taitannguyen17022005-dev/BEE-1012-PAY-IF-V110/08_REF/CONNECTOR_EXP_3.png

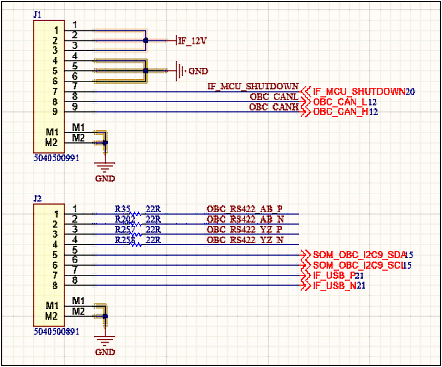
08_REF/CONNECTOR_EXP_3.png
