taitannguyen17022005-dev/BEE-1012-PAY-IF-V110/08_REF/CONNECTOR_INTERFACE_5.png

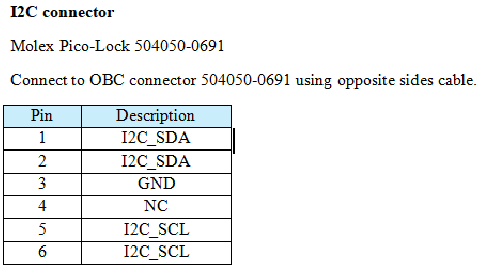
08_REF/CONNECTOR_INTERFACE_5.png
