taitannguyen17022005-dev/BEE-1012-PAY-IF-V110/08_REF/FPGA_PART1_2.png

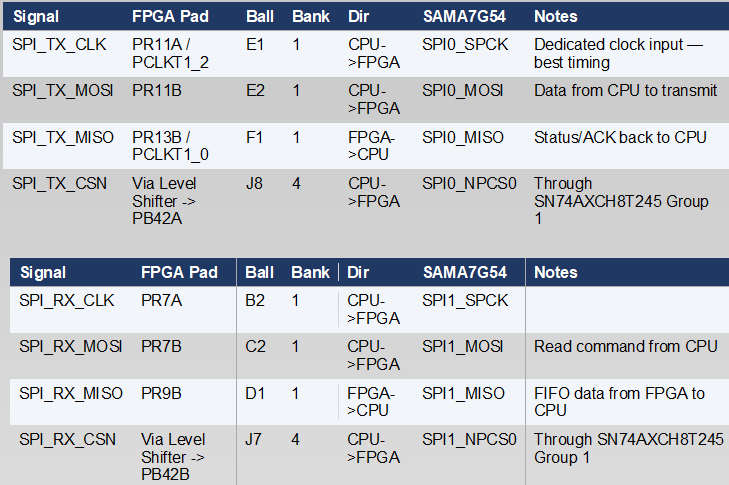
08_REF/FPGA_PART1_2.png
