taitannguyen17022005-dev/BEE-1012-PAY-IF-V110/08_REF/PowerTree.png

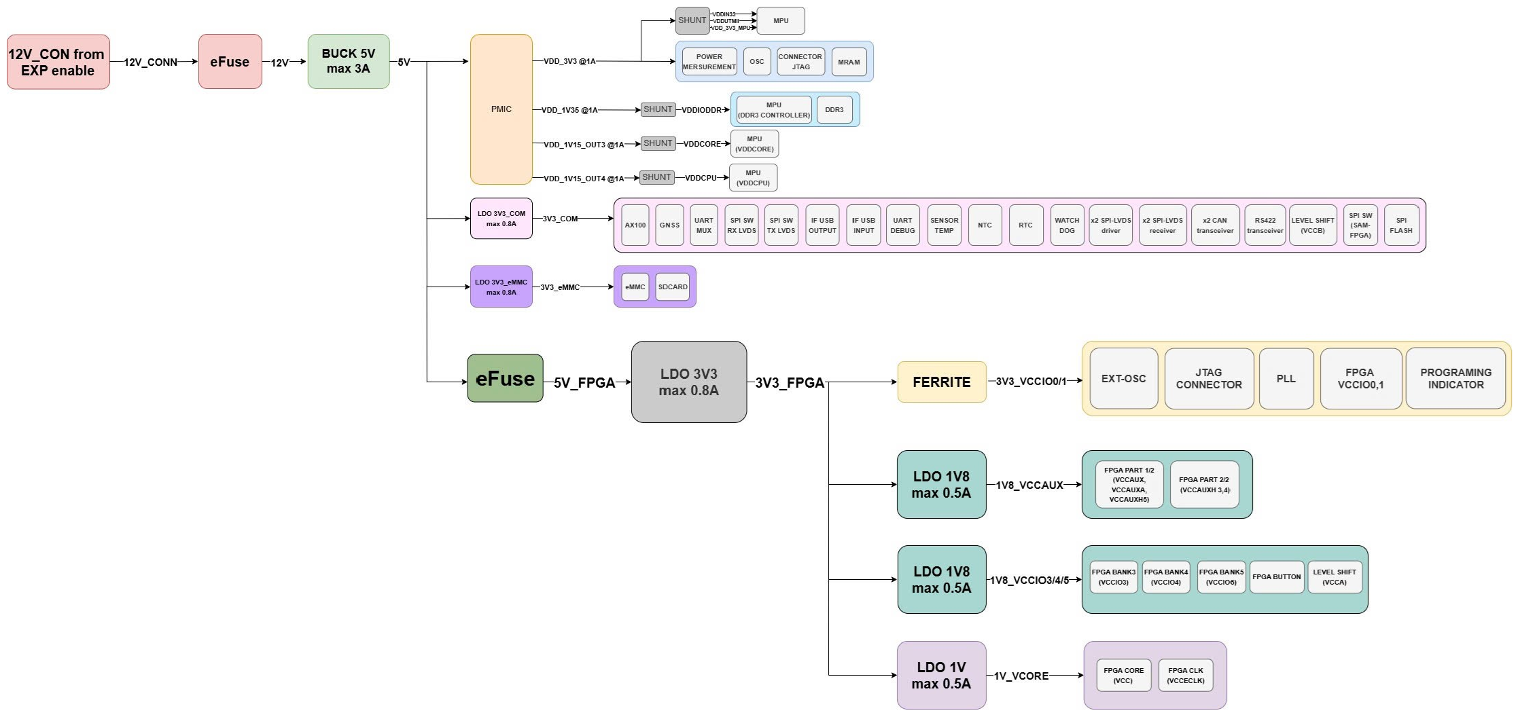
08_REF/PowerTree.png
