taitannguyen17022005-dev/BEE-1012-PAY-IF-V110/08_REF/SAMA7G54_MPU.png

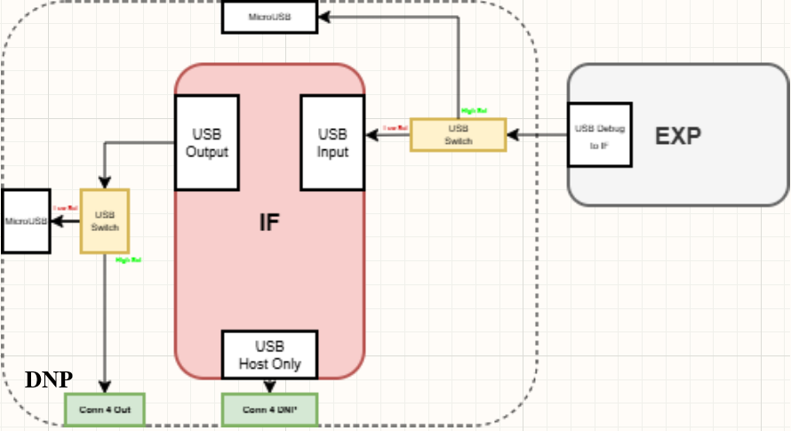
08_REF/SAMA7G54_MPU.png
