taitannguyen17022005-dev/BEE-1012-PAY-IF-V110/08_REF/SN74LV4052APWR.png

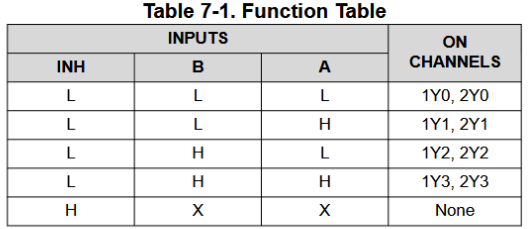
08_REF/SN74LV4052APWR.png
