taitannguyen17022005-dev/BEE-1012-PAY-IF-V110/08_REF/USB_SWITCH.png

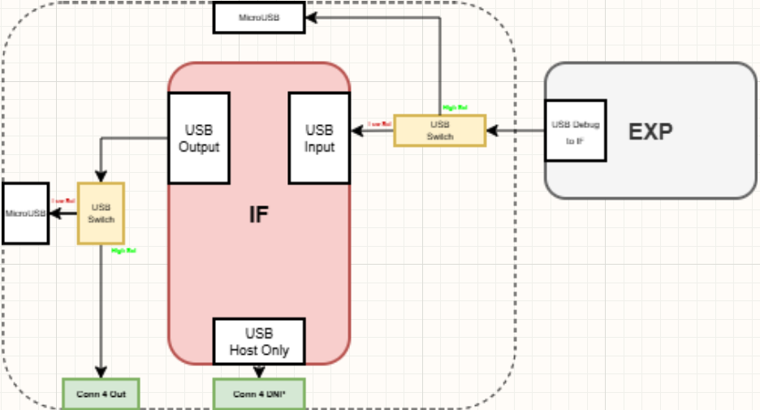
08_REF/USB_SWITCH.png
