taitannguyen17022005-dev/BEE-1012-PAY-IF-V110/09_LIB/Jumpers/Jumper2-blue.step

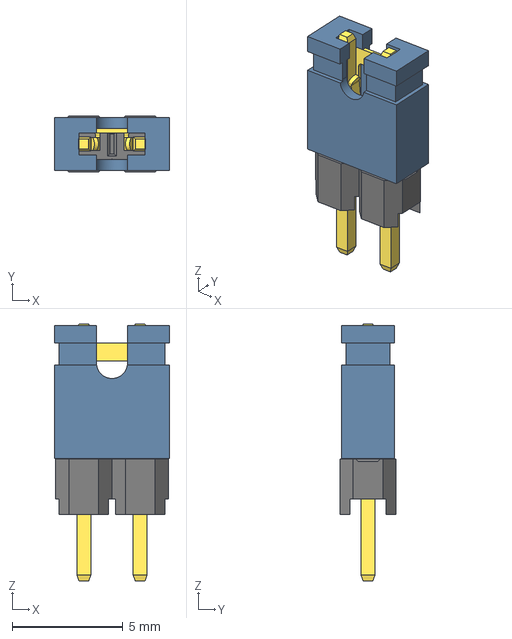
[picture p40: CAD file, 2026-08-20]
09_LIB/Jumpers/Jumper2-blue.step
5.20 x 2.54 x 11.6 mm
