taitannguyen17022005-dev/BEE-1012-PAY-IF-V110/09_LIB/TFBGA343_4HB_MCH.step

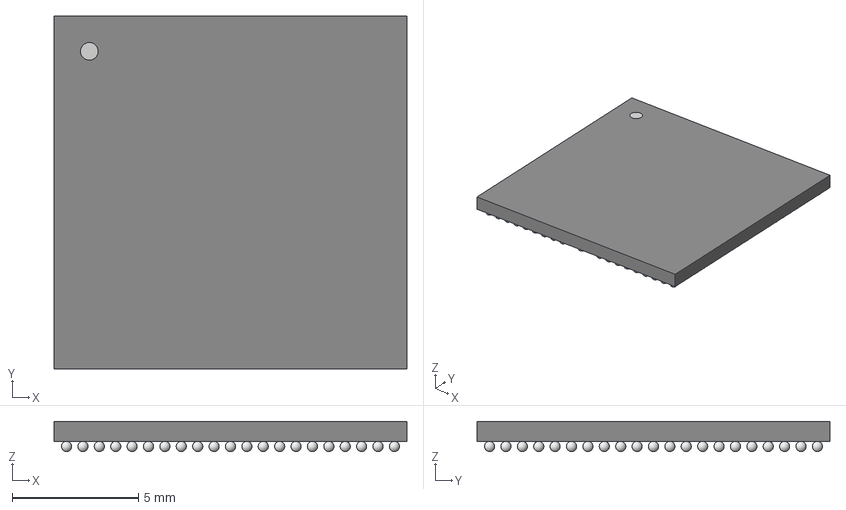
[picture p41: CAD file, 2026-08-20]
09_LIB/TFBGA343_4HB_MCH.step
14.0 x 14.0 x 1.20 mm
