taitannguyen17022005-dev/BEE-1012-PAY-IF-V110/09_LIB/Jumpers/Jumper3-blue.step

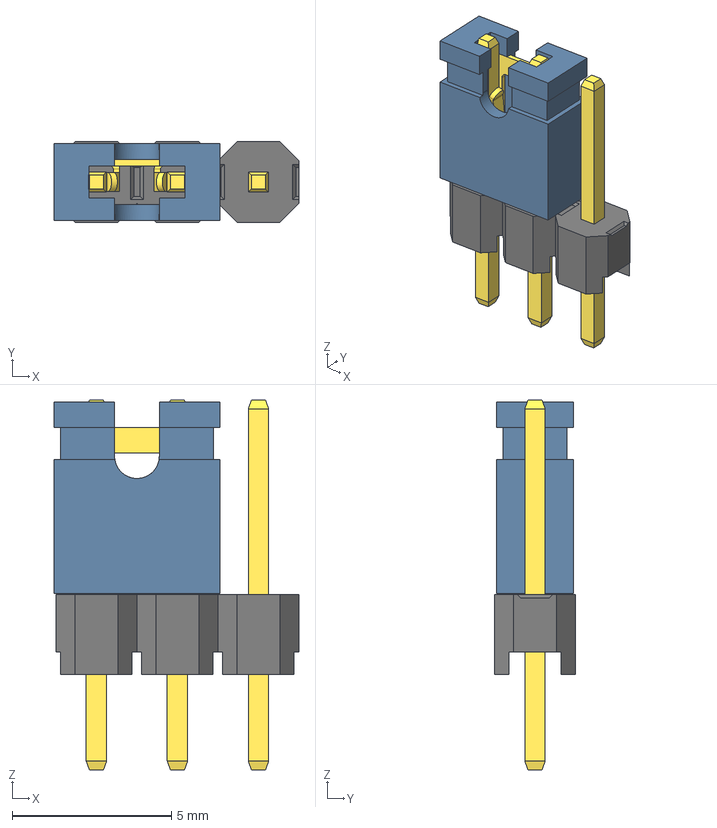
[picture p42: CAD file, 2026-08-20]
09_LIB/Jumpers/Jumper3-blue.step
7.68 x 2.54 x 11.6 mm
