taitannguyen17022005-dev/BEE-1012-PAY-IF-V110/09_LIB/BNO085.stp

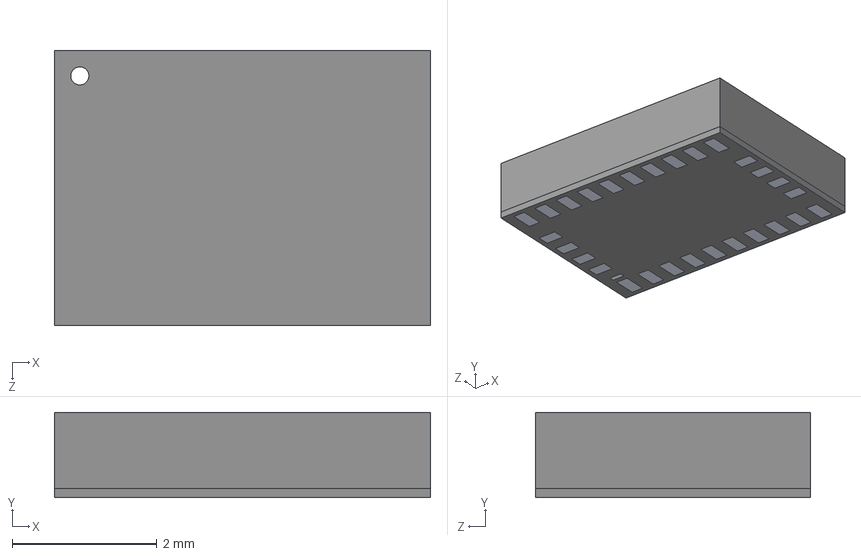
[picture p43: CAD file, 2026-08-20]
09_LIB/BNO085.stp
5.20 x 1.18 x 3.80 mm
