taitannguyen17022005-dev/BEE-1012-PAY-IF-V110/09_LIB/Jumpers/Jumper-red.step

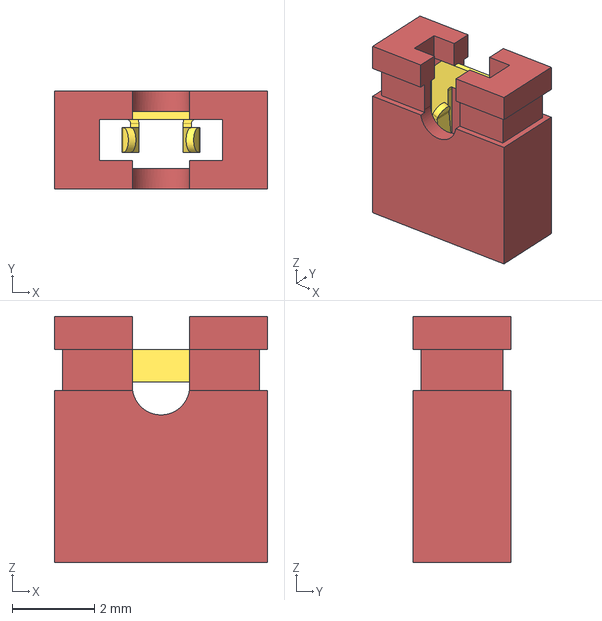
[picture p44: CAD file, 2026-08-20]
09_LIB/Jumpers/Jumper-red.step
5.20 x 2.40 x 6.00 mm
