taitannguyen17022005-dev/BEE-1012-PAY-IF-V110/(list of files, cad)

Other CAD files:
09_LIB/Jumper2.step
09_LIB/Jumper2-yellow.step
09_LIB/Jumpers/Jumper2-green.step
09_LIB/Jumpers/Jumper3-red.step
09_LIB/Jumpers/Jumper-green.step
09_LIB/Jumpers/Jumper2.step
09_LIB/Jumpers/Jumper3.step
09_LIB/Jumpers/Jumper3-green.step
09_LIB/Jumpers/Jumper2-red.step
09_LIB/Jumpers/Jumper.step
09_LIB/Jumpers/Jumper-yellow.step
09_LIB/Jumpers/Jumper3-yellow.step
09_LIB/Jumpers/Jumper-blue.step
09_LIB/Jumpers/Jumper2-yellow.step
