taitannguyen17022005-dev/BEE-1012-PAY-IF-V110/(list of files, drawings)

Other design files:
09_LIB/IFBpcblib_offline.PcbLib
09_LIB/IFBschelib_offline.SchLib
09_LIB/LABLIB.PcbLib
09_LIB/LABLIB.SchLib
