taitannguyen17022005-dev/BEE-1012-PAY-IF-V110/01_DESIGN/BEE-1012_PAY-IF_V110/_restore_backup_2026-08-10T14-50-42-868/BEE-1012_PAY-IF_V110.kicad_pcb

## KiCad design 01_DESIGN/BEE-1012_PAY-IF_V110/_restore_backup_2026-08-10T14-50-42-868/BEE-1012_PAY-IF_V110.kicad_pcb (2026-08-20)

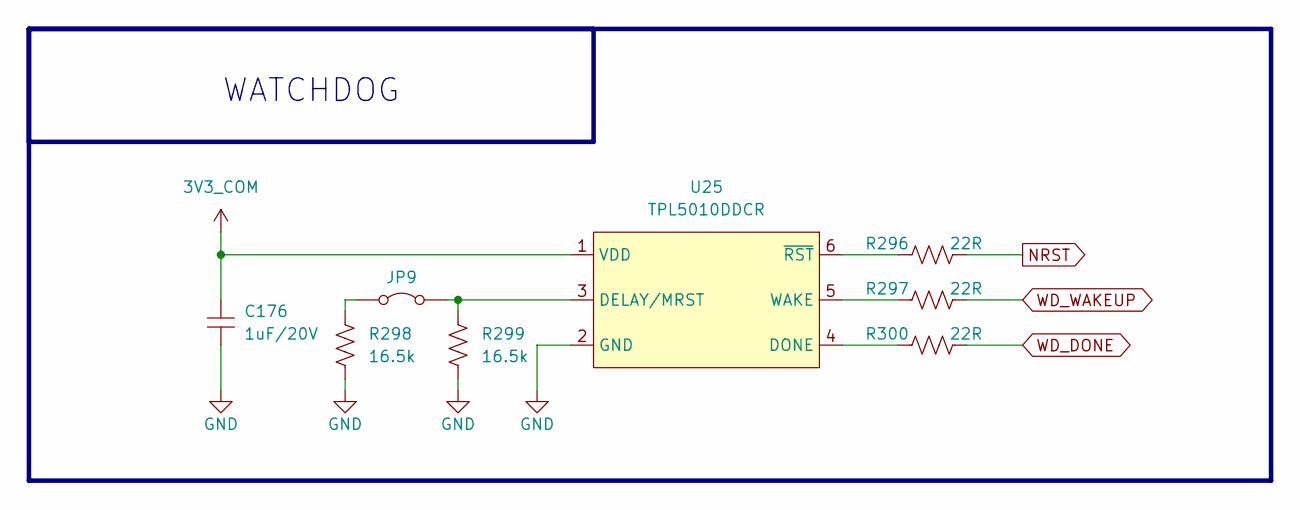
[picture p45: schematic WATCHDOG.kicad_sch, BEE]

Parts:
C176: 1uF/20V; CAP_C_1005X50_L
JP9: Jumper_2_Bridged; JUMPER_1608
R296, R297, R300: 22R; RES_C_1005x30_L
R298, R299: 16.5k; RES_C_1005x30_L
U25: TPL5010DDCR

Connections:
3V3_COM: C176.2, U25.1 (VDD); also elsewhere on the board
GND: C176.1, R298.2, R299.2, U25.2 (GND); also elsewhere on the board
NRST: R296.2; also elsewhere on the board
unnamed: JP9.1 (A), R298.1
unnamed: JP9.2 (B), R299.1, U25.3 (DELAY/MRST)
unnamed: R300.1, U25.4 (DONE)
unnamed: R297.1, U25.5 (WAKE)
unnamed: R296.1, U25.6 (~RST)
WD_DONE: R300.2; also elsewhere on the board
WD_WAKEUP: R297.2; also elsewhere on the board

Notes on the sheet:
WATCHDOG

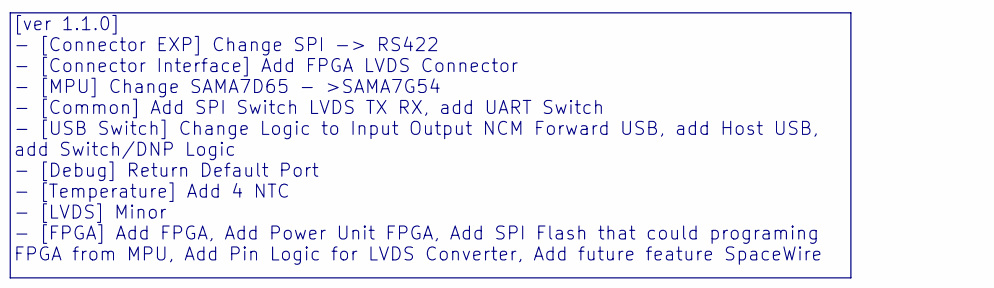
[picture p46: schematic ChangeNote.kicad_sch, BEE]

Notes on the sheet:
[ver 1.1.0] - [Connector EXP] Change SPI -> RS422 - [Connector Interface] Add FPGA LVDS Connector - [MPU] Change SAMA7D65 - >SAMA7G54 - [Common] Add SPI Switch LVDS TX RX, add UART Switch - [USB Switch] Change Logic to Input Output NCM Forward USB, add Host USB, add Switch/DNP Logic - [Debug] Retur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

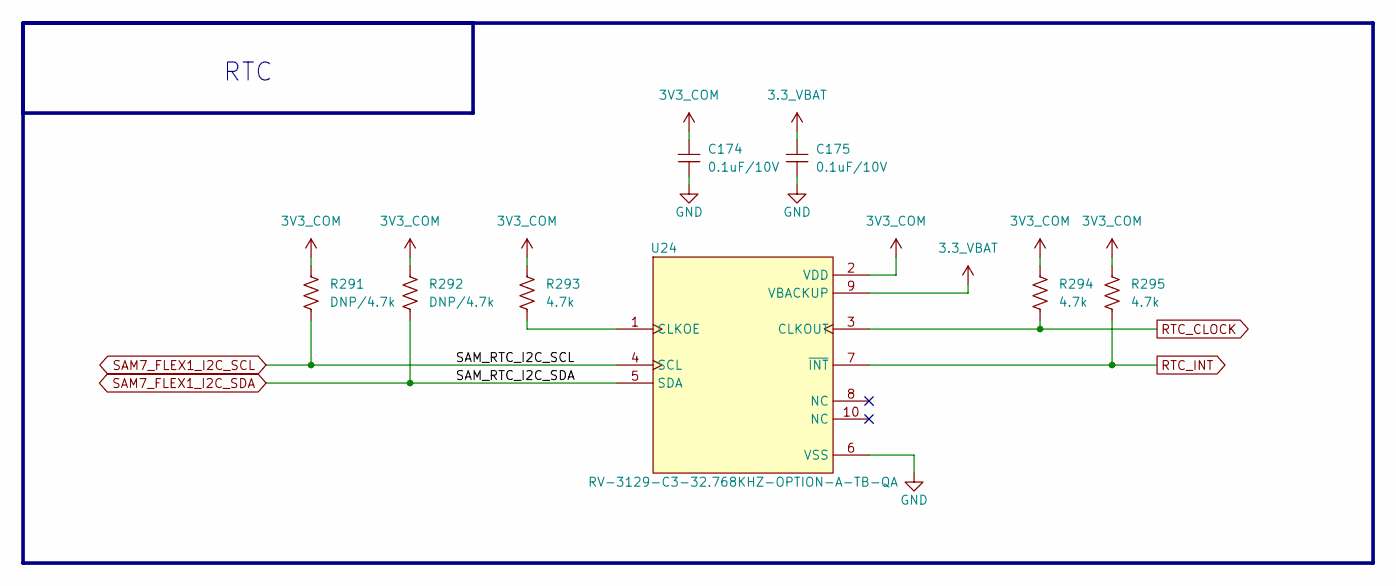
[picture p47: schematic RTC.kicad_sch, BEE]

Parts:
C174, C175: 0.1uF/10V; CAP_C_1005X50_L
R291, R292: DNP/4.7k; RES_C_1005x30_L
R293, R294, R295: 4.7k; RES_C_1005x30_L
U24: RV-3129-C3-32.768KHZ-OPTION-A-TB-QA; IC_RV-3129-C3-32.768KHZ-OPTION-A-TB-QA

Connections:
3.3_VBAT: C175.2, U24.9 (VBACKUP); also elsewhere on the board
3V3_COM: C174.2, R291.1, R292.1, R293.1, R294.1, R295.1, U24.2 (VDD); also elsewhere on the board
GND: C174.1, C175.1, U24.6 (VSS); also elsewhere on the board
unnamed: R293.2, U24.1 (CLKOE)
RTC_CLOCK: R294.2, U24.3 (CLKOUT); also elsewhere on the board
RTC_INT: R295.2, U24.7 (~INT); also elsewhere on the board
SAM7_FLEX1_I2C_SCL: R291.2, U24.4 (SCL); also elsewhere on the board
SAM7_FLEX1_I2C_SDA: R292.2, U24.5 (SDA); also elsewhere on the board

Notes on the sheet:
RTC

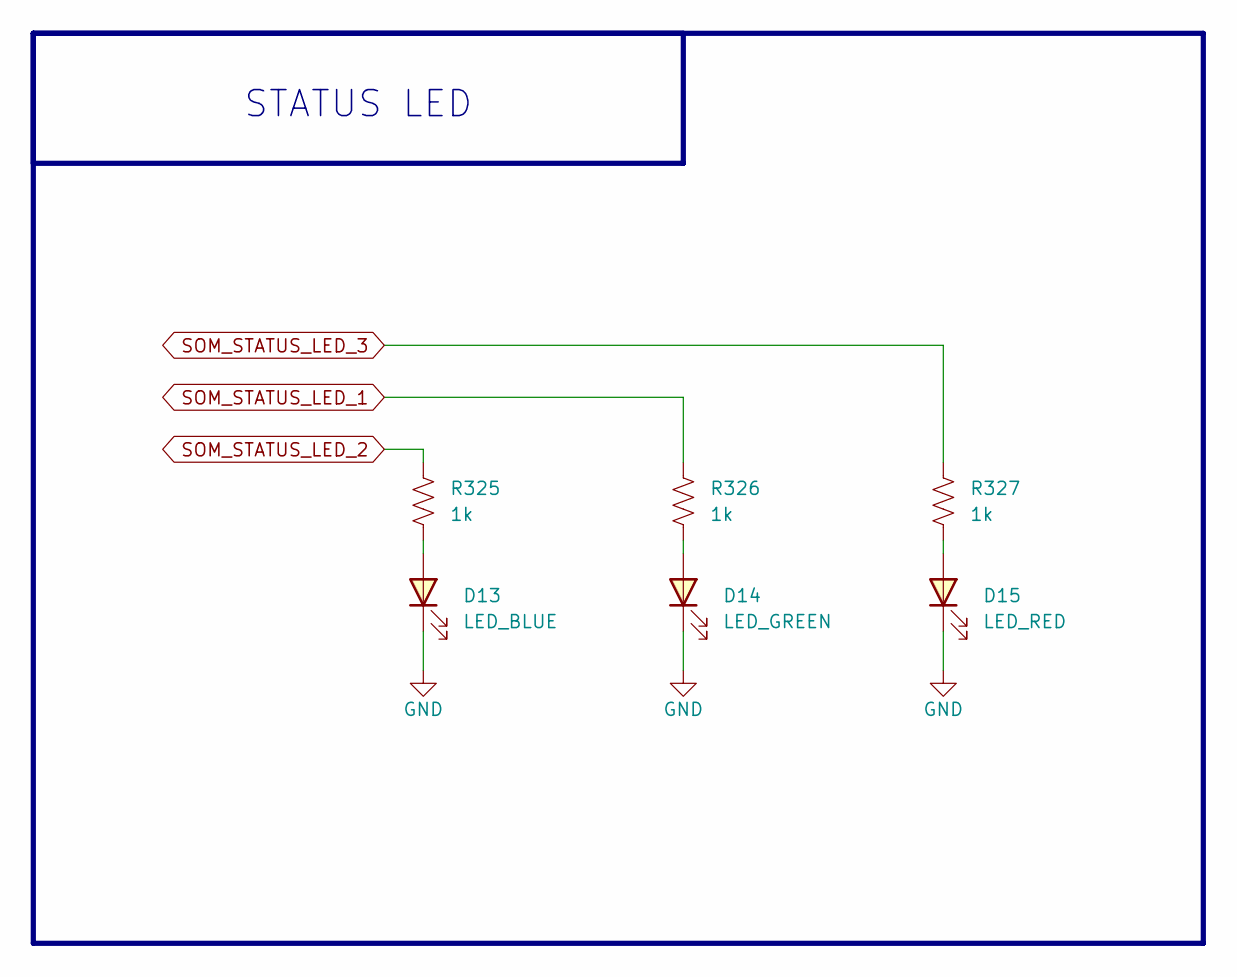
[picture p48: schematic BUTTON_LED.kicad_sch, BEE]

Parts:
D13: LED_BLUE; LED_0603_1608Metric
D14: LED_GREEN; LED_0603_1608Metric
D15: LED_RED; LED_0603_1608Metric
R325, R326, R327: 1k; RES_C_1005x30_L

Connections:
GND: D13.1 (K), D14.1 (K), D15.1 (K); also elsewhere on the board
unnamed: D13.2 (A), R325.2
unnamed: D14.2 (A), R326.2
unnamed: D15.2 (A), R327.2
SOM_STATUS_LED_1: R326.1; also elsewhere on the board
SOM_STATUS_LED_2: R325.1; also elsewhere on the board
SOM_STATUS_LED_3: R327.1; also elsewhere on the board

Notes on the sheet:
STATUS LED

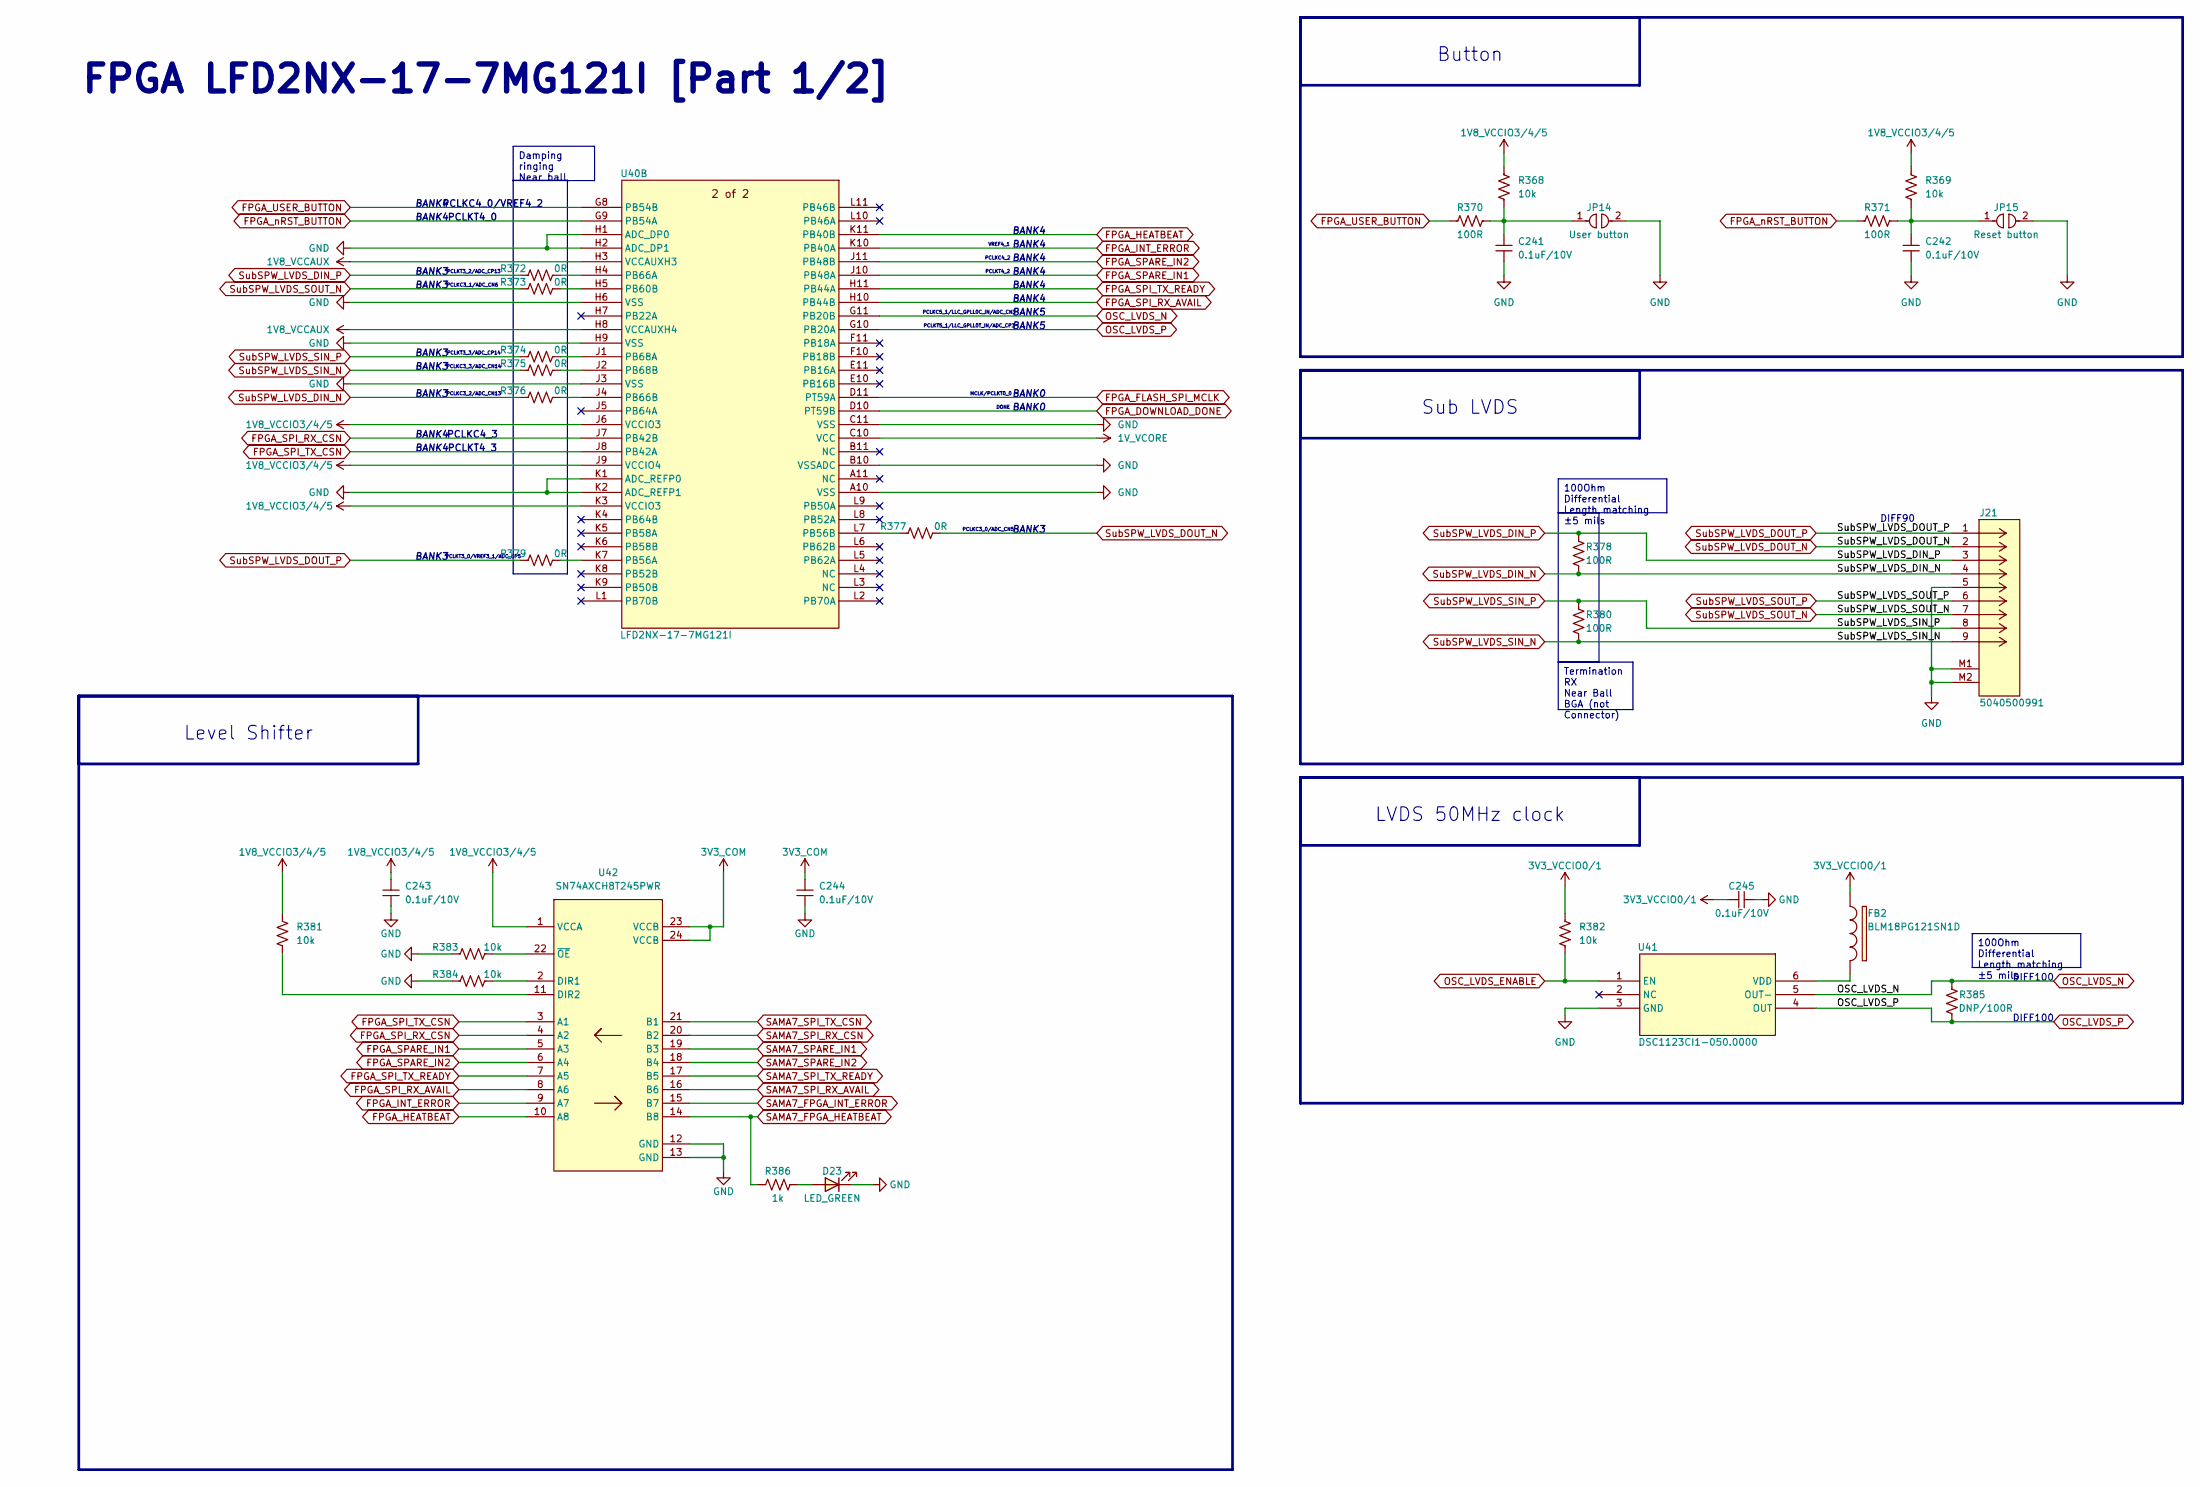
[picture p49: schematic FPGA_PART2.kicad_sch, BEE]

Parts:
C241, C242, C243, C244, C245: 0.1uF/10V; CAP_C_1005X50_L
D23: LED_GREEN; LED_0603_1608Metric
FB2: BLM18PG121SN1D; L_0603_1608Metric; Manufacturer_Part_Number BLM18PG121SN1D
J21: 5040500991; MOLEX_5040500991
JP14: User button; JUMPER_1608
JP15: Reset button; JUMPER_1608
R368, R369, R381, R382, R383, R384: 10k; RES_C_1005x30_L
R370, R371, R378, R380: 100R; RES_C_1005x30_L
R372, R373, R374, R375, R376, R377, R379: 0R; RES_C_1005x30_L
R385: DNP/100R; RES_C_1005x30_L
R386: 1k; RES_C_1005x30_L
U40: LFD2NX-17-7MG121I; csfBGA121_LAT; Manufacturer_Part_Number LFD2NX-17-7MG121I
U41: DSC1123CI1-050.0000; VDFN6_3P2X2P5_MCH; Manufacturer_Part_Number DSC1103CI2-180.0000T
U42: SN74AXCH8T245PWR; SOP65P640X120-24N

Connections:
1V8_VCCAUX: U40.H3 (VCCAUXH3), U40.H8 (VCCAUXH4); also elsewhere on the board
1V8_VCCIO3/4/5: C243.2, R368.2, R369.2, R381.1, U40.J6 (VCCIO3), U40.J9 (VCCIO4), U40.K3 (VCCIO3), U42.1 (VCCA); also elsewhere on the board
1V_VCORE: U40.C10 (VCC); also elsewhere on the board
3V3_COM: C244.2, U42.23 (VCCB), U42.24 (VCCB); also elsewhere on the board
3V3_VCCIO0/1: C245.2, FB2.2, R382.2; also elsewhere on the board
FPGA_DOWNLOAD_DONE: U40.D10 (PT59B); also elsewhere on the board
FPGA_FLASH_SPI_MCLK: U40.D11 (PT59A); also elsewhere on the board
FPGA_HEATBEAT: U40.K11 (PB40B), U42.10 (A8)
FPGA_INT_ERROR: U40.K10 (PB40A), U42.9 (A7)
FPGA_SPARE_IN1: U40.J10 (PB48A), U42.5 (A3)
FPGA_SPARE_IN2: U40.J11 (PB48B), U42.6 (A4)
FPGA_SPI_RX_AVAIL: U40.H10 (PB44B), U42.8 (A6)
FPGA_SPI_RX_CSN: U40.J7 (PB42B), U42.4 (A2)
FPGA_SPI_TX_CSN: U40.J8 (PB42A), U42.3 (A1)
FPGA_SPI_TX_READY: U40.H11 (PB44A), U42.7 (A5)
FPGA_USER_BUTTON: R370.1, U40.G8 (PB54B)
FPGA_nRST_BUTTON: R371.1, U40.G9 (PB54A)
GND: C241.1, C242.1, C243.1, C244.1, C245.1, D23.1 (K), J21.5, J21.M1, J21.M2, JP14.2, JP15.2, R383.1, R384.1, U40.A10 (VSS), U40.B10 (VSSADC), U40.C11 (VSS), U40.H1 (ADC_DP0), U40.H2 (ADC_DP1), U40.H6 (VSS), U40.H9 (VSS), U40.J3 (VSS), U40.K1 (ADC_REFP0), U40.K2 (ADC_REFP1), U41.3 (GND), U42.12 (GND), U42.13 (GND); also elsewhere on the board
unnamed: C241.2, JP14.1, R368.1, R370.2
unnamed: C242.2, JP15.1, R369.1, R371.2
unnamed: D23.2 (A), R386.2
unnamed: R379.2, U40.K7 (PB56A)
unnamed: R377.1, U40.L7 (PB56B)
unnamed: R373.2, U40.H5 (PB60B)
unnamed: R372.2, U40.H4 (PB66A)
unnamed: R376.2, U40.J4 (PB66B)
unnamed: R374.2, U40.J1 (PB68A)
unnamed: R375.2, U40.J2 (PB68B)
unnamed: FB2.1, U41.6 (VDD)
unnamed: R384.2, U42.2 (DIR1)
unnamed: R381.2, U42.11 (DIR2)
unnamed: R383.2, U42.22 (~OE)
OSC_LVDS_ENABLE: R382.1, U41.1 (EN); also elsewhere on the board
OSC_LVDS_N: R385.2, U40.G11 (PB20B), U41.5 (OUT-)
OSC_LVDS_P: R385.1, U40.G10 (PB20A), U41.4 (OUT)
SAMA7_FPGA_HEATBEAT: R386.1, U42.14 (B8); also elsewhere on the board
SAMA7_FPGA_INT_ERROR: U42.15 (B7); also elsewhere on the board
SAMA7_SPARE_IN1: U42.19 (B3); also elsewhere on the board
SAMA7_SPARE_IN2: U42.18 (B4); also elsewhere on the board
SAMA7_SPI_RX_AVAIL: U42.16 (B6); also elsewhere on the board
SAMA7_SPI_RX_CSN: U42.20 (B2); also elsewhere on the board
SAMA7_SPI_TX_CSN: U42.21 (B1); also elsewhere on the board
SAMA7_SPI_TX_READY: U42.17 (B5); also elsewhere on the board
SubSPW_LVDS_DIN_N: J21.4, R376.1, R378.1
SubSPW_LVDS_DIN_P: J21.3, R372.1, R378.2
SubSPW_LVDS_DOUT_N: J21.2, R377.2
SubSPW_LVDS_DOUT_P: J21.1, R379.1
SubSPW_LVDS_SIN_N: J21.9, R375.1, R380.1
SubSPW_LVDS_SIN_P: J21.8, R374.1, R380.2
SubSPW_LVDS_SOUT_N: J21.7, R373.1
SubSPW_LVDS_SOUT_P: J21.6; also elsewhere on the board

Notes on the sheet:
PCLKT3_3/ADC_CP14
MCLK/PCLKT0_0
BANK5
FPGA LFD2NX-17-7MG121I [Part 1/2]
PCLKT5_1/LLC_GPLL0T_IN/ADC_CP3
BANK3
DIFF100
Level Shifter
PCLKC4_3
BANK0
Button
PCLKT3_0/VREF3_1/ADC_CP5
Sub LVDS
PCLKT4_2
DONE
BANK4
PCLKT3_2/ADC_CP13
PCLKC4_2
VREF4_1
LVDS 50MHz clock
PCLKC3_0/ADC_CN5
PCLKT4_3
PCLKC4_0/VREF4_2
PCLKC3_1/ADC_CN6
PCLKC3_2/ADC_CN13
PCLKC3_3/ADC_CN14
DIFF90
PCLKT4_0
PCLKC5_1/LLC_GPLL0C_IN/ADC_CN3
100Ohm Differential Length matching ±5 mils
Damping ringing Near ball
Termination RX Near Ball BGA (not Connector)

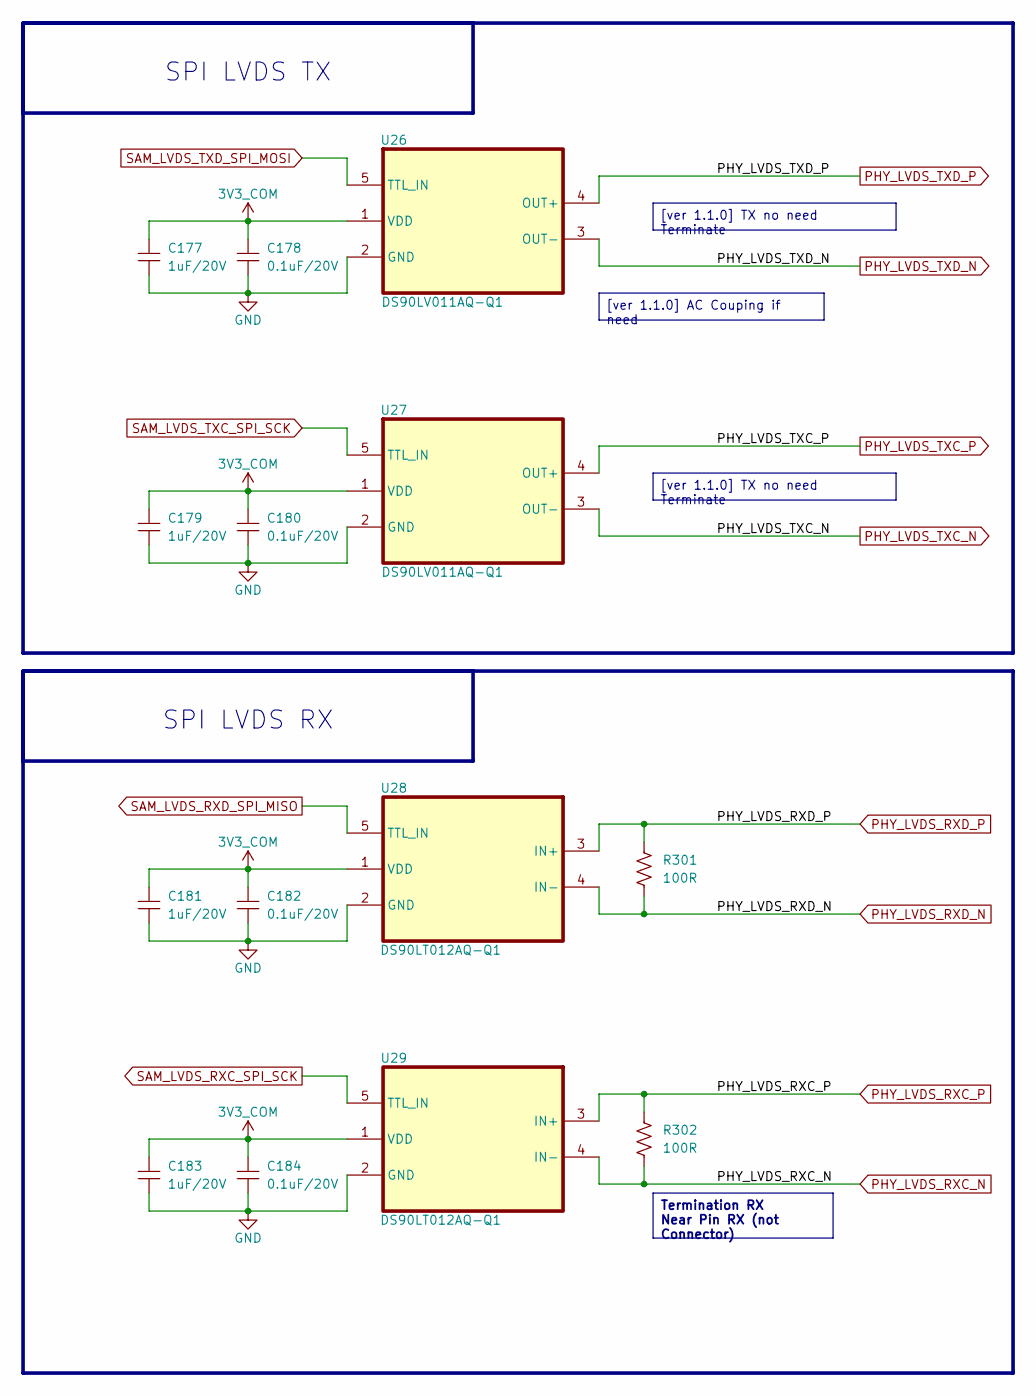
[picture p50: schematic LVDS.kicad_sch, BEE]

Parts:
C177, C179, C181, C183: 1uF/20V; CAP_C_1005X50_L
C178, C180, C182, C184: 0.1uF/20V; CAP_C_1005X50_L
R301, R302: 100R; RES_C_1005x30_L
U26, U27: DS90LV011AQ-Q1
U28, U29: DS90LT012AQ-Q1; DS90LV011AQ-Q1

Connections:
3V3_COM: C177.2, C178.2, C179.2, C180.2, C181.2, C182.2, C183.2, C184.2, U26.1 (VDD), U27.1 (VDD), U28.1 (VDD), U29.1 (VDD); also elsewhere on the board
GND: C177.1, C178.1, C179.1, C180.1, C181.1, C182.1, C183.1, C184.1, U26.2 (GND), U27.2 (GND), U28.2 (GND), U29.2 (GND); also elsewhere on the board
PHY_LVDS_RXC_N: R302.2, U29.4 (IN-); also elsewhere on the board
PHY_LVDS_RXC_P: R302.1, U29.3 (IN+); also elsewhere on the board
PHY_LVDS_RXD_N: R301.2, U28.4 (IN-); also elsewhere on the board
PHY_LVDS_RXD_P: R301.1, U28.3 (IN+); also elsewhere on the board
PHY_LVDS_TXC_N: U27.3 (OUT-); also elsewhere on the board
PHY_LVDS_TXC_P: U27.4 (OUT+); also elsewhere on the board
PHY_LVDS_TXD_N: U26.3 (OUT-); also elsewhere on the board
PHY_LVDS_TXD_P: U26.4 (OUT+); also elsewhere on the board
SAM_LVDS_RXC_SPI_SCK: U29.5 (TTL_IN); also elsewhere on the board
SAM_LVDS_RXD_SPI_MISO: U28.5 (TTL_IN); also elsewhere on the board
SAM_LVDS_TXC_SPI_SCK: U27.5 (TTL_IN); also elsewhere on the board
SAM_LVDS_TXD_SPI_MOSI: U26.5 (TTL_IN); also elsewhere on the board

Notes on the sheet:
SPI LVDS TX
SPI LVDS RX
[ver 1.1.0] TX no need Terminate
[ver 1.1.0] AC Couping if need
Termination RX Near Pin RX (not Connector)

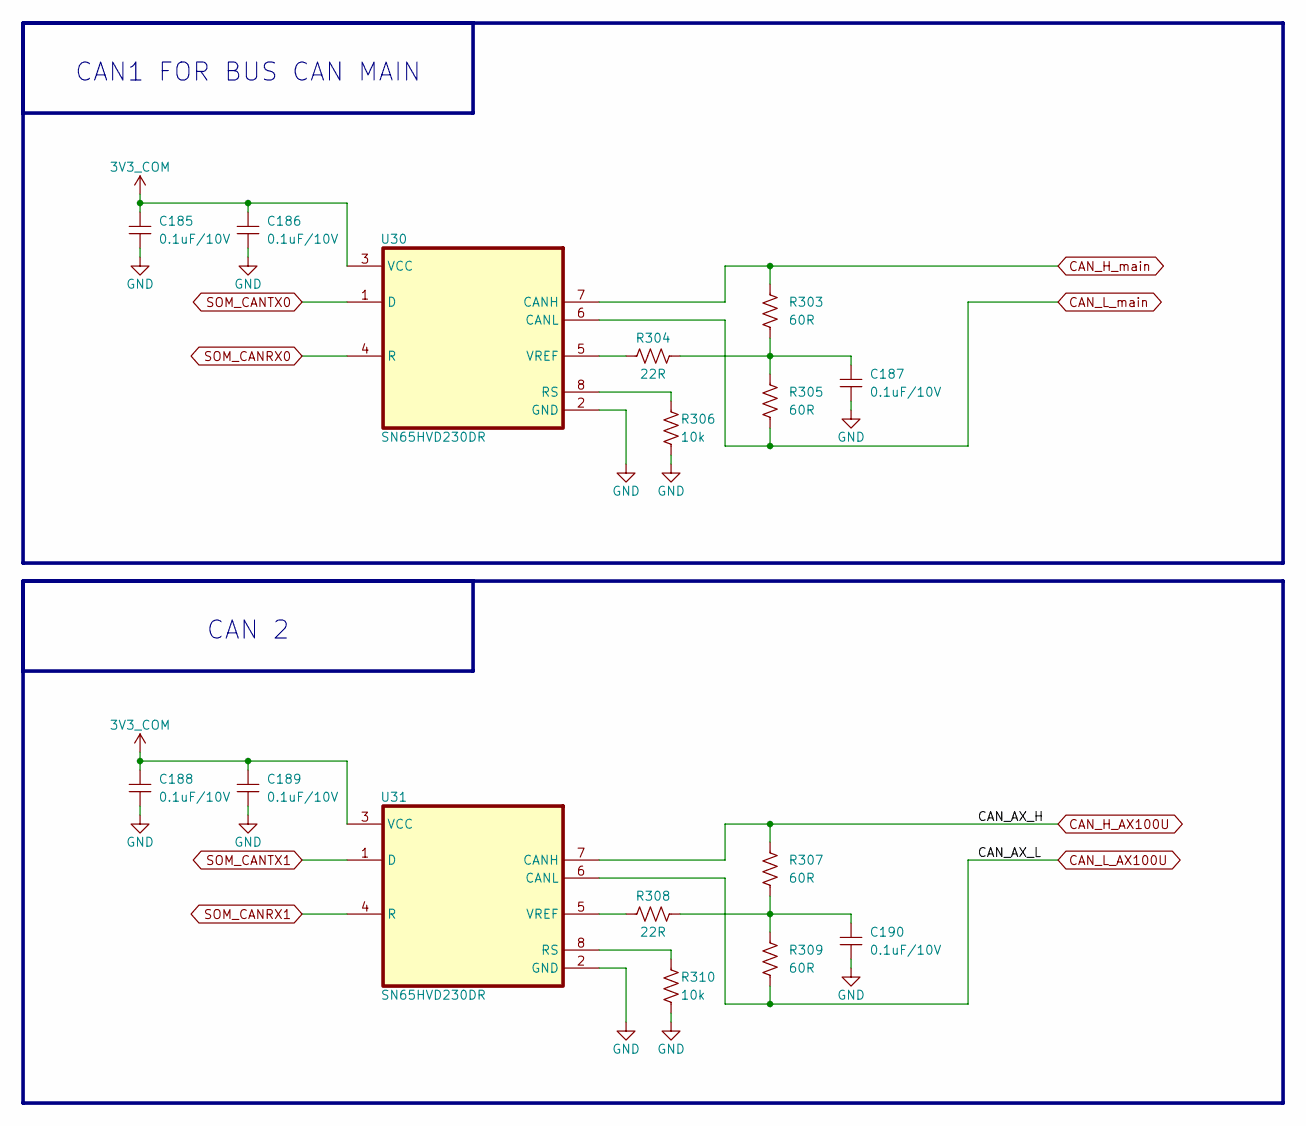
[picture p51: schematic CAN_PHY.kicad_sch, BEE]

Parts:
C185, C186, C187, C188, C189, C190: 0.1uF/10V; CAP_C_1005X50_L
R303, R305, R307, R309: 60R; RES_C_1005x30_L
R304, R308: 22R; RES_C_1005x30_L
R306, R310: 10k; RES_C_1005x30_L
U30, U31: SN65HVD230DR; SOIC127P602X173-8N

Connections:
3V3_COM: C185.2, C186.2, C188.2, C189.2, U30.3 (VCC), U31.3 (VCC); also elsewhere on the board
CAN_H_AX100U: R307.1, U31.7 (CANH); also elsewhere on the board
CAN_H_main: R303.1, U30.7 (CANH); also elsewhere on the board
CAN_L_AX100U: R309.2, U31.6 (CANL); also elsewhere on the board
CAN_L_main: R305.2, U30.6 (CANL); also elsewhere on the board
GND: C185.1, C186.1, C187.1, C188.1, C189.1, C190.1, R306.2, R310.2, U30.2 (GND), U31.2 (GND); also elsewhere on the board
unnamed: C187.2, R303.2, R304.2, R305.1
unnamed: C190.2, R307.2, R308.2, R309.1
unnamed: R306.1, U30.8 (RS)
unnamed: R304.1, U30.5 (VREF)
unnamed: R310.1, U31.8 (RS)
unnamed: R308.1, U31.5 (VREF)
SOM_CANRX0: U30.4 (R); also elsewhere on the board
SOM_CANRX1: U31.4 (R); also elsewhere on the board
SOM_CANTX0: U30.1 (D); also elsewhere on the board
SOM_CANTX1: U31.1 (D); also elsewhere on the board

Notes on the sheet:
CAN1 FOR BUS CAN MAIN
CAN 2

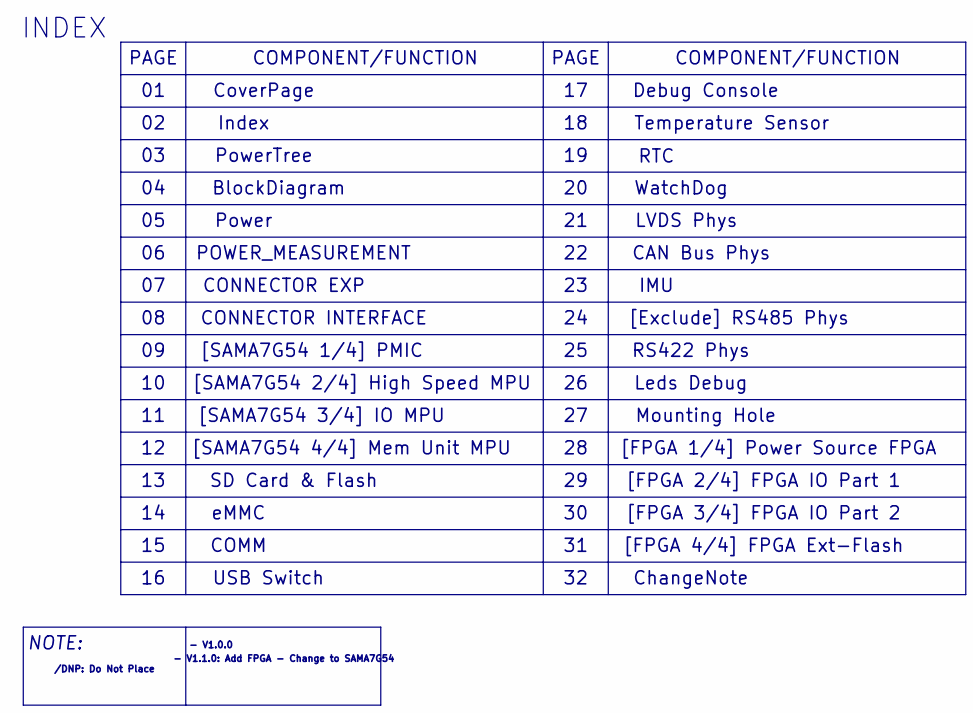
[picture p52: schematic INDEX.kicad_sch, BEE]

Notes on the sheet:
COMPONENT/FUNCTION
[SAMA7G54 2/4] High Speed MPU
LVDS Phys
[SAMA7G54 4/4] Mem Unit MPU
CoverPage
INDEX
PAGE
WatchDog
CONNECTOR INTERFACE
Debug Console
/DNP: Do Not Place
Power
IMU
[FPGA 1/4] Power Source FPGA
[Exclude] RS485 Phys
[SAMA7G54 3/4] IO MPU
PowerTree
CAN Bus Phys
- V1.0.0
RTC
COMM
POWER_MEASUREMENT
[FPGA 2/4] FPGA IO Part 1
RS422 Phys
- V1.1.0: Add FPGA - Change to SAMA7G54
BlockDiagram
[FPGA 4/4] FPGA Ext-Flash
Leds Debug
Index
SD Card & Flash
NOTE:
[SAMA7G54 1/4] PMIC
ChangeNote
USB Switch
CONNECTOR EXP
Mounting Hole
eMMC
Temperature Sensor
[FPGA 3/4] FPGA IO Part 2

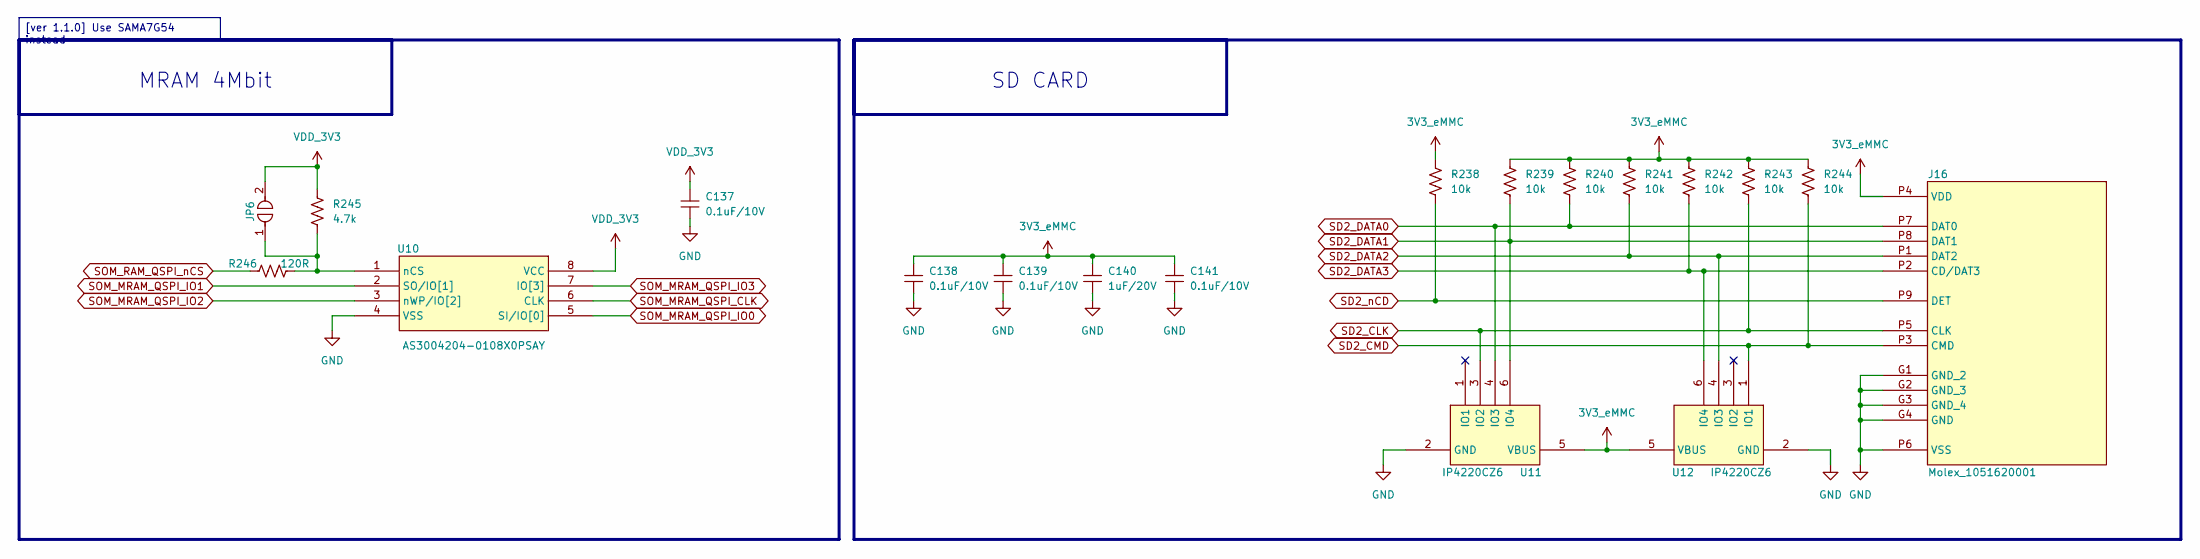
[picture p53: schematic SDCARD_FLASH.kicad_sch, BEE]

Parts:
C137, C138, C139, C141: 0.1uF/10V; CAP_C_1005X50_L
C140: 1uF/20V; CAP_C_1005X50_L
J16: Molex_1051620001; MOLEX_1051620001
JP6: JUMPER_1608
R238, R239, R240, R241, R242, R243, R244: 10k; RES_C_1005x30_L
R245: 4.7k; RES_C_1005x30_L
R246: 120R; RES_C_1005x30_L
U10: AS3004204-0108X0PSAY; SOIC127P790X216-8
U11, U12: IP4220CZ6; DIODE_SOT457_1P7X3P1_NEX; Manufacturer_Part_Number IP4220CZ6,125

Connections:
3V3_eMMC: C138.2, C139.2, C140.2, C141.2, J16.P4 (VDD), R238.1, R239.1, R240.1, R241.1, R242.1, R243.1, R244.1, U11.5 (VBUS), U12.5 (VBUS); also elsewhere on the board
GND: C137.1, C138.1, C139.1, C140.1, C141.1, J16.G1 (GND_2), J16.G2 (GND_3), J16.G3 (GND_4), J16.G4 (GND), J16.P6 (VSS), U10.4 (VSS), U11.2 (GND), U12.2 (GND); also elsewhere on the board
unnamed: JP6.1, R245.2, R246.2, U10.1 (nCS)
SD2_CLK: J16.P5 (CLK), R243.2, U11.3 (IO2); also elsewhere on the board
SD2_CMD: J16.P3 (CMD), R244.2, U12.1 (IO1); also elsewhere on the board
SD2_DATA0: J16.P7 (DAT0), R240.2, U11.4 (IO3); also elsewhere on the board
SD2_DATA1: J16.P8 (DAT1), R239.2, U11.6 (IO4); also elsewhere on the board
SD2_DATA2: J16.P1 (DAT2), R241.2, U12.4 (IO3); also elsewhere on the board
SD2_DATA3: J16.P2 (CD/DAT3), R242.2, U12.6 (IO4); also elsewhere on the board
SD2_nCD: J16.P9 (DET), R238.2; also elsewhere on the board
SOM_MRAM_QSPI_CLK: U10.6 (CLK); also elsewhere on the board
SOM_MRAM_QSPI_IO0: U10.5 (SI/IO[0]); also elsewhere on the board
SOM_MRAM_QSPI_IO1: U10.2 (SO/IO[1]); also elsewhere on the board
SOM_MRAM_QSPI_IO2: U10.3 (nWP/IO[2]); also elsewhere on the board
SOM_MRAM_QSPI_IO3: U10.7 (IO[3]); also elsewhere on the board
SOM_RAM_QSPI_nCS: R246.1; also elsewhere on the board
VDD_3V3: C137.2, JP6.2, R245.1, U10.8 (VCC); also elsewhere on the board

Notes on the sheet:
MRAM 4Mbit
SD CARD
[ver 1.1.0] Use SAMA7G54 instead
