taitannguyen17022005-dev/BEE-1012-PAY-IF-V110/01_DESIGN/BEE-1012_PAY-IF_V110/_restore_backup_2026-08-10T14-50-42-868/BEE-1012_PAY-IF_V110.kicad_pcb

## KiCad design 01_DESIGN/BEE-1012_PAY-IF_V110/_restore_backup_2026-08-10T14-50-42-868/BEE-1012_PAY-IF_V110.kicad_pcb (continued)

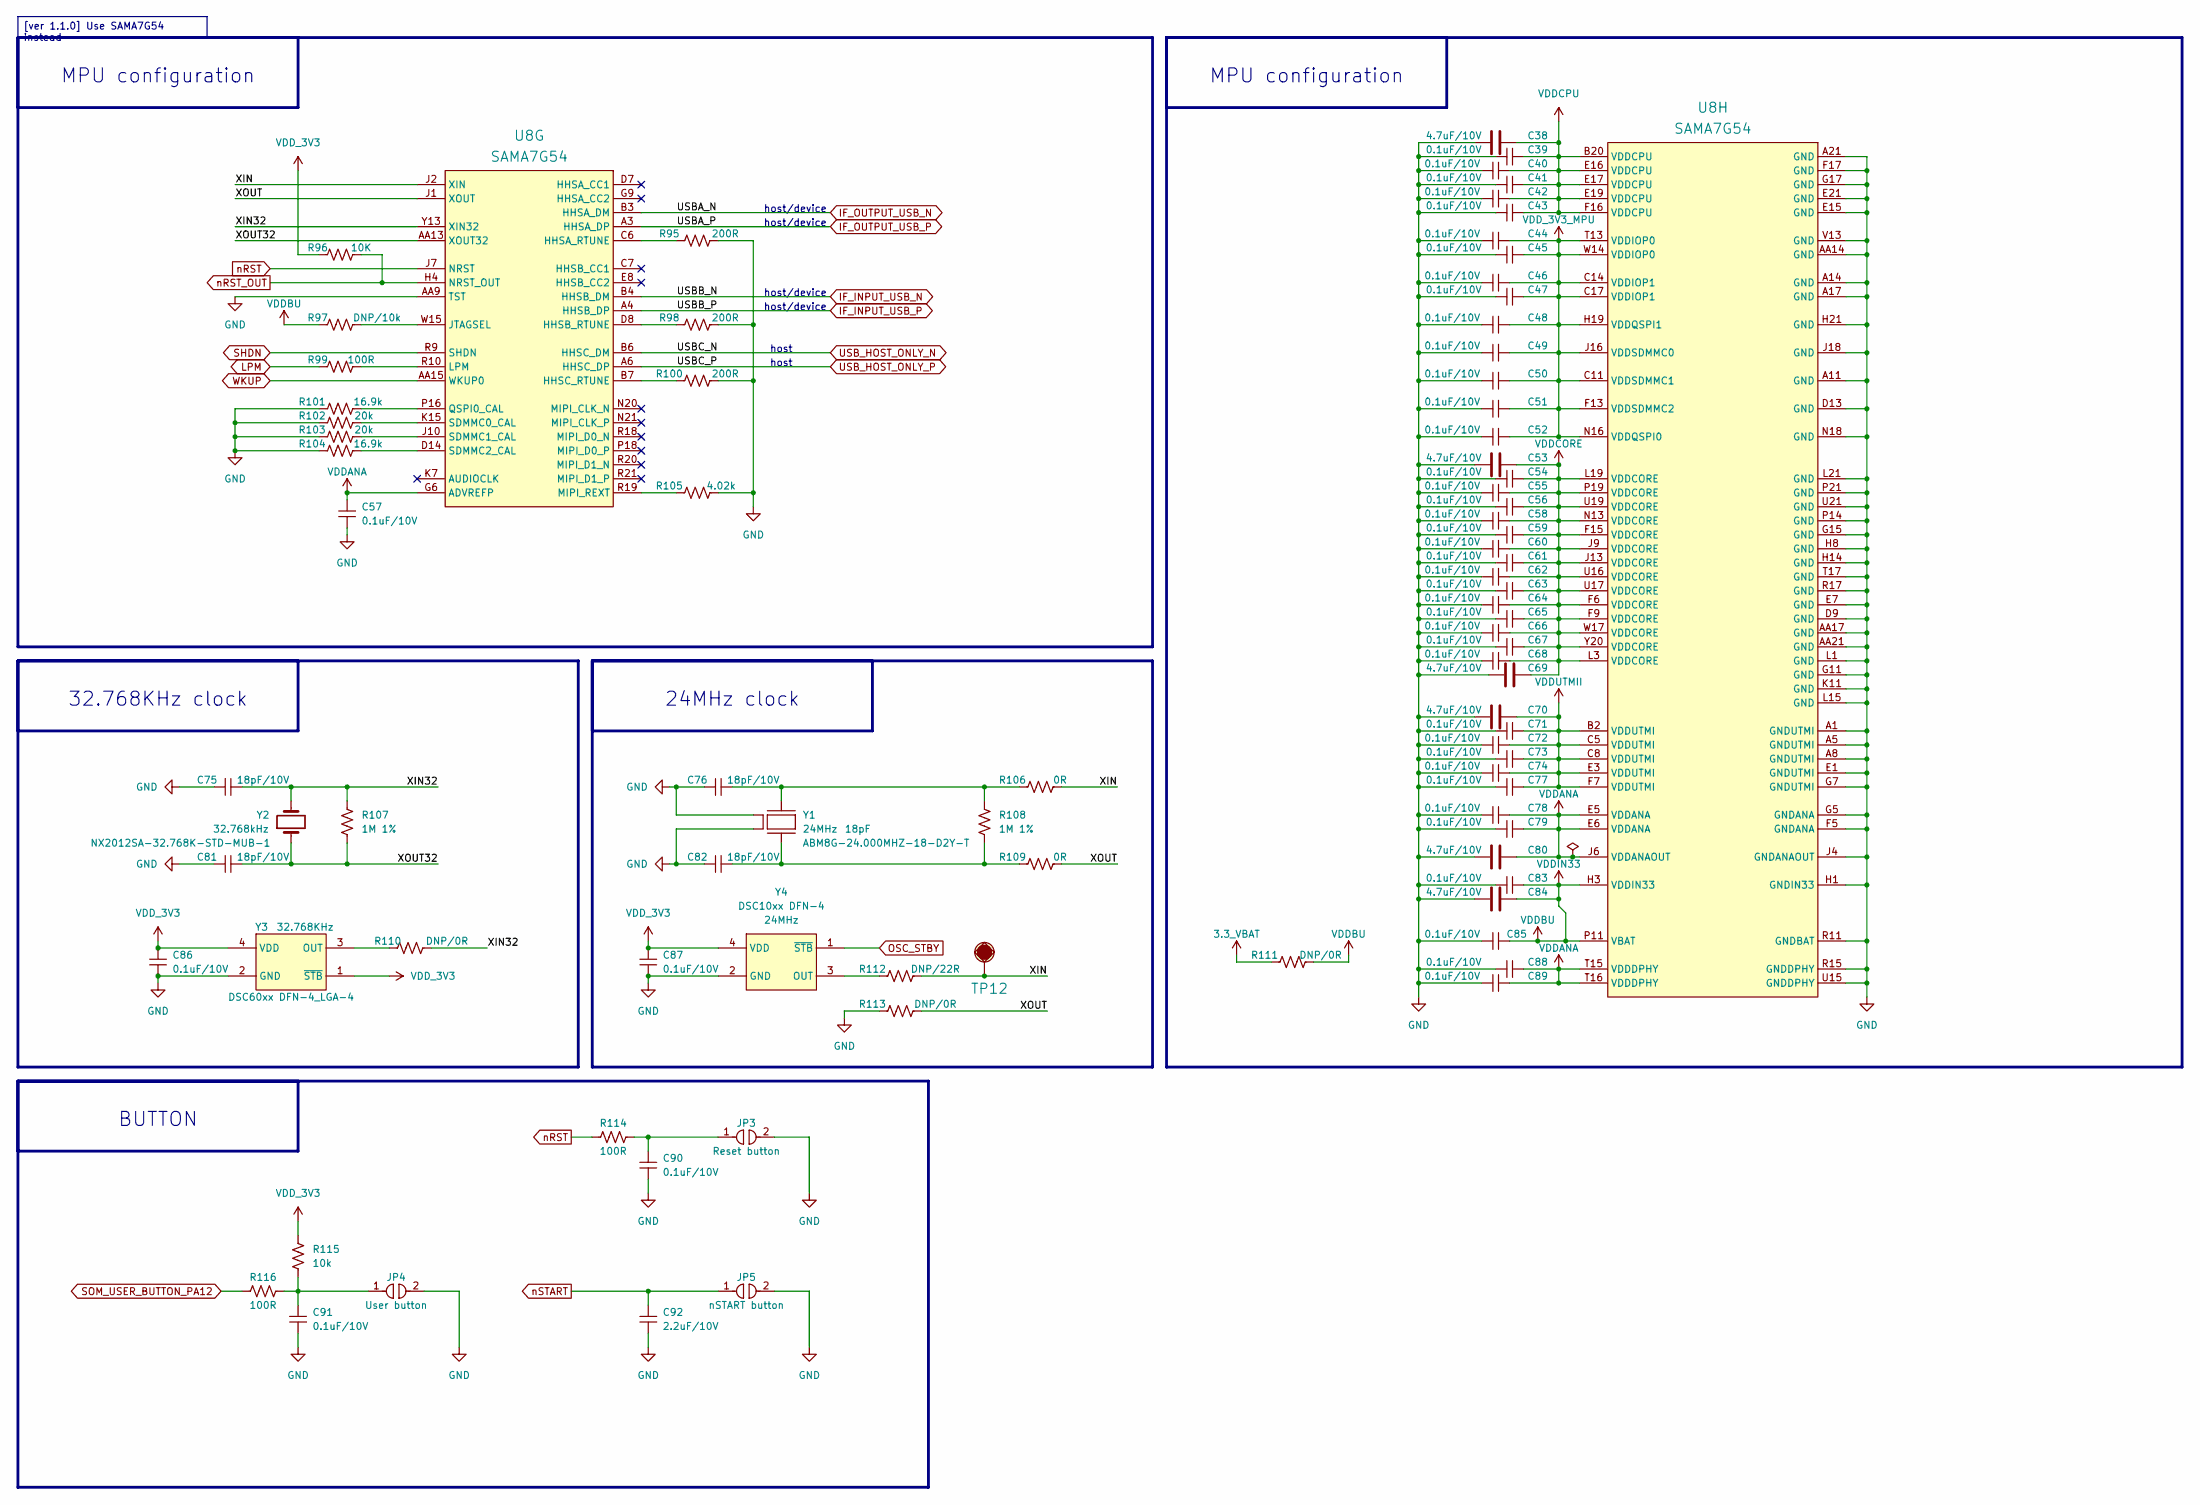
[picture p54: schematic SAMA7G54_MPU.kicad_sch, BEE]

Parts:
C38, C53, C69, C70, C80, C84: 4.7uF/10V; CAP_C_1005X50_L
C39, C40, C41, C42, C43, C44, C45, C46, C47, C48, C49, C50, C51, C52, C54, C55, C56, C57, C58, C59, C60, C61, C62, C63, C64, C65, C66, C67, C68, C71, C72, C73, C74, C77, C78, C79, C83, C85, C88, C89: 0.1uF/10V; CAP_C_0603x30
C75, C76, C81, C82: 18pF/10V; CAP_C_1005X50_L
C86, C87, C90, C91: 0.1uF/10V; CAP_C_1005X50_L
C92: 2.2uF/10V; CAP_C_1005X50_L
JP3: Reset button; JUMPER_1608
JP4: User button; JUMPER_1608
JP5: nSTART button; JUMPER_1608
R95, R98, R100: 200R; RES_C_0603X30
R96: 10K; RES_C_1005x30_L
R97: DNP/10k; RES_C_1005x30_L
R99, R114, R116: 100R; RES_C_1005x30_L
R101, R104: 16.9k; RES_C_0603X30
R102: 20k; RES_C_1005x30_L
R103: 20k; RES_C_0603X30
R105: 4.02k; RES_C_1005x30_L
R106, R109: 0R; RES_C_1005x30_L
R107, R108: 1M 1%; RES_C_1005x30_L
R110, R111, R113: DNP/0R; RES_C_1005x30_L
R112: DNP/22R; RES_C_1005x30_L
R115: 10k; RES_C_1005x30_L
TP12: ${VALUE}; Test point
U8: SAMA7G54; TFBGA-343_14x14 - 2.5mm; Manufacturer Part Numbe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 SAMA7G54-V/4HB
Y1: 24MHz; CRYSTAL_ABM8G; Manufacturer Part Numbe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 ABM8G-24.000MHZ-18-D2Y-T
Y2: 32.768kHz; CRYSTAL_NX2012SA
Y3: 32.768KHz; DFN-4_2x1.6; Manufacturer Part Numbe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 DSC6003MA3B-032K768
Y4: DSC10xx DFN-4; DFN-4_2.5x2; Manufacturer Part Numbe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 DSC1001DI5-024.0000T

Connections:
3.3_VBAT: R111.1; also elsewhere on the board
/SAMA7G54_MPU/XIN: R106.2, R112.2, TP12.1 (1_1), U8.J2 (XIN)
/SAMA7G54_MPU/XIN32: C75.1, R107.1, R110.2, U8.Y13 (XIN32), Y2.2
/SAMA7G54_MPU/XOUT: R109.2, R113.2, U8.J1 (XOUT)
/SAMA7G54_MPU/XOUT32: C81.1, R107.2, U8.AA13 (XOUT32), Y2.1
GND: C38.1, C39.2, C40.2, C41.2, C42.2, C43.2, C44.2, C45.2, C46.2, C47.2, C48.2, C49.2, C50.2, C51.2, C52.2, C53.1, C54.2, C55.2, C56.2, C57.1, C58.2, C59.2, C60.2, C61.2, C62.2, C63.2, C64.2, C65.2, C66.2, C67.2, C68.2, C69.1, C70.1, C71.2, C72.2, C73.2, C74.2, C75.2, C76.2, C77.2, C78.2, C79.2, C80.1, C81.2, C82.2, C83.2, C84.1, C85.2, C86.1, C87.1, C88.2, C89.2, C90.1, C91.1, C92.1, JP3.2, JP4.2, JP5.2, R95.2, R98.2, R100.2, R101.1, R102.1, R103.1, R104.1, R105.2, R113.1, U8.A1 (GNDUTMI), U8.A5 (GNDUTMI), U8.A8 (GNDUTMI), U8.A11 (GND), U8.A14 (GND), U8.A17 (GND), U8.A21 (GND), U8.AA9 (TST), U8.AA14 (GND), U8.AA17 (GND), U8.AA21 (GND), U8.D9 (GND), U8.D13 (GND), U8.E1 (GNDUTMI), U8.E7 (GND), U8.E15 (GND), U8.E21 (GND), U8.F5 (GNDANA), U8.F17 (GND), U8.G5 (GNDANA), U8.G7 (GNDUTMI), U8.G11 (GND), U8.G15 (GND), U8.G17 (GND), U8.H1 (GNDIN33), U8.H8 (GND), U8.H14 (GND), U8.H21 (GND), U8.J4 (GNDANAOUT), U8.J18 (GND), U8.K11 (GND), U8.L1 (GND), U8.L15 (GND), U8.L21 (GND), U8.N18 (GND), U8.P14 (GND), U8.P21 (GND), U8.R11 (GNDBAT), U8.R15 (GNDDPHY), U8.R17 (GND), U8.T17 (GND), U8.U15 (GNDDPHY), U8.U21 (GND), U8.V13 (GND), Y1.2 (GND), Y1.4 (GND), Y3.2 (GND), Y4.2 (GND); also elsewhere on the board
IF_INPUT_USB_N: U8.B4 (HHSB_DM); also elsewhere on the board
IF_INPUT_USB_P: U8.A4 (HHSB_DP); also elsewhere on the board
IF_OUTPUT_USB_N: U8.B3 (HHSA_DM); also elsewhere on the board
IF_OUTPUT_USB_P: U8.A3 (HHSA_DP); also elsewhere on the board
LPM: R99.1; also elsewhere on the board
unnamed: C90.2, JP3.1, R114.2
unnamed: C91.2, JP4.1, R115.1, R116.2
unnamed: R95.1, U8.C6 (HHSA_RTUNE)
unnamed: R98.1, U8.D8 (HHSB_RTUNE)
unnamed: R100.1, U8.B7 (HHSC_RTUNE)
unnamed: R97.2, U8.W15 (JTAGSEL)
unnamed: R99.2, U8.R10 (LPM)
unnamed: R105.1, U8.R19 (MIPI_REXT)
unnamed: R101.2, U8.P16 (QSPI0_CAL)
unnamed: R102.2, U8.K15 (SDMMC0_CAL)
unnamed: R103.2, U8.J10 (SDMMC1_CAL)
unnamed: R104.2, U8.D14 (SDMMC2_CAL)
unnamed: C76.1, R106.1, R108.1, Y1.1 (Osc1)
unnamed: C82.1, R108.2, R109.1, Y1.3 (Osc2)
unnamed: R110.1, Y3.3 (OUT)
unnamed: R112.1, Y4.3 (OUT)
OSC_STBY: Y4.1 (~STB); also elsewhere on the board
SHDN: U8.R9 (SHDN); also elsewhere on the board
SOM_USER_BUTTON_PA12: R116.1; also elsewhere on the board
USB_HOST_ONLY_N: U8.B6 (HHSC_DM); also elsewhere on the board
USB_HOST_ONLY_P: U8.A6 (HHSC_DP); also elsewhere on the board
VDDANA: C57.2, C78.1, C79.1, C80.2, C88.1, C89.1, U8.E5 (VDDANA), U8.E6 (VDDANA), U8.G6 (ADVREFP), U8.J6 (VDDANAOUT), U8.T15 (VDDDPHY), U8.T16 (VDDDPHY)
VDDBU: C44.1, C45.1, C46.1, C47.1, C48.1, C49.1, C50.1, C51.1, C52.1, C70.2, C71.1, C72.1, C73.1, C74.1, C77.1, C83.1, C84.2, C85.1, R97.1, R111.2, U8.B2 (VDDUTMI), U8.C5 (VDDUTMI), U8.C8 (VDDUTMI), U8.C11 (VDDSDMMC1), U8.C14 (VDDIOP1), U8.C17 (VDDIOP1), U8.E3 (VDDUTMI), U8.F7 (VDDUTMI), U8.F13 (VDDSDMMC2), U8.H3 (VDDIN33), U8.H19 (VDDQSPI1), U8.J16 (VDDSDMMC0), U8.N16 (VDDQSPI0), U8.P11 (VBAT), U8.T13 (VDDIOP0), U8.W14 (VDDIOP0); also elsewhere on the board
VDDCORE: C53.2, C54.1, C55.1, C56.1, C58.1, C59.1, C60.1, C61.1, C62.1, C63.1, C64.1, C65.1, C66.1, C67.1, C68.1, C69.2, U8.F6 (VDDCORE), U8.F9 (VDDCORE), U8.F15 (VDDCORE), U8.J9 (VDDCORE), U8.J13 (VDDCORE), U8.L3 (VDDCORE), U8.L19 (VDDCORE), U8.N13 (VDDCORE), U8.P19 (VDDCORE), U8.U16 (VDDCORE), U8.U17 (VDDCORE), U8.U19 (VDDCORE), U8.W17 (VDDCORE), U8.Y20 (VDDCORE); also elsewhere on the board
VDDCPU: C38.2, C39.1, C40.1, C41.1, C42.1, C43.1, U8.B20 (VDDCPU), U8.E16 (VDDCPU), U8.E17 (VDDCPU), U8.E19 (VDDCPU), U8.F16 (VDDCPU); also elsewhere on the board
VDD_3V3: C86.2, C87.2, R96.1, R115.2, Y3.1 (~STB), Y3.4 (VDD), Y4.4 (VDD); also elsewhere on the board
WKUP: U8.AA15 (WKUP0); also elsewhere on the board
nRST: R114.1, U8.J7 (NRST); also elsewhere on the board
nRST_OUT: R96.2, U8.H4 (NRST_OUT)
nSTART: C92.2, JP5.1; also elsewhere on the board

Notes on the sheet:
MPU configuration
host/device
host
32.768KHz clock
24MHz clock
BUTTON
[ver 1.1.0] Use SAMA7G54 instead

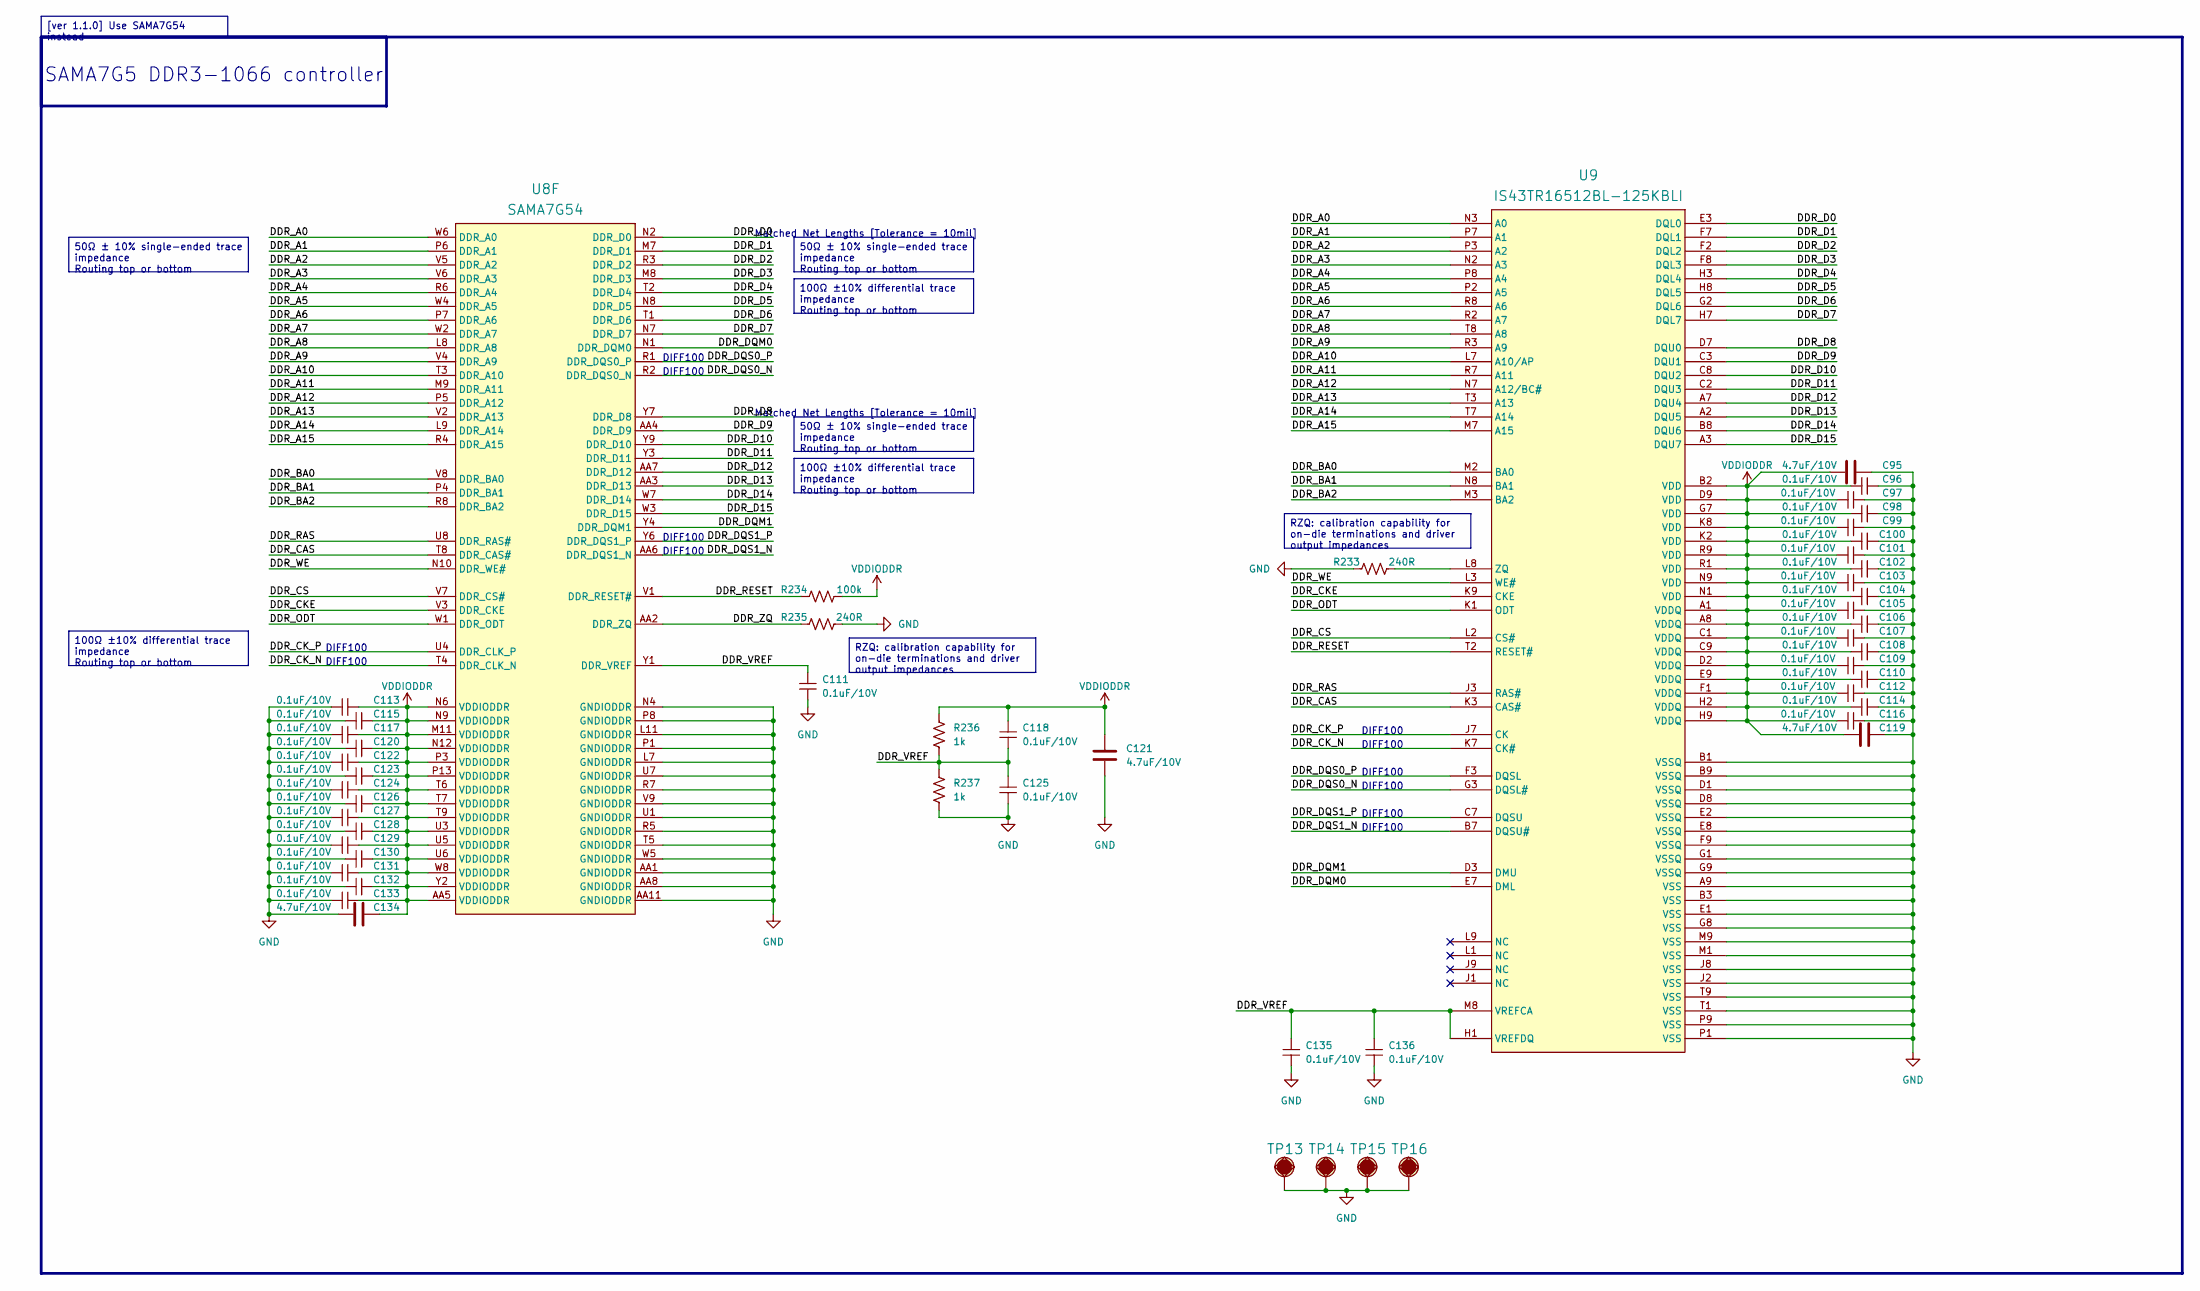
[picture p55: schematic SAMA7G54_DDR3L.kicad_sch, BEE]

Parts:
C95, C119, C121, C134: 4.7uF/10V; CAP_C_1005X50_L
C96, C97, C98, C99, C100, C101, C102, C103, C104, C105, C106, C107, C108, C109, C110, C111, C112, C113, C114, C115, C116, C117, C118, C120, C122, C123, C124, C125, C126, C127, C128, C129, C130, C131, C132, C133, C135, C136: 0.1uF/10V; CAP_C_0603x30
R233, R235: 240R; RES_C_0603X30
R234: 100k; RES_C_0603X30
R236, R237: 1k; RES_C_0603X30
TP13, TP14, TP15, TP16: ${VALUE}; Test point
U8: SAMA7G54; TFBGA-343_14x14 - 2.5mm; Manufacturer Part Numbe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 SAMA7G54-V/4HB
U9: IS43TR16512BL-125KBLI; TWBGA96_ISI; Manufacturer_Part_Number IS43TR16512BL-125KBLI

Connections:
/SAMA7G54_DDR3L/DDR_A0: U8.W6 (DDR_A0), U9.N3 (A0)
/SAMA7G54_DDR3L/DDR_A1: U8.P6 (DDR_A1), U9.P7 (A1)
/SAMA7G54_DDR3L/DDR_A2: U8.V5 (DDR_A2), U9.P3 (A2)
/SAMA7G54_DDR3L/DDR_A3: U8.V6 (DDR_A3), U9.N2 (A3)
/SAMA7G54_DDR3L/DDR_A4: U8.R6 (DDR_A4), U9.P8 (A4)
/SAMA7G54_DDR3L/DDR_A5: U8.W4 (DDR_A5), U9.P2 (A5)
/SAMA7G54_DDR3L/DDR_A6: U8.P7 (DDR_A6), U9.R8 (A6)
/SAMA7G54_DDR3L/DDR_A7: U8.W2 (DDR_A7), U9.R2 (A7)
/SAMA7G54_DDR3L/DDR_A8: U8.L8 (DDR_A8), U9.T8 (A8)
/SAMA7G54_DDR3L/DDR_A9: U8.V4 (DDR_A9), U9.R3 (A9)
/SAMA7G54_DDR3L/DDR_A10: U8.T3 (DDR_A10), U9.L7 (A10/AP)
/SAMA7G54_DDR3L/DDR_A11: U8.M9 (DDR_A11), U9.R7 (A11)
/SAMA7G54_DDR3L/DDR_A12: U8.P5 (DDR_A12), U9.N7 (A12/BC#)
/SAMA7G54_DDR3L/DDR_A13: U8.V2 (DDR_A13), U9.T3 (A13)
/SAMA7G54_DDR3L/DDR_A14: U8.L9 (DDR_A14), U9.T7 (A14)
/SAMA7G54_DDR3L/DDR_A15: U8.R4 (DDR_A15), U9.M7 (A15)
/SAMA7G54_DDR3L/DDR_BA0: U8.V8 (DDR_BA0), U9.M2 (BA0)
/SAMA7G54_DDR3L/DDR_BA1: U8.P4 (DDR_BA1), U9.N8 (BA1)
/SAMA7G54_DDR3L/DDR_BA2: U8.R8 (DDR_BA2), U9.M3 (BA2)
/SAMA7G54_DDR3L/DDR_CAS: U8.T8 (DDR_CAS#), U9.K3 (CAS#)
/SAMA7G54_DDR3L/DDR_CKE: U8.V3 (DDR_CKE), U9.K9 (CKE)
/SAMA7G54_DDR3L/DDR_CK_N: U8.T4 (DDR_CLK_N), U9.K7 (CK#)
/SAMA7G54_DDR3L/DDR_CK_P: U8.U4 (DDR_CLK_P), U9.J7 (CK)
/SAMA7G54_DDR3L/DDR_CS: U8.V7 (DDR_CS#), U9.L2 (CS#)
/SAMA7G54_DDR3L/DDR_D0: U8.N2 (DDR_D0), U9.E3 (DQL0)
/SAMA7G54_DDR3L/DDR_D1: U8.M7 (DDR_D1), U9.F7 (DQL1)
/SAMA7G54_DDR3L/DDR_D2: U8.R3 (DDR_D2), U9.F2 (DQL2)
/SAMA7G54_DDR3L/DDR_D3: U8.M8 (DDR_D3), U9.F8 (DQL3)
/SAMA7G54_DDR3L/DDR_D4: U8.T2 (DDR_D4), U9.H3 (DQL4)
/SAMA7G54_DDR3L/DDR_D5: U8.N8 (DDR_D5), U9.H8 (DQL5)
/SAMA7G54_DDR3L/DDR_D6: U8.T1 (DDR_D6), U9.G2 (DQL6)
/SAMA7G54_DDR3L/DDR_D7: U8.N7 (DDR_D7), U9.H7 (DQL7)
/SAMA7G54_DDR3L/DDR_D8: U8.Y7 (DDR_D8), U9.D7 (DQU0)
/SAMA7G54_DDR3L/DDR_D9: U8.AA4 (DDR_D9), U9.C3 (DQU1)
/SAMA7G54_DDR3L/DDR_D10: U8.Y9 (DDR_D10), U9.C8 (DQU2)
/SAMA7G54_DDR3L/DDR_D11: U8.Y3 (DDR_D11), U9.C2 (DQU3)
/SAMA7G54_DDR3L/DDR_D12: U8.AA7 (DDR_D12), U9.A7 (DQU4)
/SAMA7G54_DDR3L/DDR_D13: U8.AA3 (DDR_D13), U9.A2 (DQU5)
/SAMA7G54_DDR3L/DDR_D14: U8.W7 (DDR_D14), U9.B8 (DQU6)
/SAMA7G54_DDR3L/DDR_D15: U8.W3 (DDR_D15), U9.A3 (DQU7)
/SAMA7G54_DDR3L/DDR_DQM0: U8.N1 (DDR_DQM0), U9.E7 (DML)
/SAMA7G54_DDR3L/DDR_DQM1: U8.Y4 (DDR_DQM1), U9.D3 (DMU)
/SAMA7G54_DDR3L/DDR_DQS0_N: U8.R2 (DDR_DQS0_N), U9.G3 (DQSL#)
/SAMA7G54_DDR3L/DDR_DQS0_P: U8.R1 (DDR_DQS0_P), U9.F3 (DQSL)
/SAMA7G54_DDR3L/DDR_DQS1_N: U8.AA6 (DDR_DQS1_N), U9.B7 (DQSU#)
/SAMA7G54_DDR3L/DDR_DQS1_P: U8.Y6 (DDR_DQS1_P), U9.C7 (DQSU)
/SAMA7G54_DDR3L/DDR_ODT: U8.W1 (DDR_ODT), U9.K1 (ODT)
/SAMA7G54_DDR3L/DDR_RAS: U8.U8 (DDR_RAS#), U9.J3 (RAS#)
/SAMA7G54_DDR3L/DDR_RESET: R234.1, U8.V1 (DDR_RESET#), U9.T2 (RESET#)
/SAMA7G54_DDR3L/DDR_VREF: C111.2, C118.1, C125.2, C135.2, C136.2, R236.2, R237.1, U8.Y1 (DDR_VREF), U9.H1 (VREFDQ), U9.M8 (VREFCA)
/SAMA7G54_DDR3L/DDR_WE: U8.N10 (DDR_WE#), U9.L3 (WE#)
/SAMA7G54_DDR3L/DDR_ZQ: R235.1, U8.AA2 (DDR_ZQ)
GND: C95.2, C96.1, C97.1, C98.1, C99.1, C100.1, C101.1, C102.1, C103.1, C104.1, C105.1, C106.1, C107.1, C108.1, C109.1, C110.1, C111.1, C112.1, C113.2, C114.1, C115.2, C116.1, C117.2, C119.2, C120.2, C121.2, C122.2, C123.2, C124.2, C125.1, C126.2, C127.2, C128.2, C129.2, C130.2, C131.2, C132.2, C133.2, C134.1, C135.1, C136.1, R233.1, R235.2, R237.2, TP13.1 (1_1), TP14.1 (1_1), TP15.1 (1_1), TP16.1 (1_1), U8.AA1 (GNDIODDR), U8.AA8 (GNDIODDR), U8.AA11 (GNDIODDR), U8.L7 (GNDIODDR), U8.L11 (GNDIODDR), U8.N4 (GNDIODDR), U8.P1 (GNDIODDR), U8.P8 (GNDIODDR), U8.R5 (GNDIODDR), U8.R7 (GNDIODDR), U8.T5 (GNDIODDR), U8.U1 (GNDIODDR), U8.U7 (GNDIODDR), U8.V9 (GNDIODDR), U8.W5 (GNDIODDR), U9.A9 (VSS), U9.B1 (VSSQ), U9.B3 (VSS), U9.B9 (VSSQ), U9.D1 (VSSQ), U9.D8 (VSSQ), U9.E1 (VSS), U9.E2 (VSSQ), U9.E8 (VSSQ), U9.F9 (VSSQ), U9.G1 (VSSQ), U9.G8 (VSS), U9.G9 (VSSQ), U9.J2 (VSS), U9.J8 (VSS), U9.M1 (VSS), U9.M9 (VSS), U9.P1 (VSS), U9.P9 (VSS), U9.T1 (VSS), U9.T9 (VSS); also elsewhere on the board
unnamed: R233.2, U9.L8 (ZQ)
VDDIODDR: C95.1, C96.2, C97.2, C98.2, C99.2, C100.2, C101.2, C102.2, C103.2, C104.2, C105.2, C106.2, C107.2, C108.2, C109.2, C110.2, C112.2, C113.1, C114.2, C115.1, C116.2, C117.1, C118.2, C119.1, C120.1, C121.1, C122.1, C123.1, C124.1, C126.1, C127.1, C128.1, C129.1, C130.1, C131.1, C132.1, C133.1, C134.2, R234.2, R236.1, U8.AA5 (VDDIODDR), U8.M11 (VDDIODDR), U8.N6 (VDDIODDR), U8.N9 (VDDIODDR), U8.N12 (VDDIODDR), U8.P3 (VDDIODDR), U8.P13 (VDDIODDR), U8.T6 (VDDIODDR), U8.T7 (VDDIODDR), U8.T9 (VDDIODDR), U8.U3 (VDDIODDR), U8.U5 (VDDIODDR), U8.U6 (VDDIODDR), U8.W8 (VDDIODDR), U8.Y2 (VDDIODDR), U9.A1 (VDDQ), U9.A8 (VDDQ), U9.B2 (VDD), U9.C1 (VDDQ), U9.C9 (VDDQ), U9.D2 (VDDQ), U9.D9 (VDD), U9.E9 (VDDQ), U9.F1 (VDDQ), U9.G7 (VDD), U9.H2 (VDDQ), U9.H9 (VDDQ), U9.K2 (VDD), U9.K8 (VDD), U9.N1 (VDD), U9.N9 (VDD), U9.R1 (VDD), U9.R9 (VDD); also elsewhere on the board

Notes on the sheet:
DIFF100
SAMA7G5 DDR3-1066 controller
Matched Net Lengths [Tolerance = 10mil]
50Ω ± 10% single-ended trace impedance Routing top or bottom
RZQ: calibration capability for on-die terminations and driver output impedances
[ver 1.1.0] Use SAMA7G54 instead
100Ω ±10% differential trace impedance Routing top or bottom

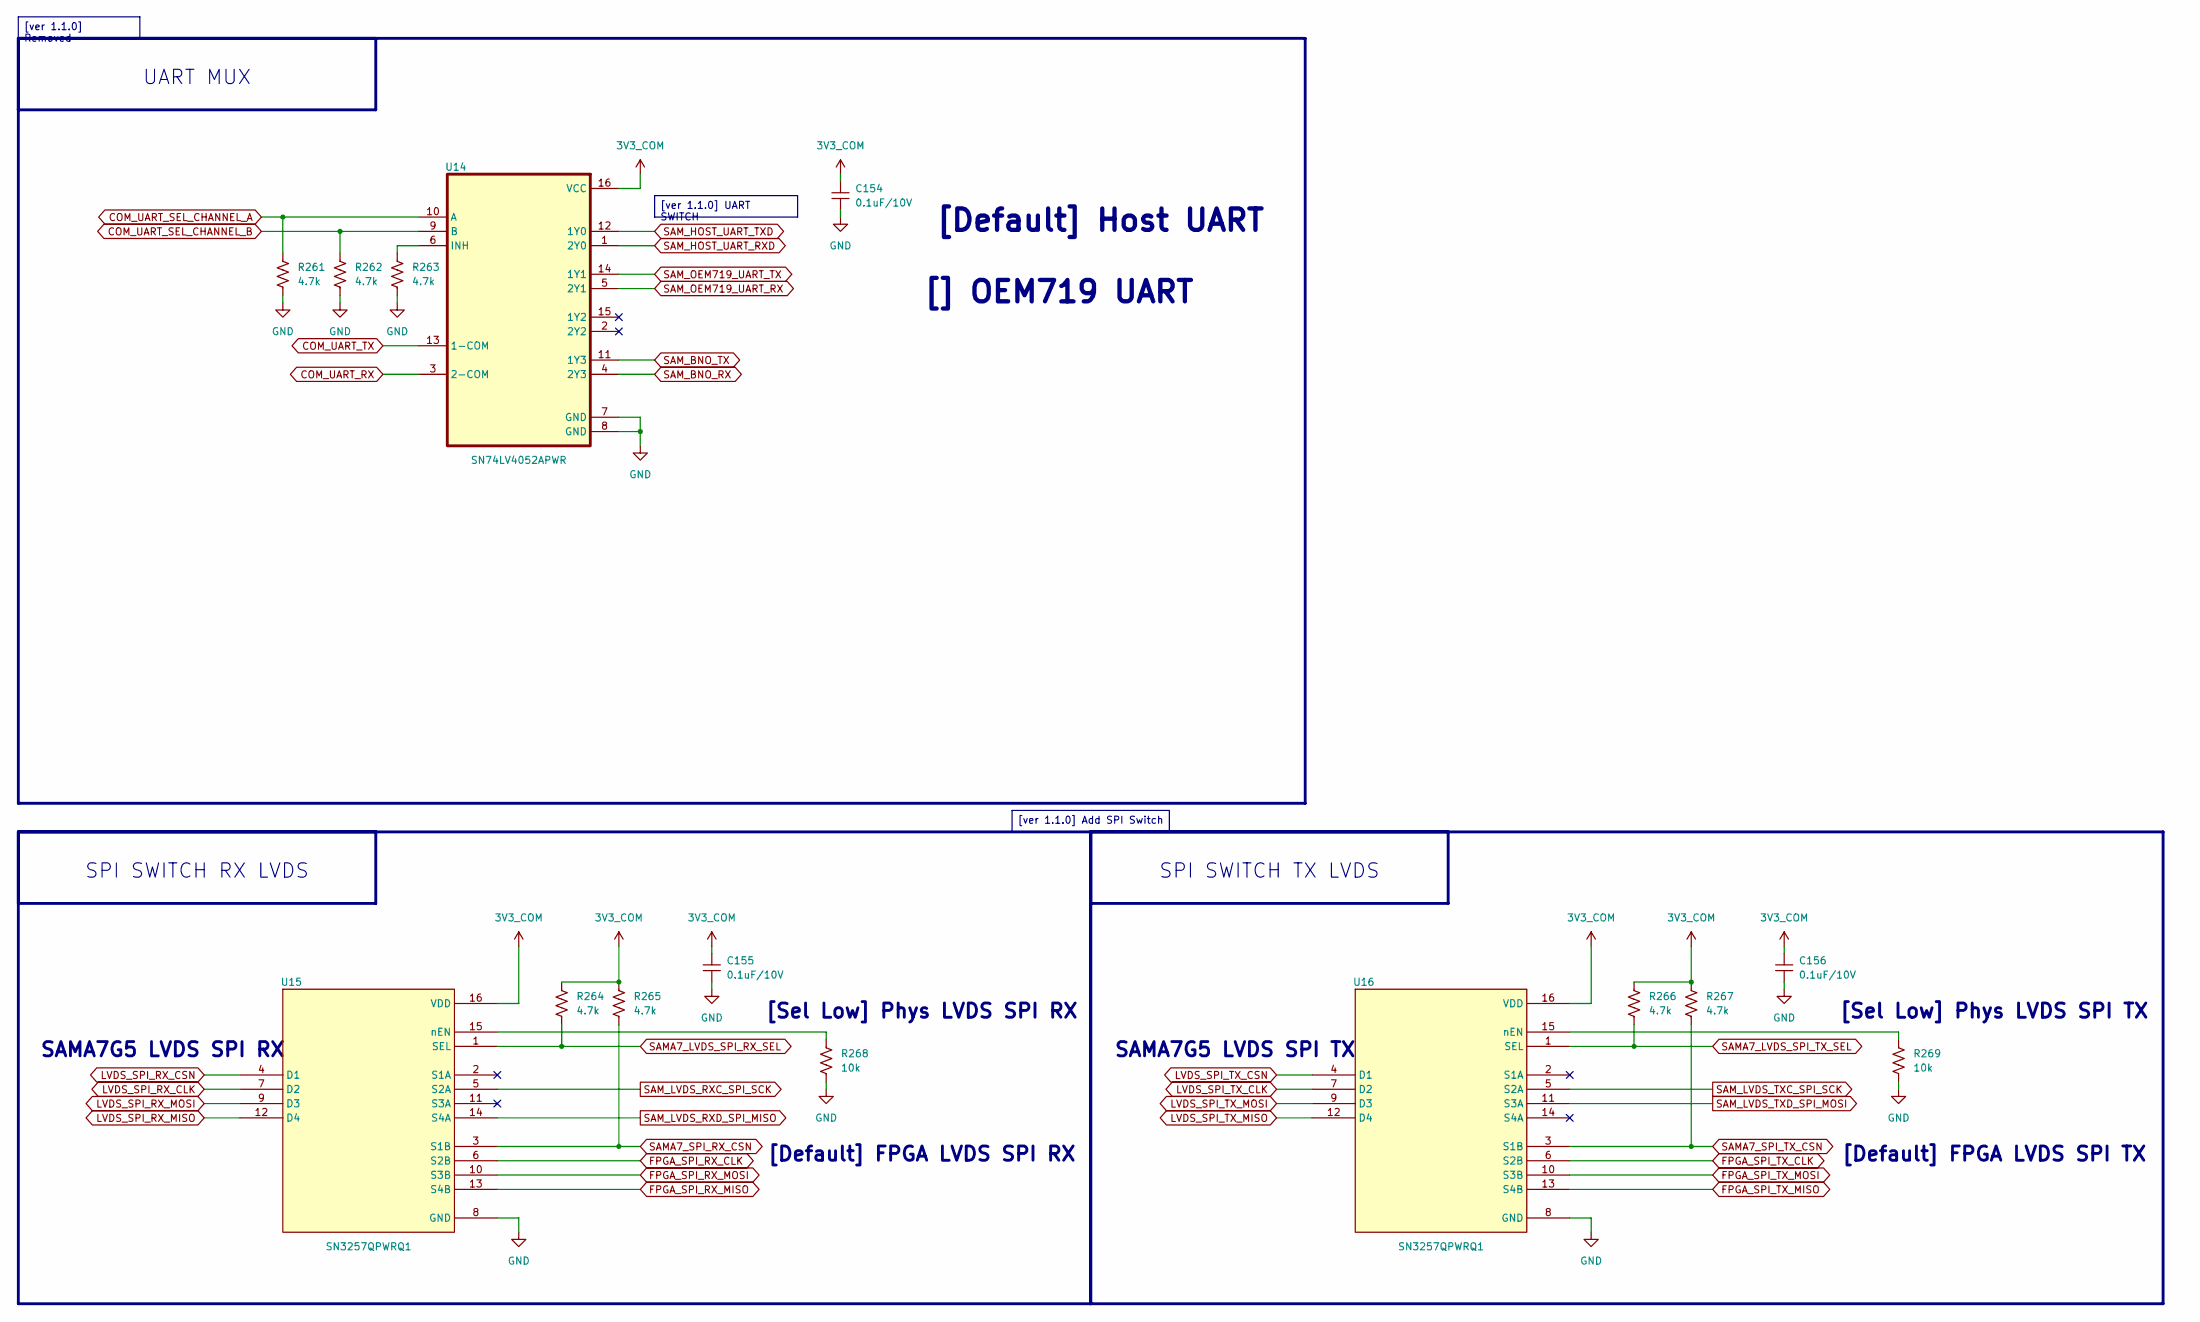
[picture p56: schematic COMM.kicad_sch, BEE]

Parts:
C154, C155, C156: 0.1uF/10V; CAP_C_1005X50_L
R261, R262, R263, R264, R265, R266, R267: 4.7k; RES_C_1005x30_L
R268, R269: 10k; RES_C_1005x30_L
U14: SN74LV4052APWR; SOP65P640X120-16N
U15, U16: SN3257QPWRQ1; SOIC_PRQ1_TEX; Manufacturer_Part_Number SN3257QPWRQ1

Connections:
3V3_COM: C154.2, C155.2, C156.2, R264.1, R265.1, R266.1, R267.1, U14.16 (VCC), U15.16 (VDD), U16.16 (VDD); also elsewhere on the board
COM_UART_RX: U14.3 (2-COM); also elsewhere on the board
COM_UART_SEL_CHANNEL_A: R261.1, U14.10 (A); also elsewhere on the board
COM_UART_SEL_CHANNEL_B: R262.1, U14.9 (B); also elsewhere on the board
COM_UART_TX: U14.13 (1-COM); also elsewhere on the board
FPGA_SPI_RX_CLK: U15.6 (S2B); also elsewhere on the board
FPGA_SPI_RX_MISO: U15.13 (S4B); also elsewhere on the board
FPGA_SPI_RX_MOSI: U15.10 (S3B); also elsewhere on the board
FPGA_SPI_TX_CLK: U16.6 (S2B); also elsewhere on the board
FPGA_SPI_TX_MISO: U16.13 (S4B); also elsewhere on the board
FPGA_SPI_TX_MOSI: U16.10 (S3B); also elsewhere on the board
GND: C154.1, C155.1, C156.1, R261.2, R262.2, R263.2, R268.2, R269.2, U14.7 (GND), U14.8 (GND), U15.8 (GND), U16.8 (GND); also elsewhere on the board
LVDS_SPI_RX_CLK: U15.7 (D2); also elsewhere on the board
LVDS_SPI_RX_CSN: U15.4 (D1); also elsewhere on the board
LVDS_SPI_RX_MISO: U15.12 (D4); also elsewhere on the board
LVDS_SPI_RX_MOSI: U15.9 (D3); also elsewhere on the board
LVDS_SPI_TX_CLK: U16.7 (D2); also elsewhere on the board
LVDS_SPI_TX_CSN: U16.4 (D1); also elsewhere on the board
LVDS_SPI_TX_MISO: U16.12 (D4); also elsewhere on the board
LVDS_SPI_TX_MOSI: U16.9 (D3); also elsewhere on the board
unnamed: R263.1, U14.6 (INH)
unnamed: R268.1, U15.15 (nEN)
unnamed: R269.1, U16.15 (nEN)
SAMA7_LVDS_SPI_RX_SEL: R264.2, U15.1 (SEL); also elsewhere on the board
SAMA7_LVDS_SPI_TX_SEL: R266.2, U16.1 (SEL); also elsewhere on the board
SAMA7_SPI_RX_CSN: R265.2, U15.3 (S1B); also elsewhere on the board
SAMA7_SPI_TX_CSN: R267.2, U16.3 (S1B); also elsewhere on the board
SAM_BNO_RX: U14.4 (2Y3); also elsewhere on the board
SAM_BNO_TX: U14.11 (1Y3); also elsewhere on the board
SAM_HOST_UART_RXD: U14.1 (2Y0); also elsewhere on the board
SAM_HOST_UART_TXD: U14.12 (1Y0); also elsewhere on the board
SAM_LVDS_RXC_SPI_SCK: U15.5 (S2A); also elsewhere on the board
SAM_LVDS_RXD_SPI_MISO: U15.14 (S4A); also elsewhere on the board
SAM_LVDS_TXC_SPI_SCK: U16.5 (S2A); also elsewhere on the board
SAM_LVDS_TXD_SPI_MOSI: U16.11 (S3A); also elsewhere on the board
SAM_OEM719_UART_RX: U14.5 (2Y1); also elsewhere on the board
SAM_OEM719_UART_TX: U14.14 (1Y1); also elsewhere on the board

Notes on the sheet:
[] OEM719 UART
SAMA7G5 LVDS SPI RX
[Sel Low] Phys LVDS SPI TX
SAMA7G5 LVDS SPI TX
[Default] FPGA LVDS SPI RX
SPI SWITCH RX LVDS
SPI SWITCH TX LVDS
[Sel Low] Phys LVDS SPI RX
[Default] FPGA LVDS SPI TX
UART MUX
[Default] Host UART
[ver 1.1.0] Add SPI Switch
[ver 1.1.0] Removed
[ver 1.1.0] UART SWITCH
