taitannguyen17022005-dev/BEE-1012-PAY-IF-V110/01_DESIGN/BEE-1012_PAY-IF_V110/_restore_backup_2026-08-10T14-50-42-868/BEE-1012_PAY-IF_V110.kicad_pcb

## KiCad design 01_DESIGN/BEE-1012_PAY-IF_V110/_restore_backup_2026-08-10T14-50-42-868/BEE-1012_PAY-IF_V110.kicad_pcb (continued)

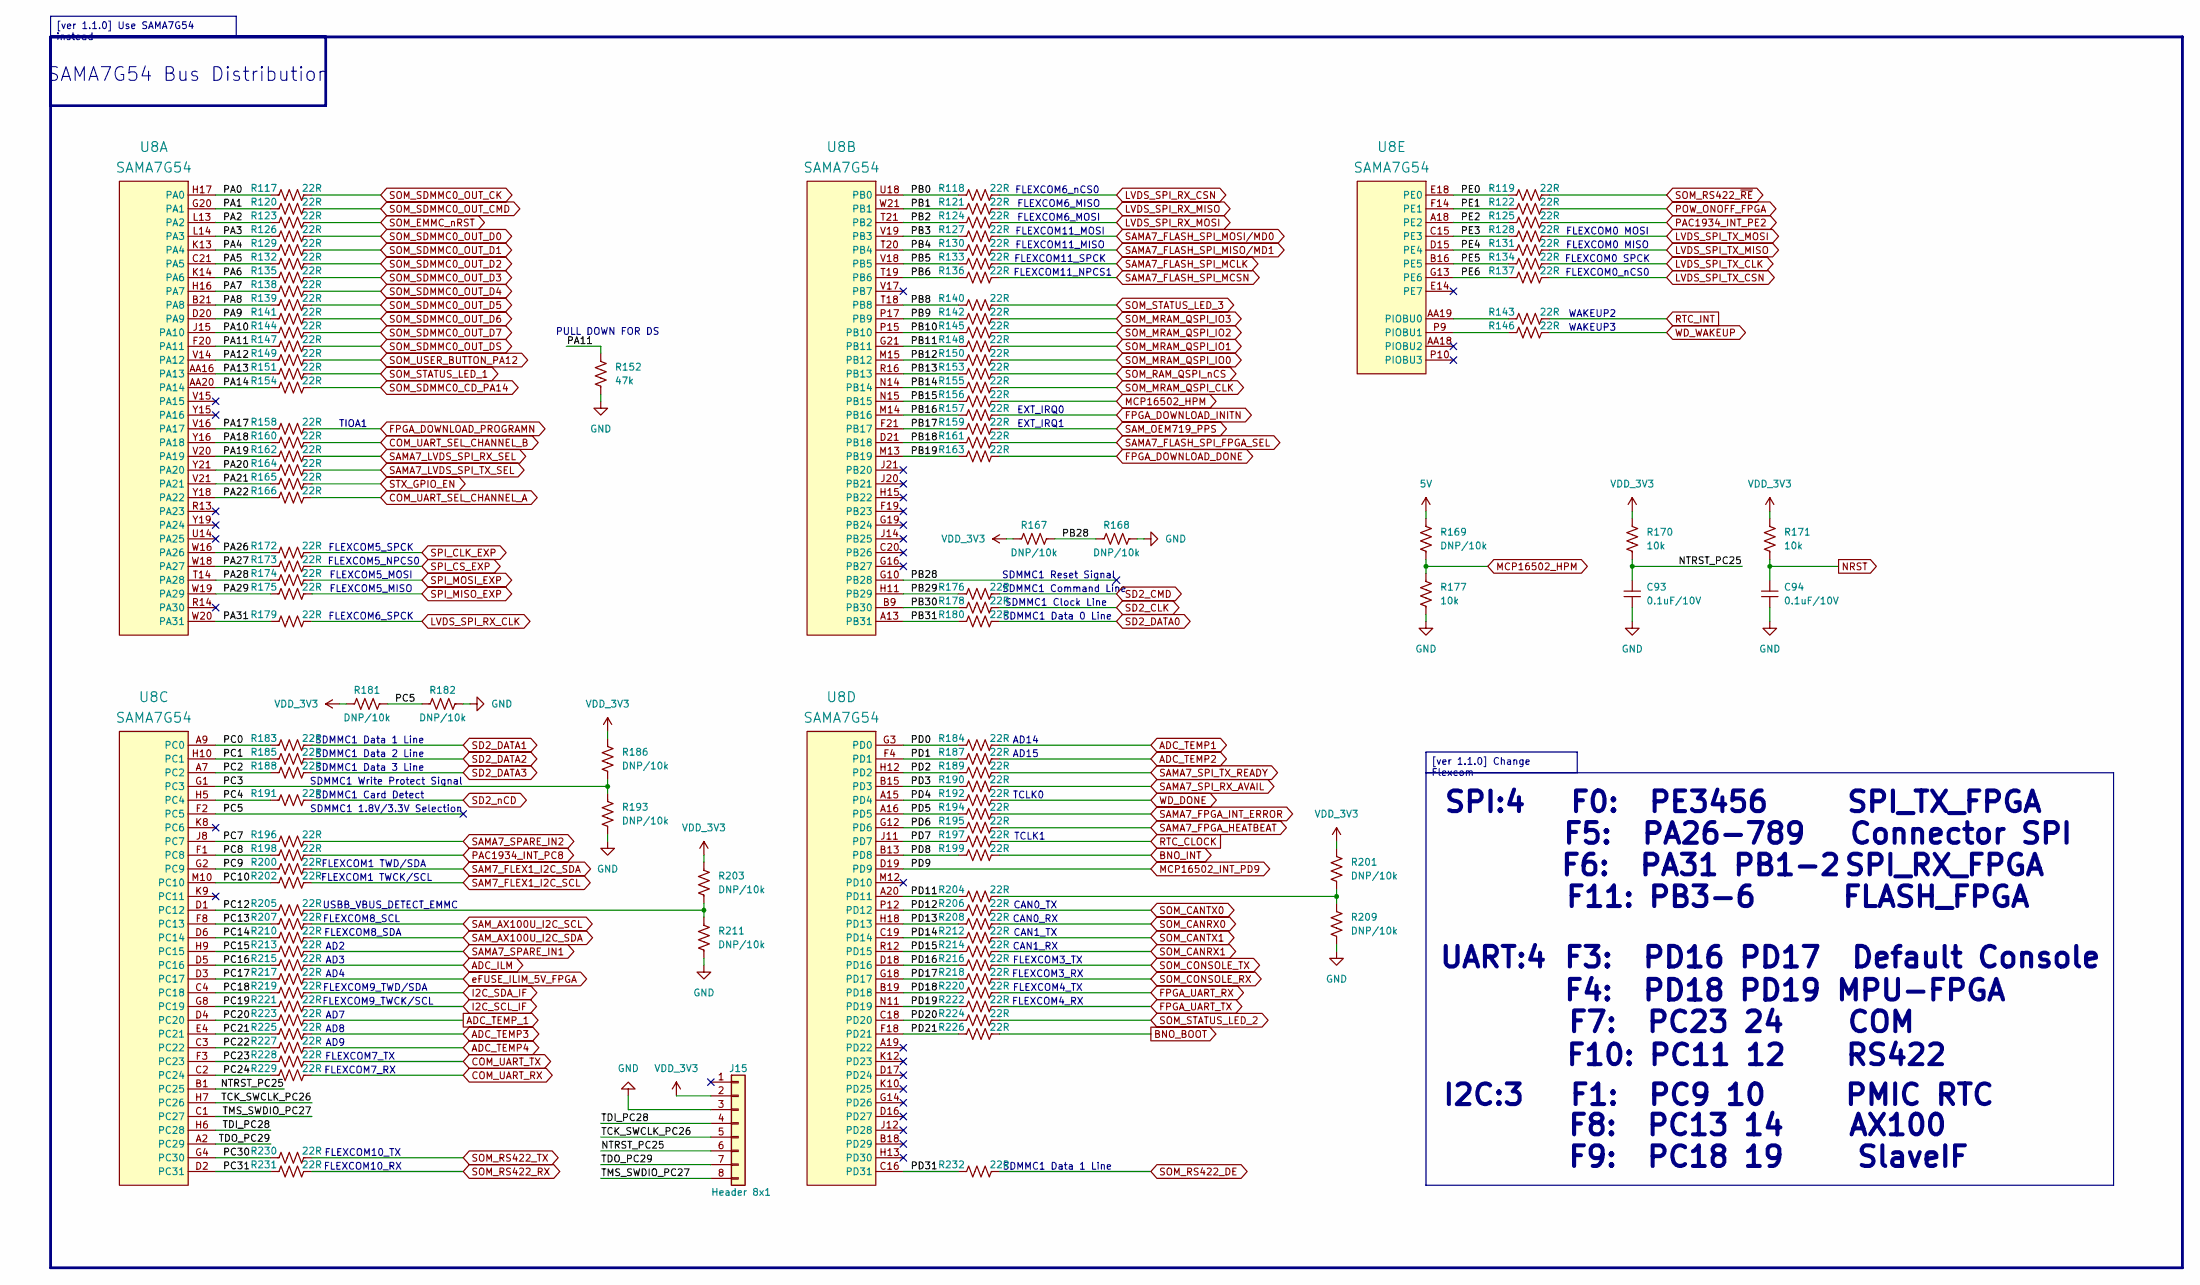
[picture p57: schematic SAMA7G54_PIO.kicad_sch, BEE]

Parts:
C93, C94: 0.1uF/10V; CAP_C_1005X50_L
J15: Header 8x1; PAD JTAG 1.27
R117, R118, R119, R120, R121, R122, R123, R124, R125, R126, R127, R128, R129, R130, R131, R132, R133, R134, R135, R136, R137, R138, R139, R140, R141, R142, R143, R144, R145, R146, R147, R148, R149, R150, R151, R153, R154, R155, R156, R157, R158, R159, R160, R161, R162, R163, R164, R165, R166, R172, R173, R174, R175, R176, R178, R179, R180, R183, R184, R185, R187, R188, R189, R190, R191, R192, R194, R195, R196, R197, R198, R199, R200, R202, R204, R205, R206, R207, R208, R210, R212, R213, R214, R215, R216, R217, R218, R219, R220, R221, R222, R223, R224, R225, R226, R227, R228, R229, R230, R231, R232: 22R; RES_C_1005x30_L
R152: 47k; RES_C_1005x30_L
R167, R168, R169, R181, R182, R186, R193, R201, R203, R209, R211: DNP/10k; RES_C_1005x30_L
R170, R171, R177: 10k; RES_C_1005x30_L
U8: SAMA7G54; TFBGA-343_14x14 - 2.5mm; Manufacturer Part Numbe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 SAMA7G54-V/4HB

Connections:
5V: R169.1; also elsewhere on the board
/SAMA7G54_PIO/NTRST_PC25: C93.2, J15.6, R170.2, U8.B1 (PC25)
/SAMA7G54_PIO/PA0: R117.1, U8.H17 (PA0)
/SAMA7G54_PIO/PA1: R120.1, U8.G20 (PA1)
/SAMA7G54_PIO/PA2: R123.1, U8.L13 (PA2)
/SAMA7G54_PIO/PA3: R126.1, U8.L14 (PA3)
/SAMA7G54_PIO/PA4: R129.1, U8.K13 (PA4)
/SAMA7G54_PIO/PA5: R132.1, U8.C21 (PA5)
/SAMA7G54_PIO/PA6: R135.1, U8.K14 (PA6)
/SAMA7G54_PIO/PA7: R138.1, U8.H16 (PA7)
/SAMA7G54_PIO/PA8: R139.1, U8.B21 (PA8)
/SAMA7G54_PIO/PA9: R141.1, U8.D20 (PA9)
/SAMA7G54_PIO/PA10: R144.1, U8.J15 (PA10)
/SAMA7G54_PIO/PA11: R147.1, R152.1, U8.F20 (PA11)
/SAMA7G54_PIO/PA12: R149.1, U8.V14 (PA12)
/SAMA7G54_PIO/PA13: R151.1, U8.AA16 (PA13)
/SAMA7G54_PIO/PA14: R154.1, U8.AA20 (PA14)
/SAMA7G54_PIO/PA17: R158.1, U8.V16 (PA17)
/SAMA7G54_PIO/PA18: R160.1, U8.Y16 (PA18)
/SAMA7G54_PIO/PA19: R162.1, U8.V20 (PA19)
/SAMA7G54_PIO/PA20: R164.1, U8.Y21 (PA20)
/SAMA7G54_PIO/PA21: R165.1, U8.V21 (PA21)
/SAMA7G54_PIO/PA22: R166.1, U8.Y18 (PA22)
/SAMA7G54_PIO/PA26: R172.1, U8.W16 (PA26)
/SAMA7G54_PIO/PA27: R173.1, U8.W18 (PA27)
/SAMA7G54_PIO/PA28: R174.1, U8.T14 (PA28)
/SAMA7G54_PIO/PA29: R175.1, U8.W19 (PA29)
/SAMA7G54_PIO/PA31: R179.1, U8.W20 (PA31)
/SAMA7G54_PIO/PB0: R118.1, U8.U18 (PB0)
/SAMA7G54_PIO/PB1: R121.1, U8.W21 (PB1)
/SAMA7G54_PIO/PB2: R124.1, U8.T21 (PB2)
/SAMA7G54_PIO/PB3: R127.1, U8.V19 (PB3)
/SAMA7G54_PIO/PB4: R130.1, U8.T20 (PB4)
/SAMA7G54_PIO/PB5: R133.1, U8.V18 (PB5)
/SAMA7G54_PIO/PB6: R136.1, U8.T19 (PB6)
/SAMA7G54_PIO/PB8: R140.1, U8.T18 (PB8)
/SAMA7G54_PIO/PB9: R142.1, U8.P17 (PB9)
/SAMA7G54_PIO/PB10: R145.1, U8.P15 (PB10)
/SAMA7G54_PIO/PB11: R148.1, U8.G21 (PB11)
/SAMA7G54_PIO/PB12: R150.1, U8.M15 (PB12)
/SAMA7G54_PIO/PB13: R153.1, U8.R16 (PB13)
/SAMA7G54_PIO/PB14: R155.1, U8.N14 (PB14)
/SAMA7G54_PIO/PB15: R156.1, U8.N15 (PB15)
/SAMA7G54_PIO/PB16: R157.1, U8.M14 (PB16)
/SAMA7G54_PIO/PB17: R159.1, U8.F21 (PB17)
/SAMA7G54_PIO/PB18: R161.1, U8.D21 (PB18)
/SAMA7G54_PIO/PB19: R163.1, U8.M13 (PB19)
/SAMA7G54_PIO/PB28: R167.2, R168.1, U8.G10 (PB28)
/SAMA7G54_PIO/PB29: R176.1, U8.H11 (PB29)
/SAMA7G54_PIO/PB30: R178.1, U8.B9 (PB30)
/SAMA7G54_PIO/PB31: R180.1, U8.A13 (PB31)
/SAMA7G54_PIO/PC0: R183.1, U8.A9 (PC0)
/SAMA7G54_PIO/PC1: R185.1, U8.H10 (PC1)
/SAMA7G54_PIO/PC2: R188.1, U8.A7 (PC2)
/SAMA7G54_PIO/PC3: R186.2, R193.1, U8.G1 (PC3)
/SAMA7G54_PIO/PC4: R191.1, U8.H5 (PC4)
/SAMA7G54_PIO/PC5: R181.2, R182.1, U8.F2 (PC5)
/SAMA7G54_PIO/PC7: R196.1, U8.J8 (PC7)
/SAMA7G54_PIO/PC8: R198.1, U8.F1 (PC8)
/SAMA7G54_PIO/PC9: R200.1, U8.G2 (PC9)
/SAMA7G54_PIO/PC10: R202.1, U8.M10 (PC10)
/SAMA7G54_PIO/PC12: R205.1, U8.D1 (PC12)
/SAMA7G54_PIO/PC13: R207.1, U8.F8 (PC13)
/SAMA7G54_PIO/PC14: R210.1, U8.D6 (PC14)
/SAMA7G54_PIO/PC15: R213.1, U8.H9 (PC15)
/SAMA7G54_PIO/PC16: R215.1, U8.D5 (PC16)
/SAMA7G54_PIO/PC17: R217.1, U8.D3 (PC17)
/SAMA7G54_PIO/PC18: R219.1, U8.C4 (PC18)
/SAMA7G54_PIO/PC19: R221.1, U8.G8 (PC19)
/SAMA7G54_PIO/PC20: R223.1, U8.D4 (PC20)
/SAMA7G54_PIO/PC21: R225.1, U8.E4 (PC21)
/SAMA7G54_PIO/PC22: R227.1, U8.C3 (PC22)
/SAMA7G54_PIO/PC23: R228.1, U8.F3 (PC23)
/SAMA7G54_PIO/PC24: R229.1, U8.C2 (PC24)
/SAMA7G54_PIO/PC30: R230.1, U8.G4 (PC30)
/SAMA7G54_PIO/PC31: R231.1, U8.D2 (PC31)
/SAMA7G54_PIO/PD0: R184.1, U8.G3 (PD0)
/SAMA7G54_PIO/PD1: R187.1, U8.F4 (PD1)
/SAMA7G54_PIO/PD2: R189.1, U8.H12 (PD2)
/SAMA7G54_PIO/PD3: R190.1, U8.B15 (PD3)
/SAMA7G54_PIO/PD4: R192.1, U8.A15 (PD4)
/SAMA7G54_PIO/PD5: R194.1, U8.A16 (PD5)
/SAMA7G54_PIO/PD6: R195.1, U8.G12 (PD6)
/SAMA7G54_PIO/PD7: R197.1, U8.J11 (PD7)
/SAMA7G54_PIO/PD8: R199.1, U8.B13 (PD8)
/SAMA7G54_PIO/PD11: R204.1, U8.A20 (PD11)
/SAMA7G54_PIO/PD12: R206.1, U8.P12 (PD12)
/SAMA7G54_PIO/PD13: R208.1, U8.H18 (PD13)
/SAMA7G54_PIO/PD14: R212.1, U8.C19 (PD14)
/SAMA7G54_PIO/PD15: R214.1, U8.R12 (PD15)
/SAMA7G54_PIO/PD16: R216.1, U8.D18 (PD16)
/SAMA7G54_PIO/PD17: R218.1, U8.G18 (PD17)
/SAMA7G54_PIO/PD18: R220.1, U8.B19 (PD18)
/SAMA7G54_PIO/PD19: R222.1, U8.N11 (PD19)
/SAMA7G54_PIO/PD20: R224.1, U8.C18 (PD20)
/SAMA7G54_PIO/PD21: R226.1, U8.F18 (PD21)
/SAMA7G54_PIO/PD31: R232.1, U8.C16 (PD31)
/SAMA7G54_PIO/PE0: R119.1, U8.E18 (PE0)
/SAMA7G54_PIO/PE1: R122.1, U8.F14 (PE1)
/SAMA7G54_PIO/PE2: R125.1, U8.A18 (PE2)
/SAMA7G54_PIO/PE3: R128.1, U8.C15 (PE3)
/SAMA7G54_PIO/PE4: R131.1, U8.D15 (PE4)
/SAMA7G54_PIO/PE5: R134.1, U8.B16 (PE5)
/SAMA7G54_PIO/PE6: R137.1, U8.G13 (PE6)
/SAMA7G54_PIO/TCK_SWCLK_PC26: J15.5, U8.H7 (PC26)
/SAMA7G54_PIO/TDI_PC28: J15.4, U8.H6 (PC28)
/SAMA7G54_PIO/TDO_PC29: J15.7, U8.A2 (PC29)
/SAMA7G54_PIO/TMS_SWDIO_PC27: J15.8, U8.C1 (PC27)
ADC_ILM: R215.2; also elsewhere on the board
ADC_TEMP1: R184.2; also elsewhere on the board
ADC_TEMP2: R187.2; also elsewhere on the board
ADC_TEMP3: R225.2; also elsewhere on the board
ADC_TEMP4: R227.2; also elsewhere on the board
ADC_TEMP_1: R223.2; also elsewhere on the board
BNO_BOOT: R226.2; also elsewhere on the board
BNO_INT: R199.2; also elsewhere on the board
COM_UART_RX: R229.2; also elsewhere on the board
COM_UART_SEL_CHANNEL_A: R166.2; also elsewhere on the board
COM_UART_SEL_CHANNEL_B: R160.2; also elsewhere on the board
COM_UART_TX: R228.2; also elsewhere on the board
FPGA_DOWNLOAD_DONE: R163.2; also elsewhere on the board
FPGA_DOWNLOAD_INITN: R157.2; also elsewhere on the board
FPGA_DOWNLOAD_PROGRAMN: R158.2; also elsewhere on the board
FPGA_UART_RX: R220.2; also elsewhere on the board
FPGA_UART_TX: R222.2; also elsewhere on the board
GND: C93.1, C94.1, J15.3, R152.2, R168.2, R177.2, R182.2, R193.2, R209.2, R211.2; also elsewhere on the board
I2C_SCL_IF: R221.2; also elsewhere on the board
I2C_SDA_IF: R219.2; also elsewhere on the board
LVDS_SPI_RX_CLK: R179.2; also elsewhere on the board
LVDS_SPI_RX_CSN: R118.2; also elsewhere on the board
LVDS_SPI_RX_MISO: R121.2; also elsewhere on the board
LVDS_SPI_RX_MOSI: R124.2; also elsewhere on the board
LVDS_SPI_TX_CLK: R134.2; also elsewhere on the board
LVDS_SPI_TX_CSN: R137.2; also elsewhere on the board
LVDS_SPI_TX_MISO: R131.2; also elsewhere on the board
LVDS_SPI_TX_MOSI: R128.2; also elsewhere on the board
MCP16502_HPM: R156.2, R169.2, R177.1; also elsewhere on the board
MCP16502_INT_PD9: U8.D19 (PD9); also elsewhere on the board
NRST: C94.2, R171.2; also elsewhere on the board
unnamed: R201.2, R204.2, R209.1
unnamed: R203.2, R205.2, R211.1
unnamed: R143.1, U8.AA19 (PIOBU0)
unnamed: R146.1, U8.P9 (PIOBU1)
PAC1934_INT_PC8: R198.2; also elsewhere on the board
PAC1934_INT_PE2: R125.2; also elsewhere on the board
POW_ONOFF_FPGA: R122.2; also elsewhere on the board
RTC_CLOCK: R197.2; also elsewhere on the board
RTC_INT: R143.2; also elsewhere on the board
SAM7_FLEX1_I2C_SCL: R202.2; also elsewhere on the board
SAM7_FLEX1_I2C_SDA: R200.2; also elsewhere on the board
SAMA7_FLASH_SPI_FPGA_SEL: R161.2; also elsewhere on the board
SAMA7_FLASH_SPI_MCLK: R133.2; also elsewhere on the board
SAMA7_FLASH_SPI_MCSN: R136.2; also elsewhere on the board
SAMA7_FLASH_SPI_MISO/MD1: R130.2; also elsewhere on the board
SAMA7_FLASH_SPI_MOSI/MD0: R127.2; also elsewhere on the board
SAMA7_FPGA_HEATBEAT: R195.2; also elsewhere on the board
SAMA7_FPGA_INT_ERROR: R194.2; also elsewhere on the board
SAMA7_LVDS_SPI_RX_SEL: R162.2; also elsewhere on the board
SAMA7_LVDS_SPI_TX_SEL: R164.2; also elsewhere on the board
SAMA7_SPARE_IN1: R213.2; also elsewhere on the board
SAMA7_SPARE_IN2: R196.2; also elsewhere on the board
SAMA7_SPI_RX_AVAIL: R190.2; also elsewhere on the board
SAMA7_SPI_TX_READY: R189.2; also elsewhere on the board
SAM_AX100U_I2C_SCL: R207.2; also elsewhere on the board
SAM_AX100U_I2C_SDA: R210.2; also elsewhere on the board
SAM_OEM719_PPS: R159.2; also elsewhere on the board
SD2_CLK: R178.2; also elsewhere on the board
SD2_CMD: R176.2; also elsewhere on the board
SD2_DATA0: R180.2; also elsewhere on the board
SD2_DATA1: R183.2; also elsewhere on the board
SD2_DATA2: R185.2; also elsewhere on the board
SD2_DATA3: R188.2; also elsewhere on the board
SD2_nCD: R191.2; also elsewhere on the board
SOM_CANRX0: R208.2; also elsewhere on the board
SOM_CANRX1: R214.2; also elsewhere on the board
SOM_CANTX0: R206.2; also elsewhere on the board
SOM_CANTX1: R212.2; also elsewhere on the board
SOM_CONSOLE_RX: R218.2; also elsewhere on the board
SOM_CONSOLE_TX: R216.2; also elsewhere on the board
SOM_EMMC_nRST: R123.2; also elsewhere on the board
SOM_MRAM_QSPI_CLK: R155.2; also elsewhere on the board
SOM_MRAM_QSPI_IO0: R150.2; also elsewhere on the board
SOM_MRAM_QSPI_IO1: R148.2; also elsewhere on the board
SOM_MRAM_QSPI_IO2: R145.2; also elsewhere on the board
SOM_MRAM_QSPI_IO3: R142.2; also elsewhere on the board
SOM_RAM_QSPI_nCS: R153.2; also elsewhere on the board
SOM_RS422_DE: R232.2; also elsewhere on the board
SOM_RS422_RX: R231.2; also elsewhere on the board
SOM_RS422_TX: R230.2; also elsewhere on the board
SOM_RS422_~RE: R119.2; also elsewhere on the board
SOM_SDMMC0_CD_PA14: R154.2; also elsewhere on the board
SOM_SDMMC0_OUT_CK: R117.2; also elsewhere on the board
SOM_SDMMC0_OUT_CMD: R120.2; also elsewhere on the board
SOM_SDMMC0_OUT_D0: R126.2; also elsewhere on the board
SOM_SDMMC0_OUT_D1: R129.2; also elsewhere on the board
SOM_SDMMC0_OUT_D2: R132.2; also elsewhere on the board
SOM_SDMMC0_OUT_D3: R135.2; also elsewhere on the board
SOM_SDMMC0_OUT_D4: R138.2; also elsewhere on the board
SOM_SDMMC0_OUT_D5: R139.2; also elsewhere on the board
SOM_SDMMC0_OUT_D6: R141.2; also elsewhere on the board
SOM_SDMMC0_OUT_D7: R144.2; also elsewhere on the board
SOM_SDMMC0_OUT_DS: R147.2; also elsewhere on the board
SOM_STATUS_LED_1: R151.2; also elsewhere on the board
SOM_STATUS_LED_2: R224.2; also elsewhere on the board
SOM_STATUS_LED_3: R140.2; also elsewhere on the board
SOM_USER_BUTTON_PA12: R149.2; also elsewhere on the board
SPI_CLK_EXP: R172.2; also elsewhere on the board
SPI_CS_EXP: R173.2; also elsewhere on the board
SPI_MISO_EXP: R175.2; also elsewhere on the board
SPI_MOSI_EXP: R174.2; also elsewhere on the board
STX_GPIO_EN: R165.2; also elsewhere on the board
VDD_3V3: J15.2, R167.1, R170.1, R171.1, R181.1, R186.1, R201.1, R203.1; also elsewhere on the board
WD_DONE: R192.2; also elsewhere on the board
WD_WAKEUP: R146.2; also elsewhere on the board
eFUSE_ILIM_5V_FPGA: R217.2; also elsewhere on the board

Notes on the sheet:
FLEXCOM11_MOSI
SDMMC1 Data 1 Line
COM
UART:4
SAMA7G54 Bus Distribution
USBB_VBUS_DETECT_EMMC
CAN1_TX
TIOA1
WAKEUP2
F10: PC11 12
Default Console
FLEXCOM9_TWD/SDA
FLEXCOM7_RX
FLEXCOM1 TWD/SDA
SlaveIF
FLEXCOM6_MOSI
FLEXCOM5_NPCS0
F6: PA31 PB1-2
F5: PA26-789
WAKEUP3
FLASH_FPGA
FLEXCOM11_SPCK
F9: PC18 19
SDMMC1 Reset Signal
SPI_TX_FPGA
Connector SPI
FLEXCOM8_SDA
F4: PD18 PD19
AD8
FLEXCOM0_nCS0
FLEXCOM6_MISO
TCLK0
AD4
F1: PC9 10
FLEXCOM4_TX
FLEXCOM5_SPCK
SDMMC1 Command Line
SDMMC1 Data 2 Line
FLEXCOM10_TX
AD14
SDMMC1 Clock Line
TCLK1
FLEXCOM0 MOSI
EXT_IRQ1
F11: PB3-6
FLEXCOM0 SPCK
FLEXCOM11_NPCS1
SDMMC1 Write Protect Signal
FLEXCOM3_TX
PULL DOWN FOR DS
FLEXCOM5_MISO
FLEXCOM6_SPCK
SDMMC1 Card Detect
AD2
FLEXCOM8_SCL
FLEXCOM11_MISO
RS422
SDMMC1 Data 0 Line
SPI_RX_FPGA
F3: PD16 PD17
FLEXCOM0 MISO
FLEXCOM10_RX
F7: PC23 24
EXT_IRQ0
AD7
F8: PC13 14
CAN1_RX
FLEXCOM1 TWCK/SCL
AD9
I2C:3
SDMMC1 1.8V/3.3V Selection
CAN0_RX
SDMMC1 Data 3 Line
AX100
FLEXCOM6_nCS0
SPI:4
FLEXCOM9_TWCK/SCL
F0: PE3456
PMIC RTC
FLEXCOM4_RX
FLEXCOM5_MOSI
MPU-FPGA
CAN0_TX
AD15
AD3
FLEXCOM7_TX
FLEXCOM3_RX
[ver 1.1.0] Use SAMA7G54 instead
[ver 1.1.0] Change Flexcom

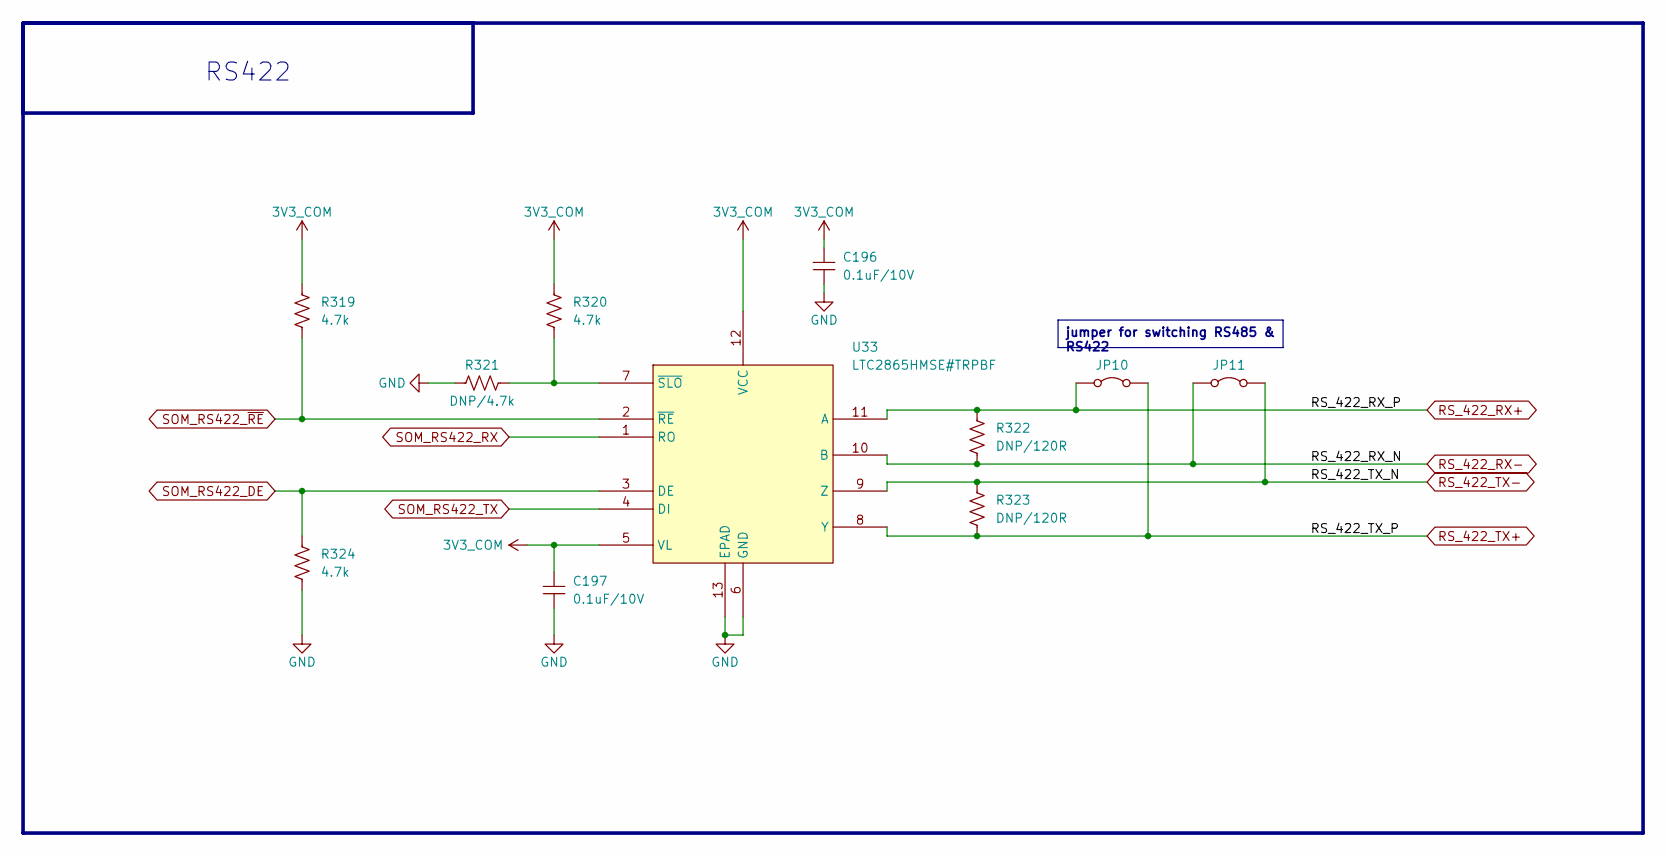
[picture p58: schematic RS422.kicad_sch, BEE]

Parts:
C196, C197: 0.1uF/10V; CAP_C_1005X50_L
JP10, JP11: Jumper_2_Bridged; JUMPER_1608
R319, R320, R324: 4.7k; RES_C_1005x30_L
R321: DNP/4.7k; RES_C_1005x30_L
R322, R323: DNP/120R; RES_C_1005x30_L
U33: LTC2865HMSE#TRPBF; MSOP-12_MSE_LIT; Manufacturer_Part_Number LTC2865HMSE#TRPBF

Connections:
3V3_COM: C196.2, C197.2, R319.1, R320.1, U33.5 (VL), U33.12 (VCC); also elsewhere on the board
GND: C196.1, C197.1, R321.1, R324.2, U33.6 (GND), U33.13 (EPAD); also elsewhere on the board
unnamed: R320.2, R321.2, U33.7 (~SLO)
RS_422_RX+: JP10.1 (A), R322.1, U33.11 (A); also elsewhere on the board
RS_422_RX-: JP11.1 (A), R322.2, U33.10 (B); also elsewhere on the board
RS_422_TX+: JP10.2 (B), R323.2, U33.8 (Y); also elsewhere on the board
RS_422_TX-: JP11.2 (B), R323.1, U33.9 (Z); also elsewhere on the board
SOM_RS422_DE: R324.1, U33.3 (DE); also elsewhere on the board
SOM_RS422_RX: U33.1 (RO); also elsewhere on the board
SOM_RS422_TX: U33.4 (DI); also elsewhere on the board
SOM_RS422_~RE: R319.2, U33.2 (~RE); also elsewhere on the board

Notes on the sheet:
RS422
jumper for switching RS485 & RS422

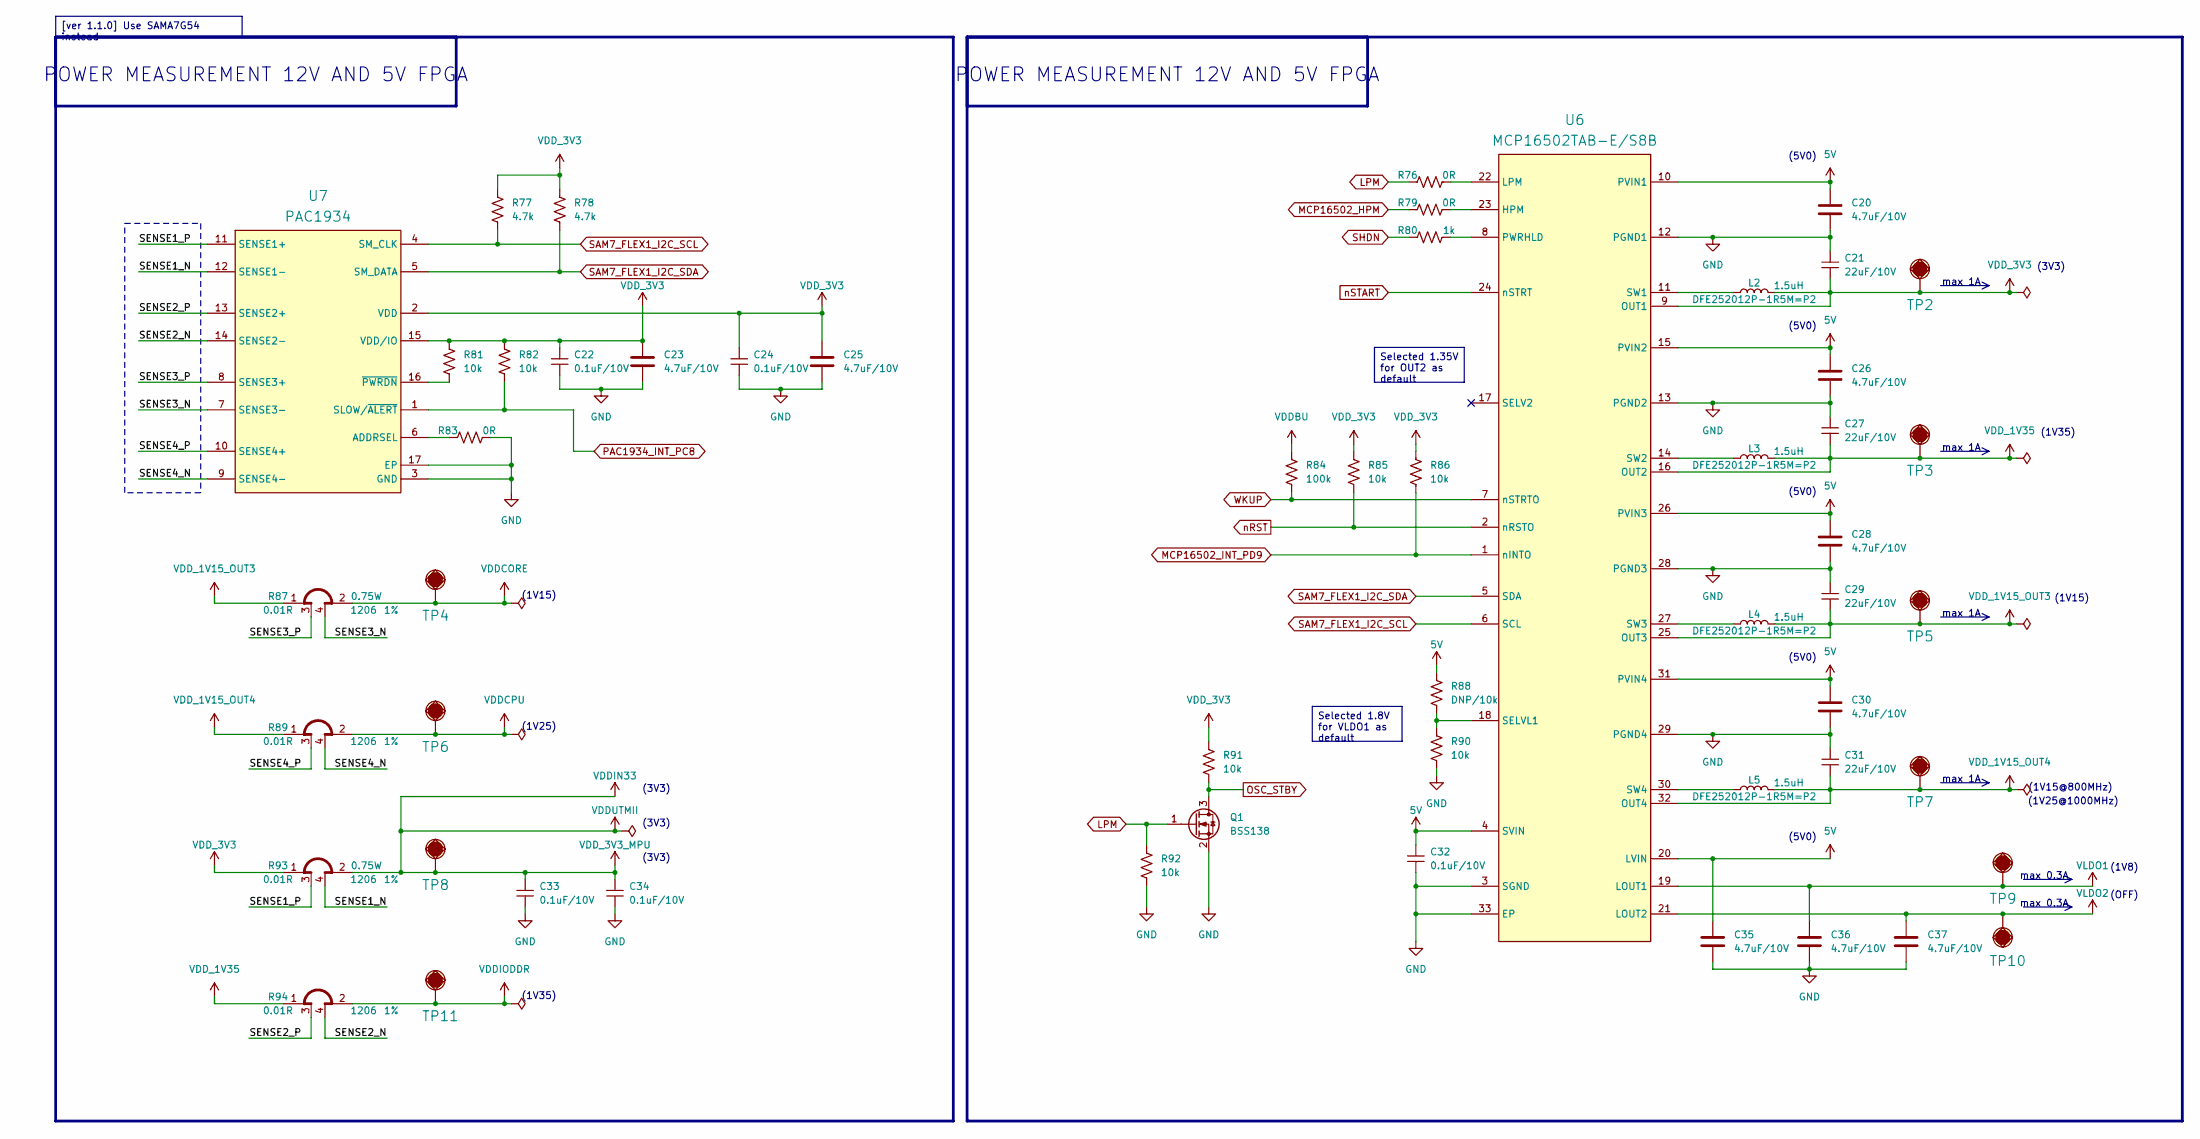
[picture p59: schematic SAMA7G54_PMIC.kicad_sch, BEE]

Parts:
C20, C23, C25, C26, C28, C30, C35, C36, C37: 4.7uF/10V; CAP_C_1005X50_L
C21, C27, C29, C31: 22uF/10V; CAP_C_1608X80
C22, C24, C32, C33, C34: 0.1uF/10V; CAP_C_1005X50_L
L2, L3, L4, L5: DFE252012P-1R5M=P2; IND_C_1008
Q1: BSS138; SOT-23-3
R76, R79, R83: 0R; RES_C_1005x30_L
R77, R78: 4.7k; RES_C_1005x30_L
R80: 1k; RES_C_1005x30_L
R81, R82, R85, R86, R90, R91, R92: 10k; RES_C_1005x30_L
R84: 100k; RES_C_1005x30_L
R87, R89, R93, R94: Shunt 4 Pin; RES_C_1206_SHUNT; Tolerance 1%; Manufacturer Part Numbe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 KRL1632E-M-R010-F-T5
R88: DNP/10k; RES_C_1005x30_L
TP2, TP3, TP4, TP5, TP6, TP7, TP8, TP9, TP10, TP11: ${VALUE}; Test point
U6: MCP16502 QFN-32; QFN-32_5X5_EP3.7X3.7; Manufacturer Part Numbe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 MCP16502TAB-E/S8B
U7: Microchip PAC1934 UQFN-16; UQFN-16_4X4_EP2.6X2.6; Manufacturer Part Numbe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 PAC1934T-I/JQ

Connections:
5V: C20.1, C26.1, C28.1, C30.1, C32.2, C35.1, R88.1, U6.4 (SVIN), U6.10 (PVIN1), U6.15 (PVIN2), U6.20 (LVIN), U6.26 (PVIN3), U6.31 (PVIN4); also elsewhere on the board
/SAMA7G54_PMIC/SENSE1_N: R93.4, U7.12 (SENSE1-)
/SAMA7G54_PMIC/SENSE1_P: R93.3, U7.11 (SENSE1+)
/SAMA7G54_PMIC/SENSE2_N: R94.4, U7.14 (SENSE2-)
/SAMA7G54_PMIC/SENSE2_P: R94.3, U7.13 (SENSE2+)
/SAMA7G54_PMIC/SENSE3_N: R87.4, U7.7 (SENSE3-)
/SAMA7G54_PMIC/SENSE3_P: R87.3, U7.8 (SENSE3+)
/SAMA7G54_PMIC/SENSE4_N: R89.4, U7.9 (SENSE4-)
/SAMA7G54_PMIC/SENSE4_P: R89.3, U7.10 (SENSE4+)
GND: C20.2, C21.2, C22.1, C23.2, C24.1, C25.2, C26.2, C27.2, C28.2, C29.2, C30.2, C31.2, C32.1, C33.1, C34.1, C35.2, C36.2, C37.2, Q1.2 (S), R83.2, R90.2, R92.2, U6.3 (SGND), U6.12 (PGND1), U6.13 (PGND2), U6.28 (PGND3), U6.29 (PGND4), U6.33 (EP), U7.3 (GND), U7.17 (EP); also elsewhere on the board
LPM: Q1.1 (G), R76.1, R92.1; also elsewhere on the board
MCP16502_HPM: R79.1; also elsewhere on the board
MCP16502_INT_PD9: R86.2, U6.1 (nINTO); also elsewhere on the board
unnamed: R79.2, U6.23 (HPM)
unnamed: R76.2, U6.22 (LPM)
unnamed: R80.2, U6.8 (PWRHLD)
unnamed: R88.2, R90.1, U6.18 (SELVL1)
unnamed: L2.1, U6.11 (SW1)
unnamed: L3.1, U6.14 (SW2)
unnamed: L4.1, U6.27 (SW3)
unnamed: L5.1, U6.30 (SW4)
unnamed: R83.1, U7.6 (ADDRSEL)
unnamed: R81.2, U7.16 (~PWRDN)
OSC_STBY: Q1.3 (D), R91.2; also elsewhere on the board
PAC1934_INT_PC8: R82.2, U7.1 (SLOW/~ALERT); also elsewhere on the board
SAM7_FLEX1_I2C_SCL: R77.2, U6.6 (SCL), U7.4 (SM_CLK); also elsewhere on the board
SAM7_FLEX1_I2C_SDA: R78.2, U6.5 (SDA), U7.5 (SM_DATA); also elsewhere on the board
SHDN: R80.1; also elsewhere on the board
VDDBU: C33.2, C34.2, R84.1, R93.2, TP8.1 (1_1); also elsewhere on the board
VDDCORE: R87.2, TP4.1 (1_1); also elsewhere on the board
VDDCPU: R89.2, TP6.1 (1_1); also elsewhere on the board
VDDIODDR: R94.2, TP11.1 (1_1); also elsewhere on the board
VDD_1V15_OUT3: C29.1, L4.2, R87.1, TP5.1 (1_1), U6.25 (OUT3)
VDD_1V15_OUT4: C31.1, L5.2, R89.1, TP7.1 (1_1), U6.32 (OUT4)
VDD_1V35: C27.1, L3.2, R94.1, TP3.1 (1_1), U6.16 (OUT2)
VDD_3V3: C21.1, C22.2, C23.1, C24.2, C25.1, L2.2, R77.1, R78.1, R81.1, R82.1, R85.1, R86.1, R91.1, R93.1, TP2.1 (1_1), U6.9 (OUT1), U7.2 (VDD), U7.15 (VDD/IO); also elsewhere on the board
VLDO1: C36.1, TP9.1 (1_1), U6.19 (LOUT1)
VLDO2: C37.1, TP10.1 (1_1), U6.21 (LOUT2)
WKUP: R84.2, U6.7 (nSTRTO); also elsewhere on the board
nRST: R85.2, U6.2 (nRSTO); also elsewhere on the board
nSTART: U6.24 (nSTRT); also elsewhere on the board

Notes on the sheet:
(1V35)
(5V0)
max 1A
(3V3)
(1V15@800MHz)
POWER MEASUREMENT 12V AND 5V FPGA
(1V25)
(1V8)
max 0.3A
(1V15)
(OFF)
(1V25@1000MHz)
[ver 1.1.0] Use SAMA7G54 instead
Selected 1.8V for VLDO1 as default
Selected 1.35V for OUT2 as default

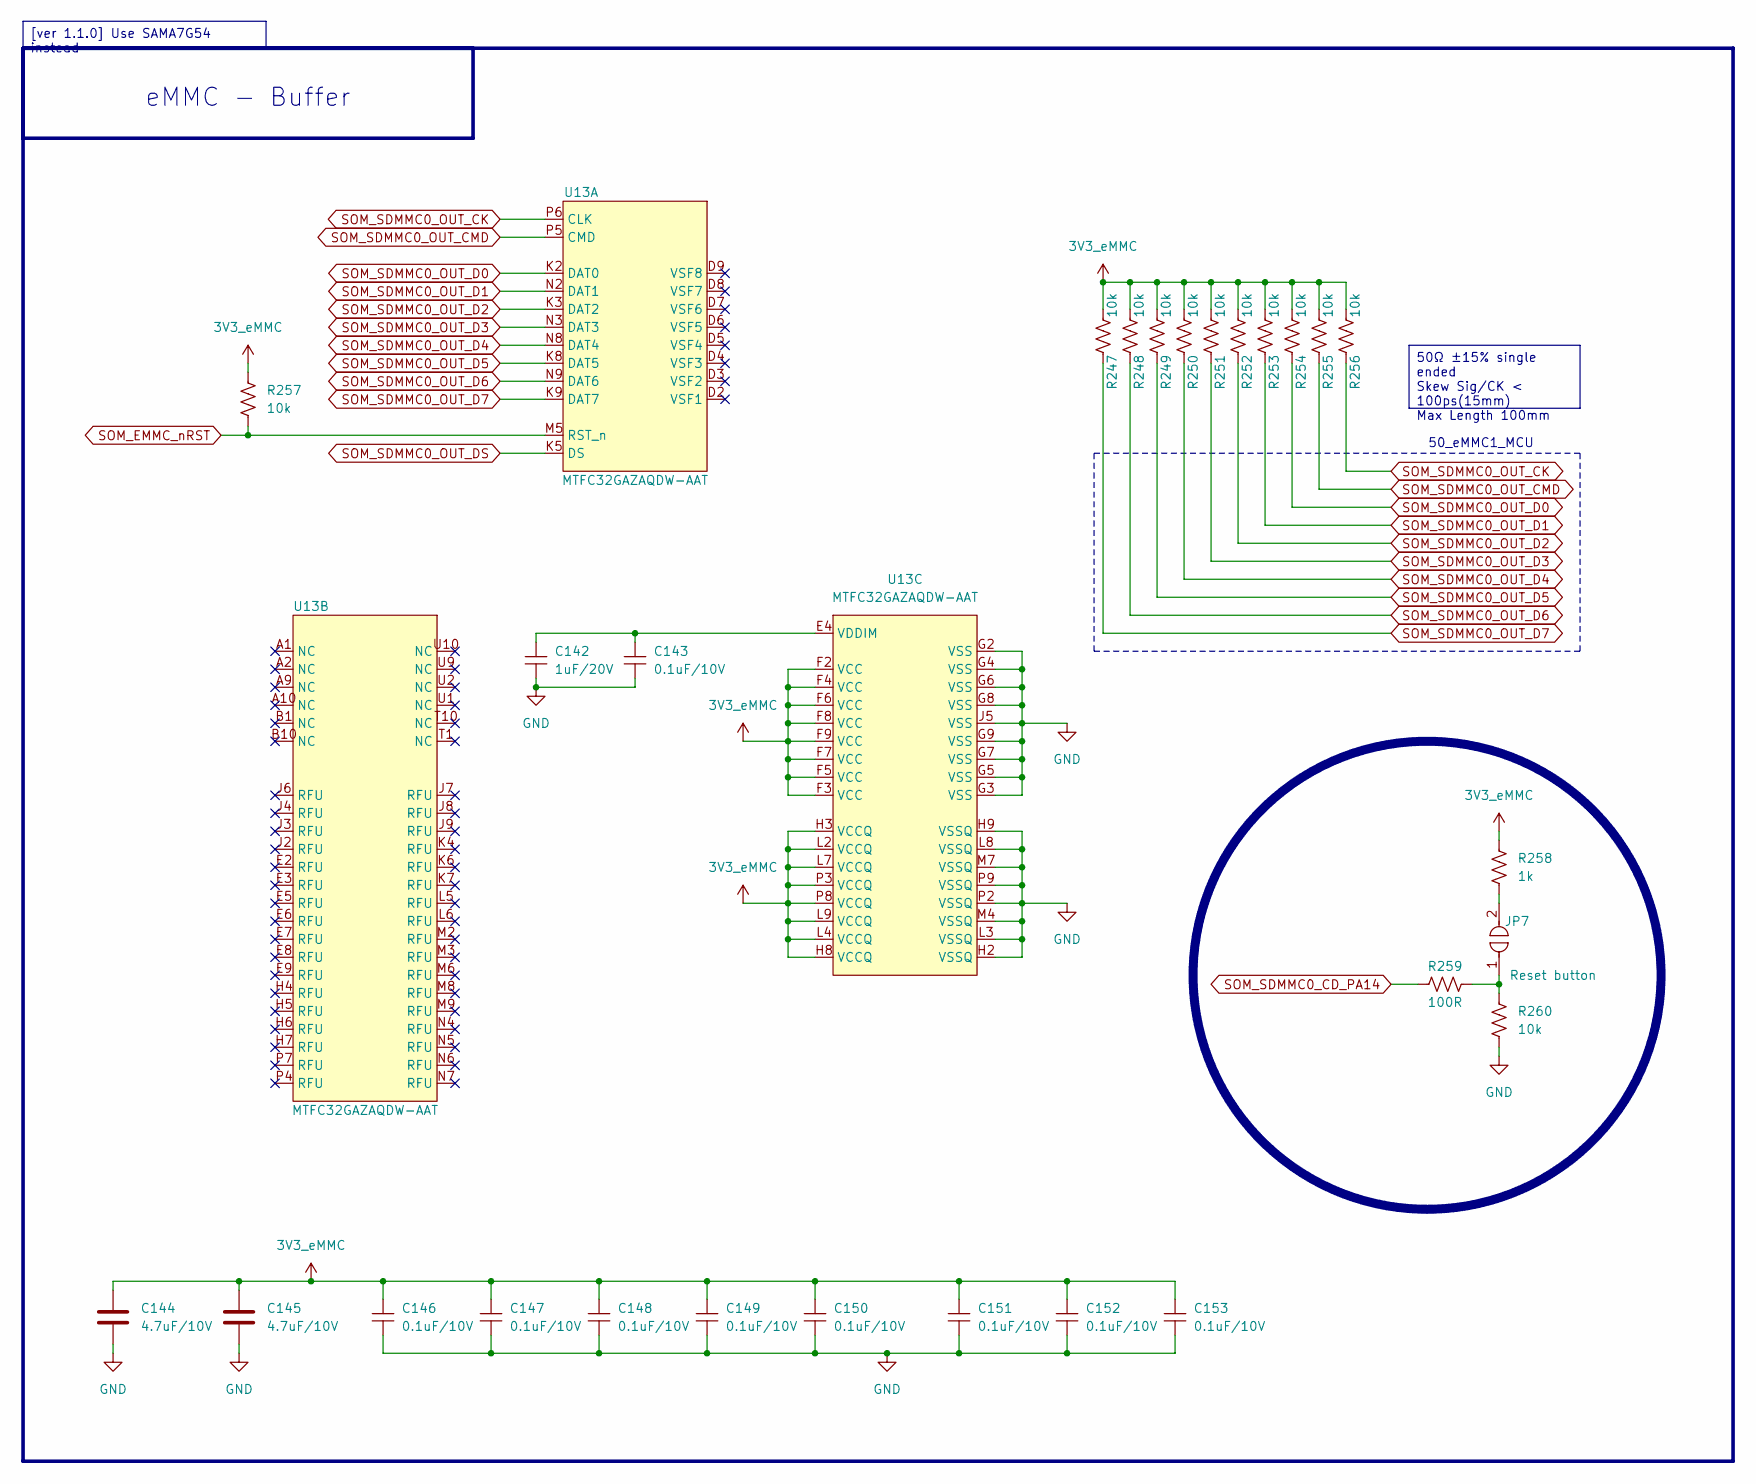
[picture p60: schematic eMMC.kicad_sch, BEE]

Parts:
C142: 1uF/20V; CAP_C_1005X50_L
C143, C146, C147, C148, C149, C150, C151, C152, C153: 0.1uF/10V; CAP_C_1005X50_L
C144, C145: 4.7uF/10V; CAP_C_1005X50_L
JP7: Reset button; JUMPER_1608
R247, R248, R249, R250, R251, R252, R253, R254, R255, R256, R257, R260: 10k; RES_C_1005x30_L
R258: 1k; RES_C_1005x30_L
R259: 100R; RES_C_1005x30_L
U13: MTFC32GAZAQDW-AAT; BGA_100_C_100P_10X17_1400X1800X150

Connections:
3V3_eMMC: C144.1, C145.1, C146.2, C147.2, C148.2, C149.2, C150.2, C151.2, C152.2, C153.2, R247.1, R248.1, R249.1, R250.1, R251.1, R252.1, R253.1, R254.1, R255.1, R256.1, R257.1, R258.1, U13.F2 (VCC), U13.F3 (VCC), U13.F4 (VCC), U13.F5 (VCC), U13.F6 (VCC), U13.F7 (VCC), U13.F8 (VCC), U13.F9 (VCC), U13.H3 (VCCQ), U13.H8 (VCCQ), U13.L2 (VCCQ), U13.L4 (VCCQ), U13.L7 (VCCQ), U13.L9 (VCCQ), U13.P3 (VCCQ), U13.P8 (VCCQ); also elsewhere on the board
GND: C142.1, C143.1, C144.2, C145.2, C146.1, C147.1, C148.1, C149.1, C150.1, C151.1, C152.1, C153.1, R260.2, U13.G2 (VSS), U13.G3 (VSS), U13.G4 (VSS), U13.G5 (VSS), U13.G6 (VSS), U13.G7 (VSS), U13.G8 (VSS), U13.G9 (VSS), U13.H2 (VSSQ), U13.H9 (VSSQ), U13.J5 (VSS), U13.L3 (VSSQ), U13.L8 (VSSQ), U13.M4 (VSSQ), U13.M7 (VSSQ), U13.P2 (VSSQ), U13.P9 (VSSQ); also elsewhere on the board
unnamed: JP7.1, R259.2, R260.1
unnamed: JP7.2, R258.2
unnamed: C142.2, C143.2, U13.E4 (VDDIM)
SOM_EMMC_nRST: R257.2, U13.M5 (RST_n); also elsewhere on the board
SOM_SDMMC0_CD_PA14: R259.1; also elsewhere on the board
SOM_SDMMC0_OUT_CK: R256.2, U13.P6 (CLK); also elsewhere on the board
SOM_SDMMC0_OUT_CMD: R255.2, U13.P5 (CMD); also elsewhere on the board
SOM_SDMMC0_OUT_D0: R254.2, U13.K2 (DAT0); also elsewhere on the board
SOM_SDMMC0_OUT_D1: R253.2, U13.N2 (DAT1); also elsewhere on the board
SOM_SDMMC0_OUT_D2: R252.2, U13.K3 (DAT2); also elsewhere on the board
SOM_SDMMC0_OUT_D3: R251.2, U13.N3 (DAT3); also elsewhere on the board
SOM_SDMMC0_OUT_D4: R250.2, U13.N8 (DAT4); also elsewhere on the board
SOM_SDMMC0_OUT_D5: R249.2, U13.K8 (DAT5); also elsewhere on the board
SOM_SDMMC0_OUT_D6: R248.2, U13.N9 (DAT6); also elsewhere on the board
SOM_SDMMC0_OUT_D7: R247.2, U13.K9 (DAT7); also elsewhere on the board
SOM_SDMMC0_OUT_DS: U13.K5 (DS); also elsewhere on the board

Notes on the sheet:
50_eMMC1_MCU
eMMC - Buffer
50Ω ±15% single ended Skew Sig/CK < 100ps(15mm) Max Length 100mm
[ver 1.1.0] Use SAMA7G54 instead

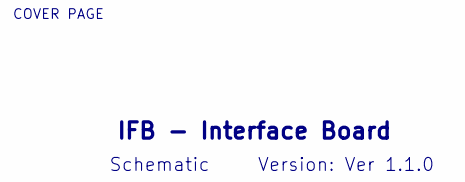
[picture p61: schematic COVER PAGE.kicad_sch, BEE]

Notes on the sheet:
Version: Ver 1.1.0
COVER PAGE
IFB - Interface Board
Schematic
