taitannguyen17022005-dev/BEE-1012-PAY-IF-V110/01_DESIGN/BEE-1012_PAY-IF_V110/_restore_backup_2026-08-10T14-50-42-868/BEE-1012_PAY-IF_V110.kicad_pcb

## KiCad design 01_DESIGN/BEE-1012_PAY-IF_V110/_restore_backup_2026-08-10T14-50-42-868/BEE-1012_PAY-IF_V110.kicad_pcb (continued)

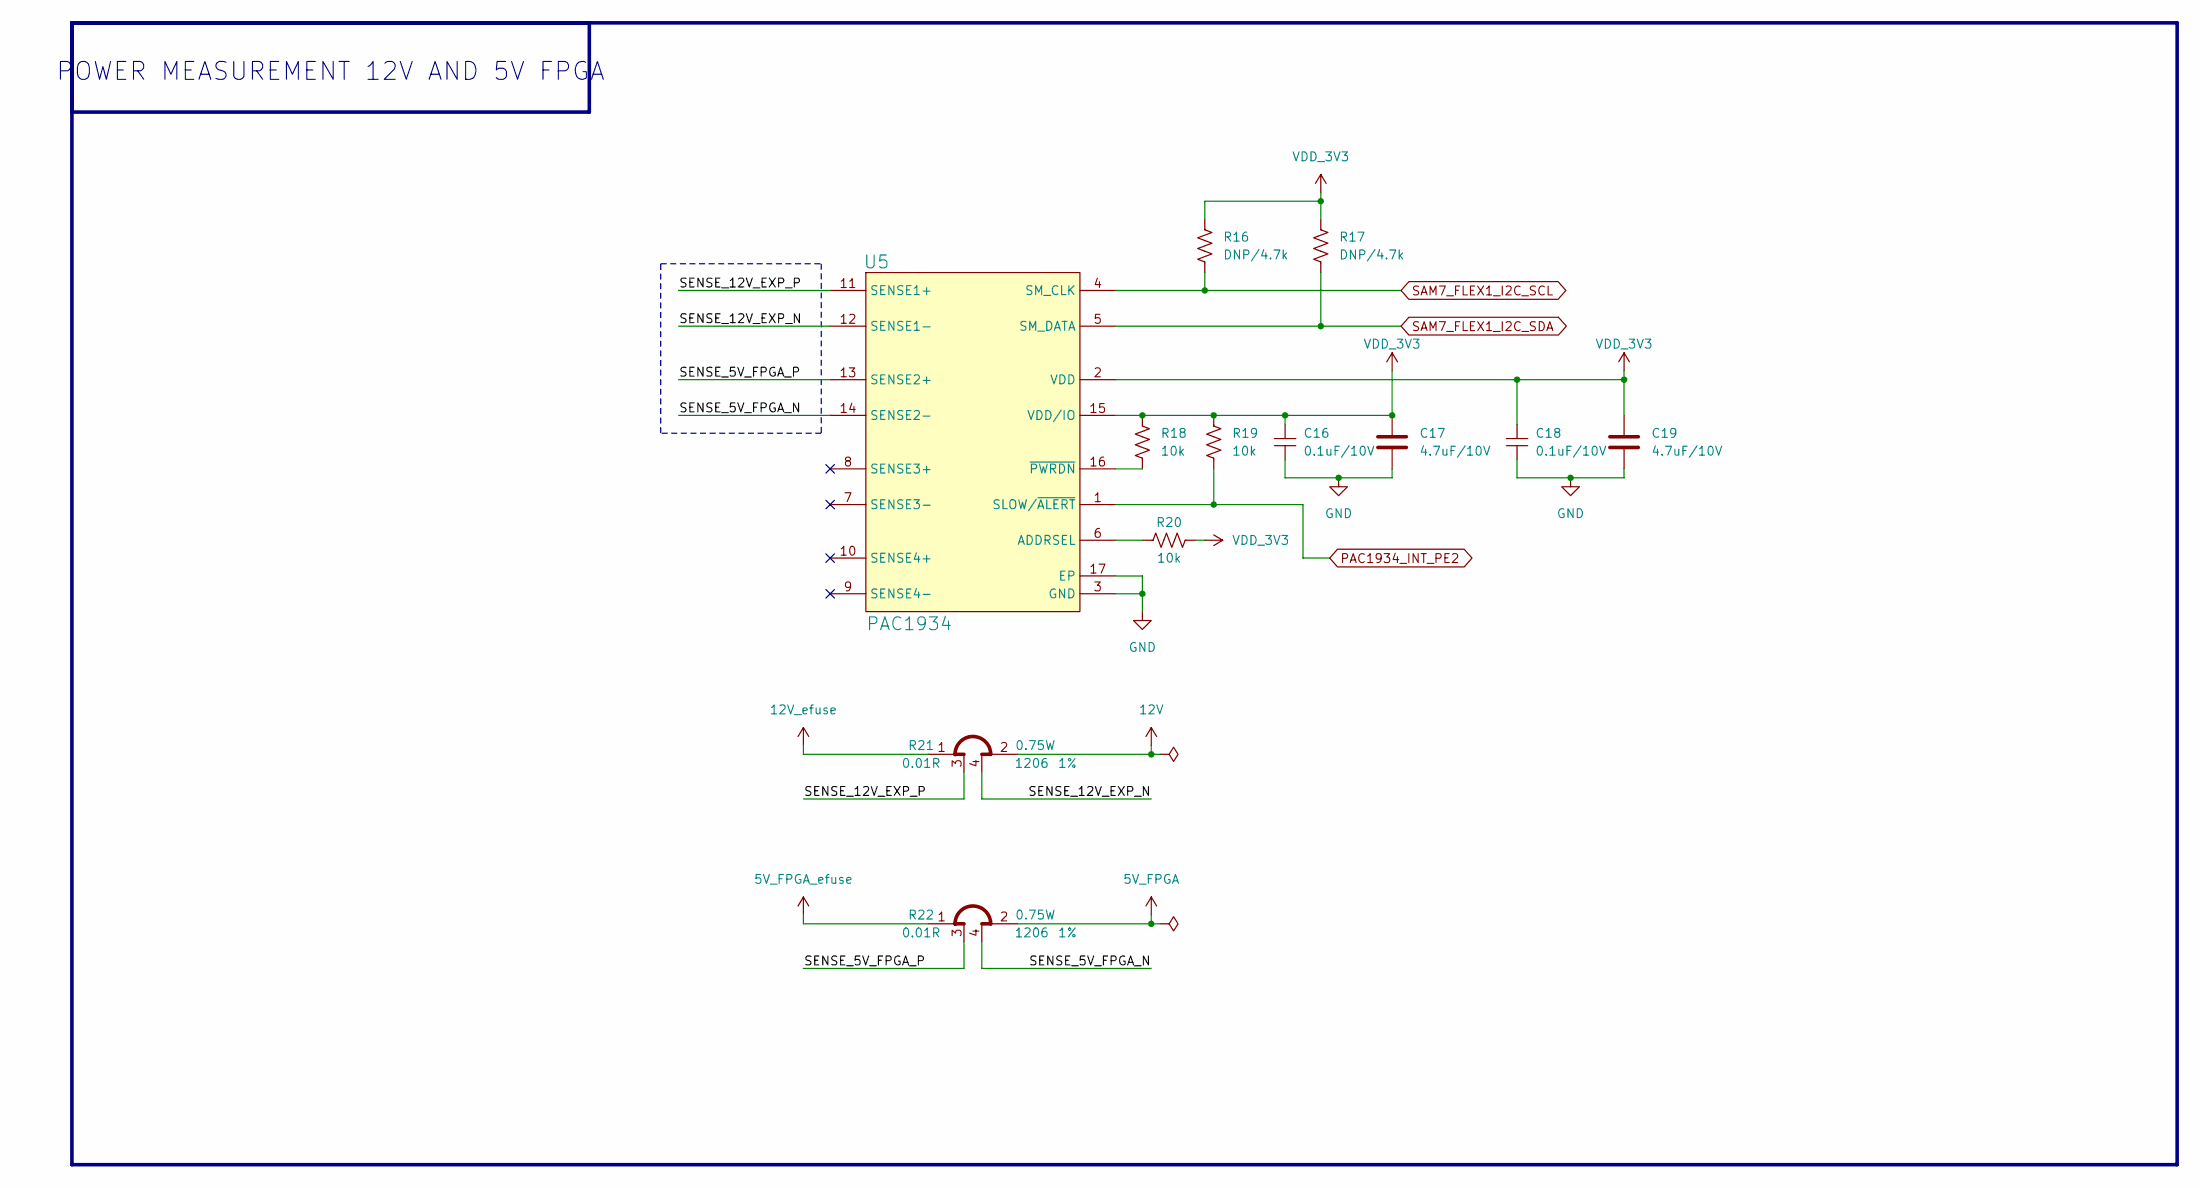
[picture p62: schematic POWER_MEASUREMENT.kicad_sch, BEE]

Parts:
C16, C18: 0.1uF/10V; CAP_C_1005X50_L
C17, C19: 4.7uF/10V; CAP_C_1005X50_L
R16, R17: DNP/4.7k; RES_C_1005x30_L
R18, R19, R20: 10k; RES_C_1005x30_L
R21, R22: Shunt 4 Pin; RES_C_1206_SHUNT; Tolerance 1%; Manufacturer Part Numbe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 KRL1632E-M-R010-F-T5
U5: PAC1934; UQFN-16_4X4_EP2.6X2.6; Manufacturer Part Numbe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 PAC1934T-I/JQ

Connections:
5V_FPGA: R22.2; also elsewhere on the board
5V_FPGA_efuse: R22.1; also elsewhere on the board
12V: R21.2; also elsewhere on the board
12V_efuse: R21.1; also elsewhere on the board
/POWER_MEASUREMENT/SENSE_5V_FPGA_N: R22.4, U5.14 (SENSE2-)
/POWER_MEASUREMENT/SENSE_5V_FPGA_P: R22.3, U5.13 (SENSE2+)
/POWER_MEASUREMENT/SENSE_12V_EXP_N: R21.4, U5.12 (SENSE1-)
/POWER_MEASUREMENT/SENSE_12V_EXP_P: R21.3, U5.11 (SENSE1+)
GND: C16.1, C17.2, C18.1, C19.2, U5.3 (GND), U5.17 (EP); also elsewhere on the board
unnamed: R20.1, U5.6 (ADDRSEL)
unnamed: R18.2, U5.16 (~PWRDN)
PAC1934_INT_PE2: R19.2, U5.1 (SLOW/~ALERT); also elsewhere on the board
SAM7_FLEX1_I2C_SCL: R16.2, U5.4 (SM_CLK); also elsewhere on the board
SAM7_FLEX1_I2C_SDA: R17.2, U5.5 (SM_DATA); also elsewhere on the board
VDD_3V3: C16.2, C17.1, C18.2, C19.1, R16.1, R17.1, R18.1, R19.1, R20.2, U5.2 (VDD), U5.15 (VDD/IO); also elsewhere on the board

Notes on the sheet:
POWER MEASUREMENT 12V AND 5V FPGA

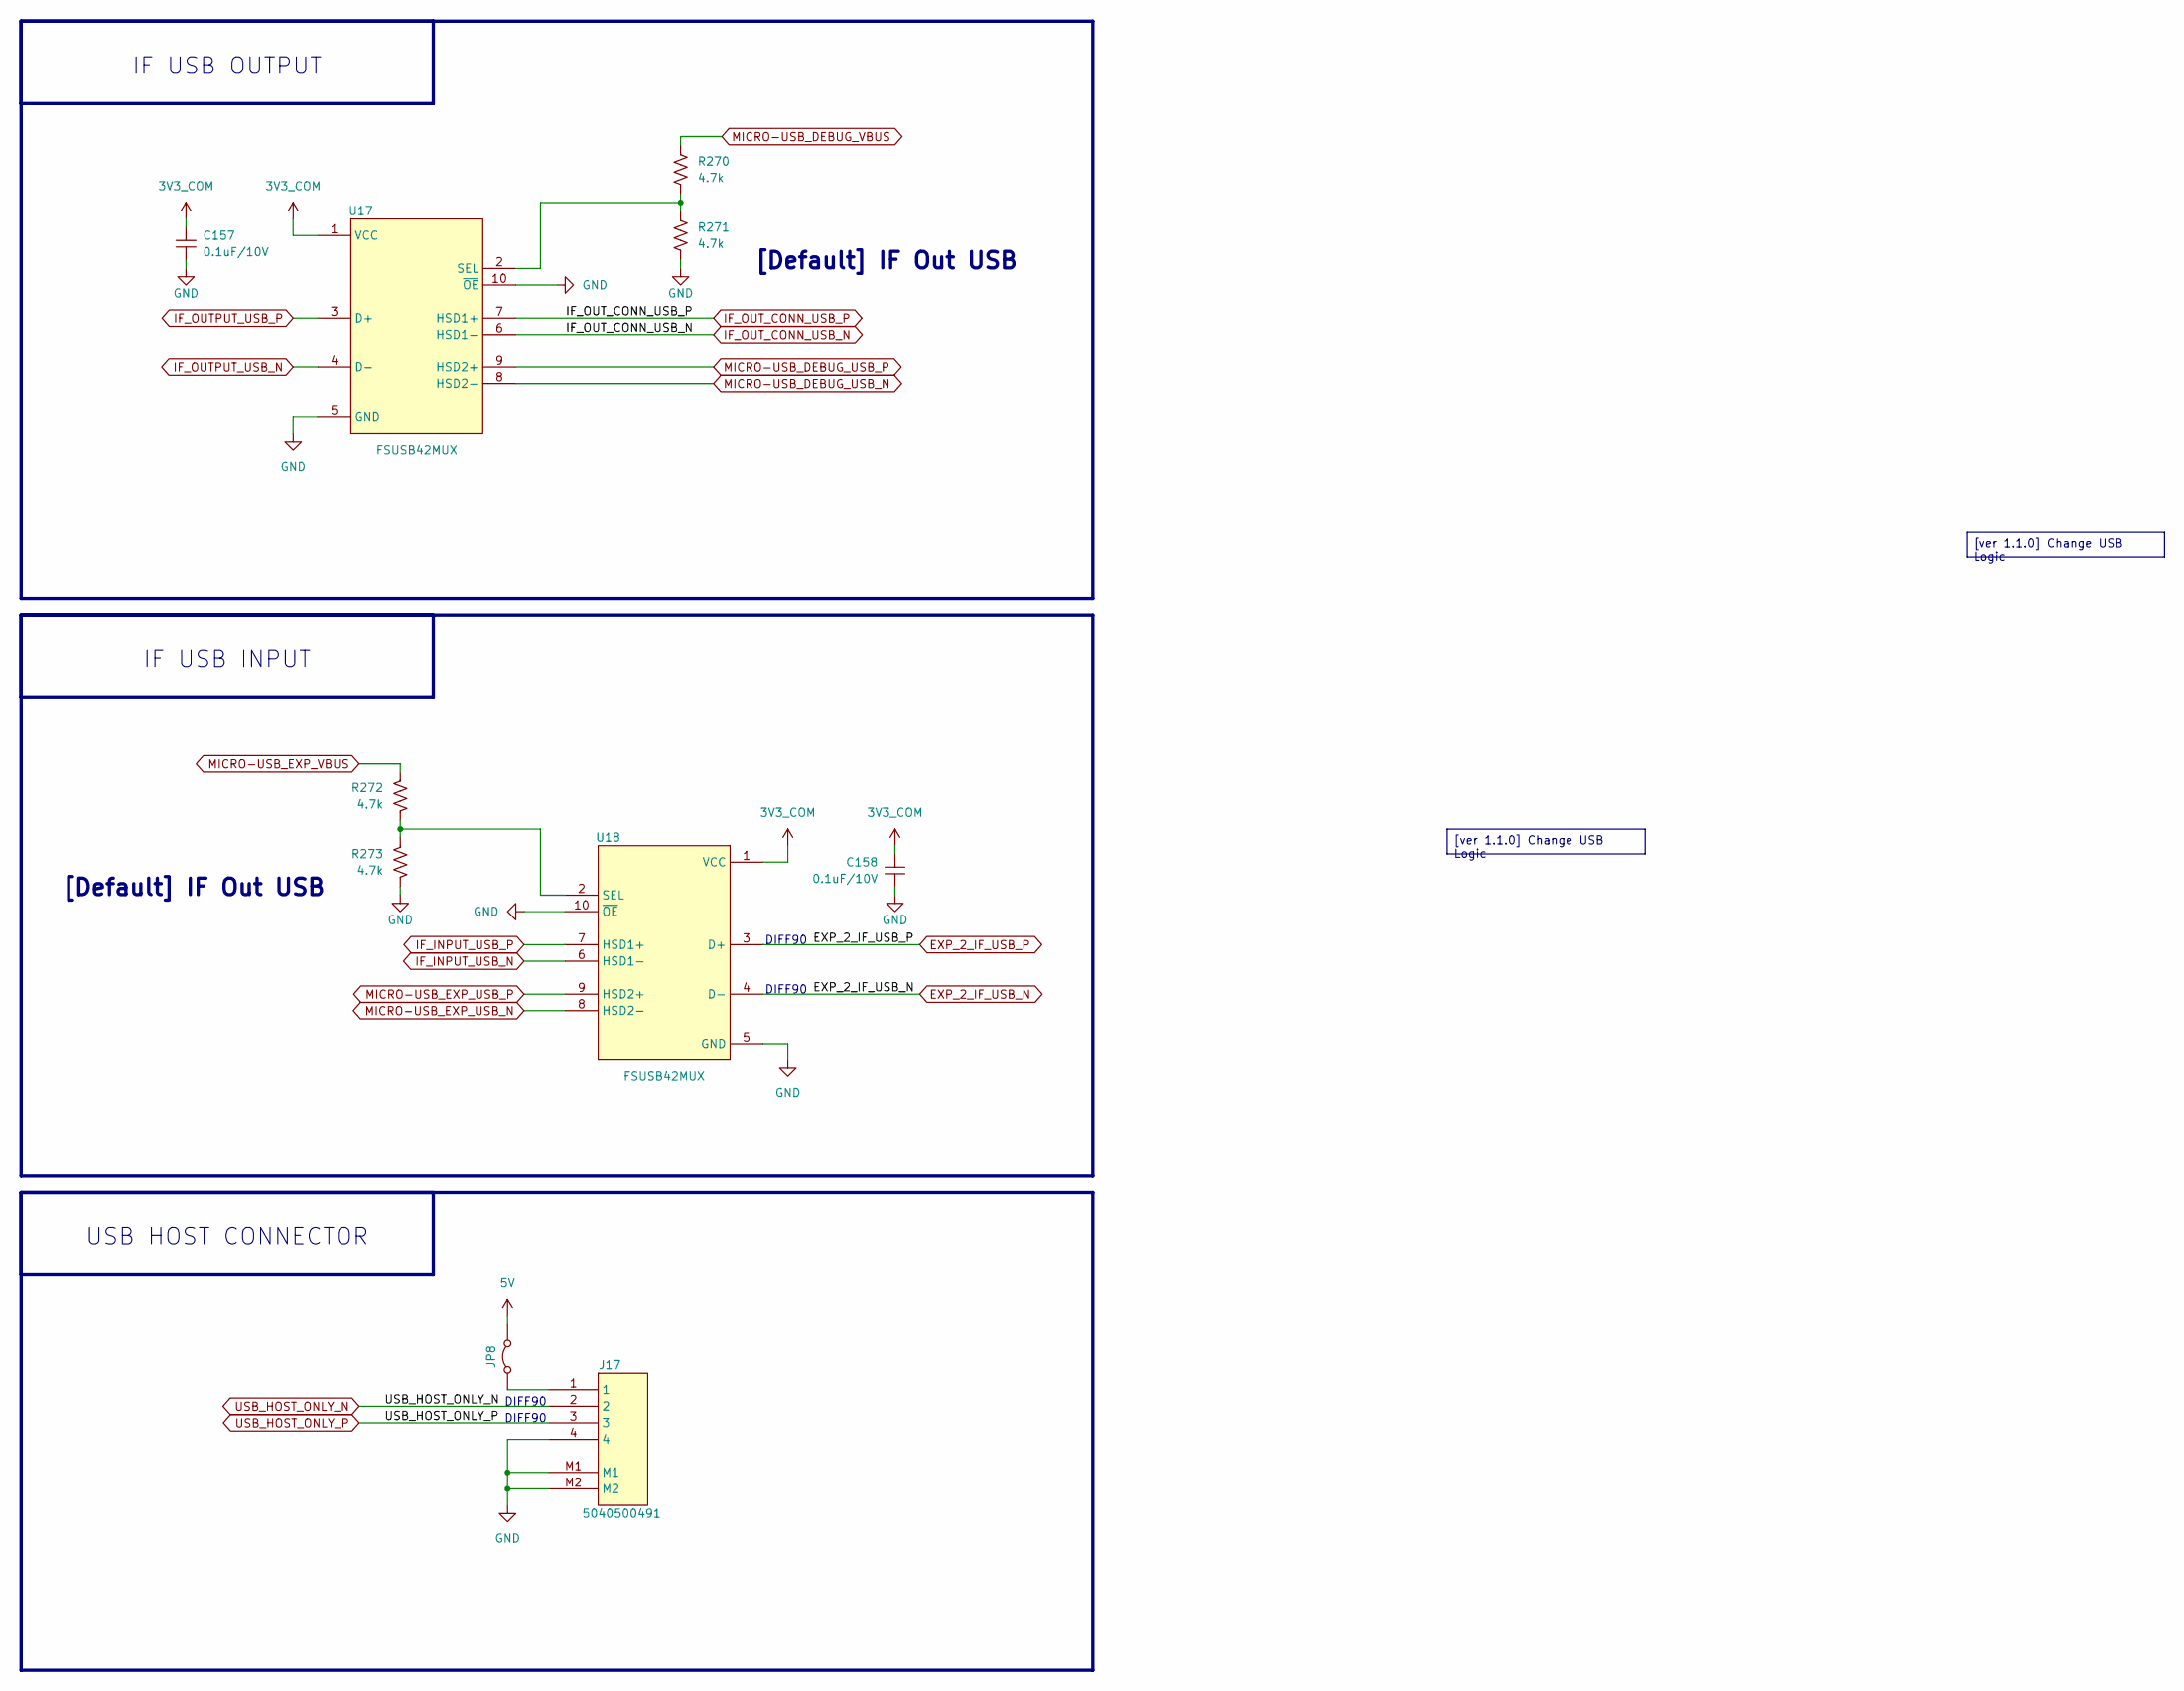
[picture p63: schematic USB_SWITCH.kicad_sch, BEE]

Parts:
C157, C158: 0.1uF/10V; CAP_C_1005X50_L
J17: 5040500491; MOLEX_5040500491
JP8: Jumper_2_Bridged; JUMPER_1608
R270, R271, R272, R273: 4.7k; RES_C_1005x30_L
U17, U18: FSUSB42MUX; SOP50P490X110-10N

Connections:
3V3_COM: C157.2, C158.2, U17.1 (VCC), U18.1 (VCC); also elsewhere on the board
5V: JP8.1 (A); also elsewhere on the board
EXP_2_IF_USB_N: U18.4 (D-); also elsewhere on the board
EXP_2_IF_USB_P: U18.3 (D+); also elsewhere on the board
GND: C157.1, C158.1, J17.4, J17.M1, J17.M2, R271.2, R273.2, U17.5 (GND), U17.10 (~OE), U18.5 (GND), U18.10 (~OE); also elsewhere on the board
IF_INPUT_USB_N: U18.6 (HSD1-); also elsewhere on the board
IF_INPUT_USB_P: U18.7 (HSD1+); also elsewhere on the board
IF_OUTPUT_USB_N: U17.4 (D-); also elsewhere on the board
IF_OUTPUT_USB_P: U17.3 (D+); also elsewhere on the board
IF_OUT_CONN_USB_N: U17.6 (HSD1-); also elsewhere on the board
IF_OUT_CONN_USB_P: U17.7 (HSD1+); also elsewhere on the board
MICRO-USB_DEBUG_USB_N: U17.8 (HSD2-); also elsewhere on the board
MICRO-USB_DEBUG_USB_P: U17.9 (HSD2+); also elsewhere on the board
MICRO-USB_DEBUG_VBUS: R270.1; also elsewhere on the board
MICRO-USB_EXP_USB_N: U18.8 (HSD2-); also elsewhere on the board
MICRO-USB_EXP_USB_P: U18.9 (HSD2+); also elsewhere on the board
MICRO-USB_EXP_VBUS: R272.1; also elsewhere on the board
unnamed: J17.1, JP8.2 (B)
unnamed: R270.2, R271.1, U17.2 (SEL)
unnamed: R272.2, R273.1, U18.2 (SEL)
USB_HOST_ONLY_N: J17.2; also elsewhere on the board
USB_HOST_ONLY_P: J17.3; also elsewhere on the board

Notes on the sheet:
[Default] IF Out USB
DIFF90
IF USB INPUT
USB HOST CONNECTOR
IF USB OUTPUT
[ver 1.1.0] Change USB Logic

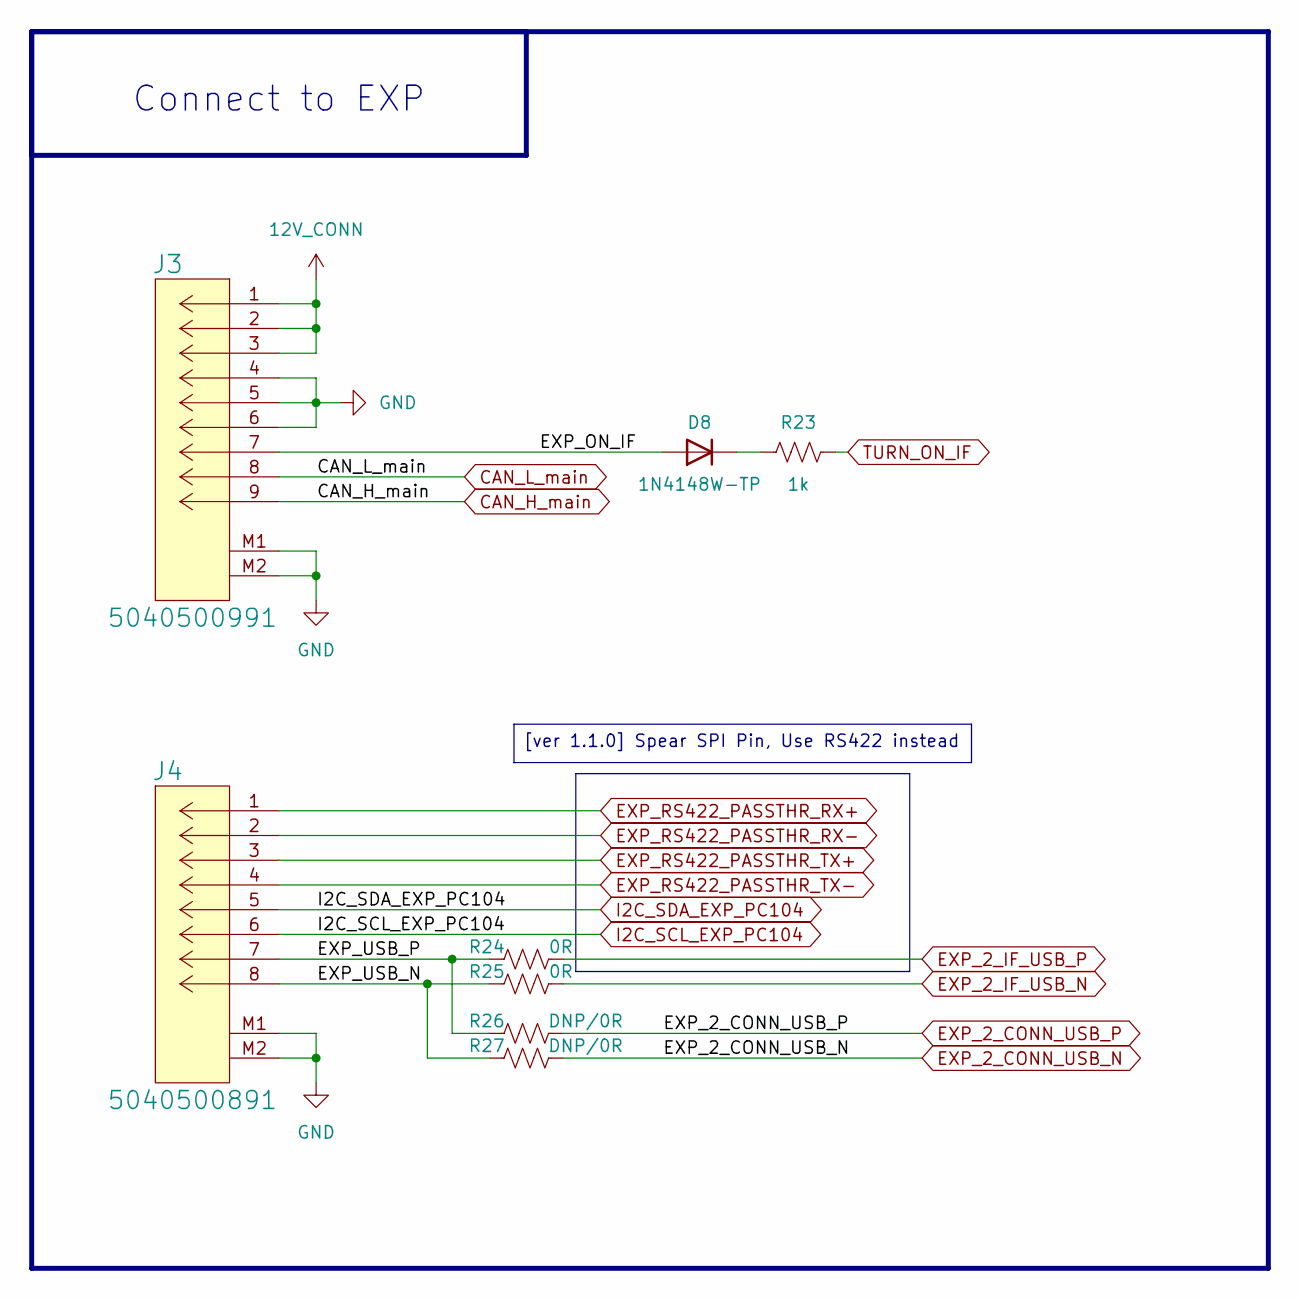
[picture p64: schematic CONNECTOR_EXP.kicad_sch, BEE]

Parts:
D8: 1N4148W-TP; D_SOD-123
J3: 5040500991; MOLEX_5040500991
J4: 5040500891; MOLEX_5040500891
R23: 1k; RES_C_1005x30_L
R24, R25: 0R; RES_C_1005x30_L
R26, R27: DNP/0R; RES_C_1005x30_L

Connections:
12V_CONN: J3.1, J3.2, J3.3; also elsewhere on the board
/CONNECTOR_EXP/EXP_ON_IF: D8.2 (A), J3.7
/CONNECTOR_EXP/EXP_USB_N: J4.8, R25.1, R27.1
/CONNECTOR_EXP/EXP_USB_P: J4.7, R24.1, R26.1
CAN_H_main: J3.9; also elsewhere on the board
CAN_L_main: J3.8; also elsewhere on the board
EXP_2_CONN_USB_N: R27.2; also elsewhere on the board
EXP_2_CONN_USB_P: R26.2; also elsewhere on the board
EXP_2_IF_USB_N: R25.2; also elsewhere on the board
EXP_2_IF_USB_P: R24.2; also elsewhere on the board
EXP_RS422_PASSTHR_RX+: J4.1; also elsewhere on the board
EXP_RS422_PASSTHR_RX-: J4.2; also elsewhere on the board
EXP_RS422_PASSTHR_TX+: J4.3; also elsewhere on the board
EXP_RS422_PASSTHR_TX-: J4.4; also elsewhere on the board
GND: J3.4, J3.5, J3.6, J3.M1, J3.M2, J4.M1, J4.M2; also elsewhere on the board
I2C_SCL_EXP_PC104: J4.6; also elsewhere on the board
I2C_SDA_EXP_PC104: J4.5; also elsewhere on the board
unnamed: D8.1 (K), R23.1
TURN_ON_IF: R23.2; also elsewhere on the board

Notes on the sheet:
Connect to EXP
[ver 1.1.0] Spear SPI Pin, Use RS422 instead

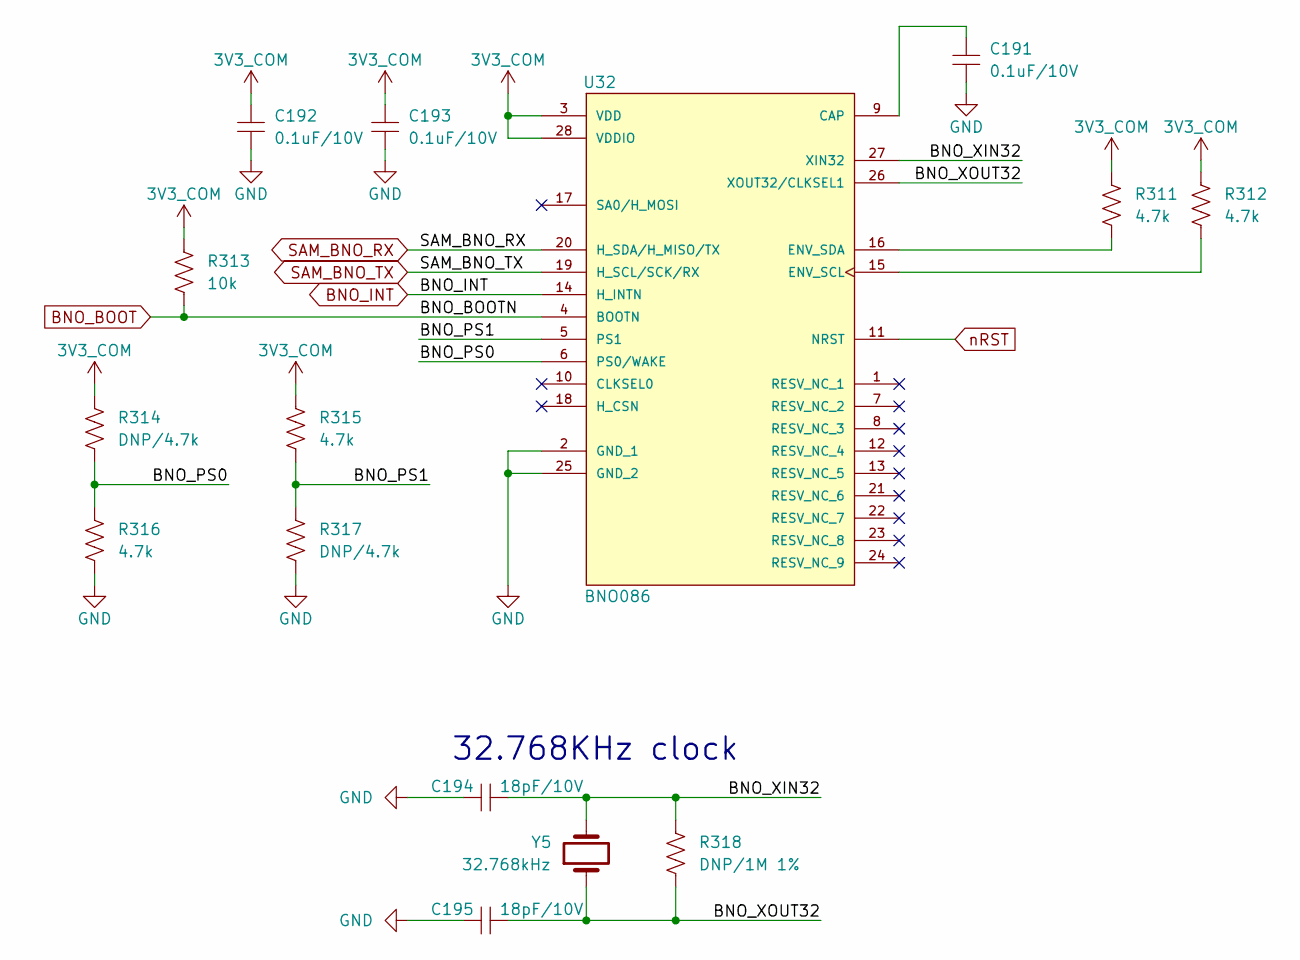
[picture p65: schematic IMU.kicad_sch, BEE]

Parts:
C191, C192, C193: 0.1uF/10V; CAP_C_1005X50_L
C194, C195: 18pF/10V; CAP_C_1005X50_L
R311, R312, R315, R316: 4.7k; RES_C_1005x30_L
R313: 10k; RES_C_1005x30_L
R314, R317: DNP/4.7k; RES_C_1005x30_L
R318: DNP/1M 1%; RES_C_1005x30_L
U32: BNO086; IC_BNO086; PARTREV v1.17
Y5: 32.768kHz; CRYSTAL_NX2012SA

Connections:
3V3_COM: C192.2, C193.2, R311.1, R312.1, R313.1, R314.1, R315.1, U32.3 (VDD), U32.28 (VDDIO); also elsewhere on the board
/IMU/BNO_PS0: R314.2, R316.1, U32.6 (PS0/WAKE)
/IMU/BNO_PS1: R315.2, R317.1, U32.5 (PS1)
/IMU/BNO_XIN32: C194.1, R318.1, U32.27 (XIN32), Y5.2
/IMU/BNO_XOUT32: C195.1, R318.2, U32.26 (XOUT32/CLKSEL1), Y5.1
BNO_BOOT: R313.2, U32.4 (BOOTN); also elsewhere on the board
BNO_INT: U32.14 (H_INTN); also elsewhere on the board
GND: C191.1, C192.1, C193.1, C194.2, C195.2, R316.2, R317.2, U32.2 (GND_1), U32.25 (GND_2); also elsewhere on the board
unnamed: C191.2, U32.9 (CAP)
unnamed: R312.2, U32.15 (ENV_SCL)
unnamed: R311.2, U32.16 (ENV_SDA)
SAM_BNO_RX: U32.20 (H_SDA/H_MISO/TX); also elsewhere on the board
SAM_BNO_TX: U32.19 (H_SCL/SCK/RX); also elsewhere on the board
nRST: U32.11 (NRST); also elsewhere on the board

Notes on the sheet:
32.768KHz clock

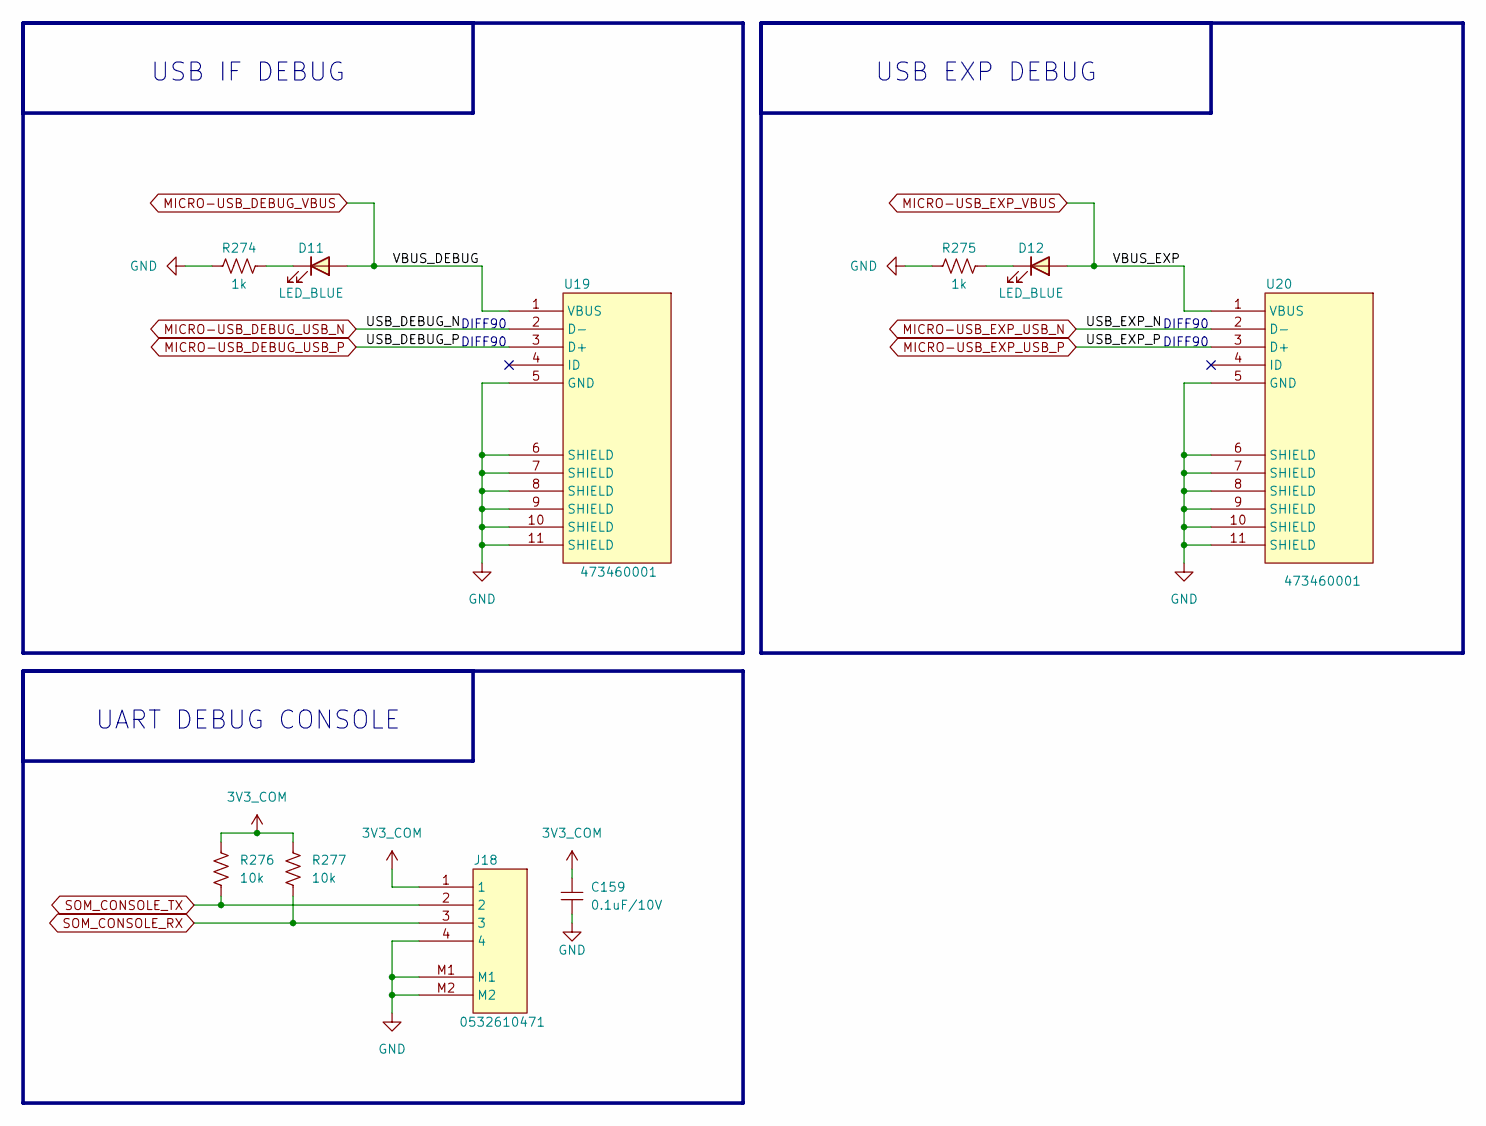
[picture p66: schematic DEBUG_CONSOLE.kicad_sch, BEE]

Parts:
C159: 0.1uF/10V; CAP_C_1005X50_L
D11, D12: LED_BLUE; LED_0603_1608Metric
J18: 0532610471; MOLEX_0532610471
R274, R275: 1k; RES_C_1005x30_L
R276, R277: 10k; RES_C_1005x30_L
U19, U20: 473460001; 47346-0001_MOL; Manufacturer_Part_Number 473460001

Connections:
3V3_COM: C159.2, J18.1, R276.1, R277.1; also elsewhere on the board
GND: C159.1, J18.4, J18.M1, J18.M2, R274.1, R275.1, U19.5 (GND), U19.6 (SHIELD), U19.7 (SHIELD), U19.8 (SHIELD), U19.9 (SHIELD), U19.10 (SHIELD), U19.11 (SHIELD), U20.5 (GND), U20.6 (SHIELD), U20.7 (SHIELD), U20.8 (SHIELD), U20.9 (SHIELD), U20.10 (SHIELD), U20.11 (SHIELD); also elsewhere on the board
MICRO-USB_DEBUG_USB_N: U19.2 (D-); also elsewhere on the board
MICRO-USB_DEBUG_USB_P: U19.3 (D+); also elsewhere on the board
MICRO-USB_DEBUG_VBUS: D11.2 (A), U19.1 (VBUS); also elsewhere on the board
MICRO-USB_EXP_USB_N: U20.2 (D-); also elsewhere on the board
MICRO-USB_EXP_USB_P: U20.3 (D+); also elsewhere on the board
MICRO-USB_EXP_VBUS: D12.2 (A), U20.1 (VBUS); also elsewhere on the board
unnamed: D11.1 (K), R274.2
unnamed: D12.1 (K), R275.2
SOM_CONSOLE_RX: J18.3, R277.2; also elsewhere on the board
SOM_CONSOLE_TX: J18.2, R276.2; also elsewhere on the board

Notes on the sheet:
DIFF90
USB EXP DEBUG
UART DEBUG CONSOLE
USB IF DEBUG

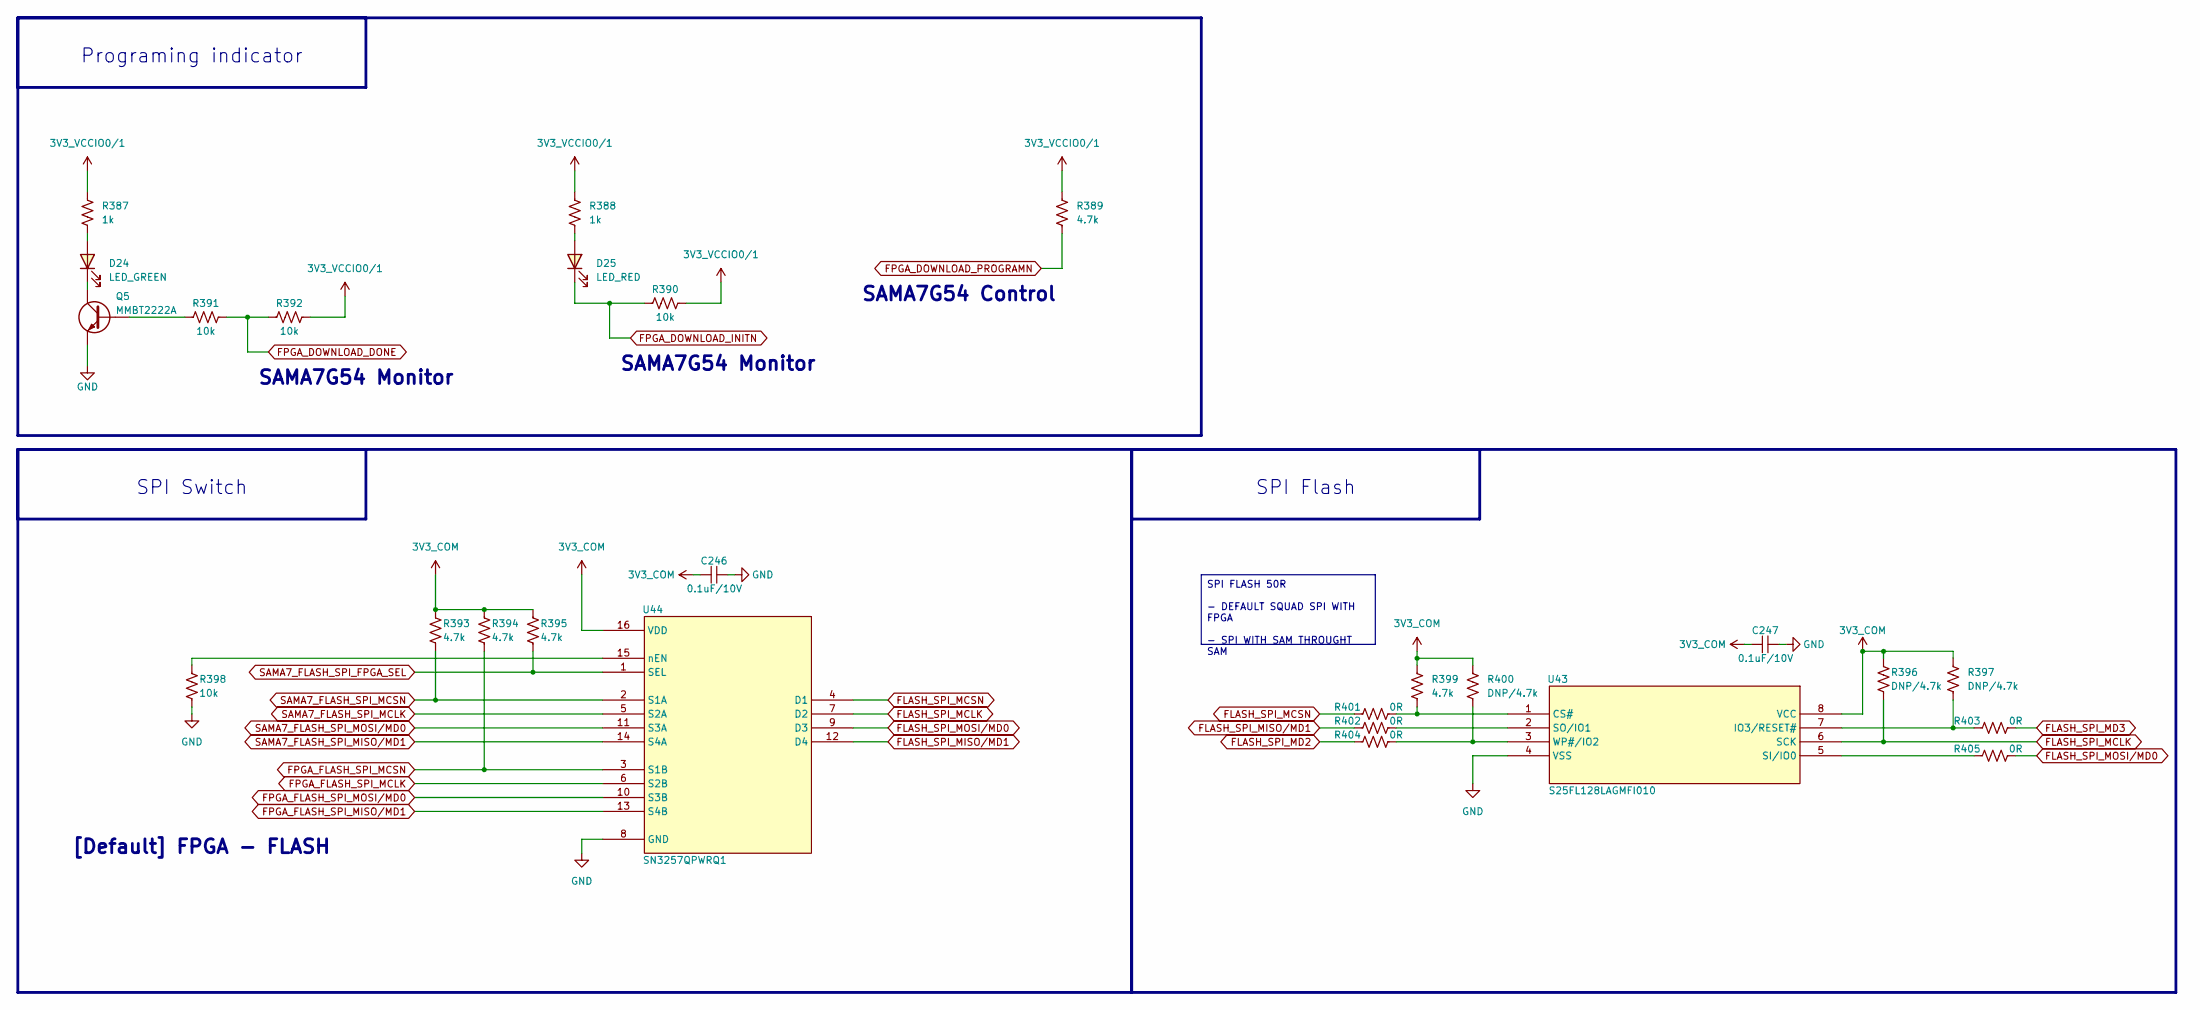
[picture p67: schematic FPGA_extFLASH.kicad_sch, BEE]

Parts:
C246, C247: 0.1uF/10V; CAP_C_1005X50_L
D24: LED_GREEN; LED_0603_1608Metric
D25: LED_RED; LED_0603_1608Metric
Q5: MMBT2222A; SOT95P240X120-3N
R387, R388: 1k; RES_C_1005x30_L
R389, R393, R394, R395, R399: 4.7k; RES_C_1005x30_L
R390, R391, R392, R398: 10k; RES_C_1005x30_L
R396, R397, R400: DNP/4.7k; RES_C_1005x30_L
R401, R402, R403, R404, R405: 0R; RES_C_1005x30_L
U43: S25FL128LAGMFI010; SOIC-8_5.3x5.3mm_P1.27mm; Manufacturer_Part_Number S25FL128LAGMFI010
U44: SN3257QPWRQ1; SOIC_PRQ1_TEX; Manufacturer_Part_Number SN3257QPWRQ1

Connections:
3V3_COM: C246.2, C247.2, R393.1, R394.1, R395.1, R396.1, R397.1, R399.1, R400.1, U43.8 (VCC), U44.16 (VDD); also elsewhere on the board
3V3_VCCIO0/1: R387.1, R388.1, R389.1, R390.2, R392.2; also elsewhere on the board
FLASH_SPI_MCLK: R396.2, U43.6 (SCK), U44.7 (D2)
FLASH_SPI_MCSN: R401.1, U44.4 (D1)
FLASH_SPI_MD2: R404.1; also elsewhere on the board
FLASH_SPI_MD3: R403.2; also elsewhere on the board
FLASH_SPI_MISO/MD1: R402.1, U44.12 (D4)
FLASH_SPI_MOSI/MD0: R405.2, U44.9 (D3)
FPGA_DOWNLOAD_DONE: R391.2, R392.1; also elsewhere on the board
FPGA_DOWNLOAD_INITN: D25.1 (K), R390.1; also elsewhere on the board
FPGA_DOWNLOAD_PROGRAMN: R389.2; also elsewhere on the board
FPGA_FLASH_SPI_MCLK: U44.6 (S2B); also elsewhere on the board
FPGA_FLASH_SPI_MCSN: R394.2, U44.3 (S1B); also elsewhere on the board
FPGA_FLASH_SPI_MISO/MD1: U44.13 (S4B); also elsewhere on the board
FPGA_FLASH_SPI_MOSI/MD0: U44.10 (S3B); also elsewhere on the board
GND: C246.1, C247.1, Q5.E, R398.2, U43.4 (VSS), U44.8 (GND); also elsewhere on the board
unnamed: D24.2 (A), R387.2
unnamed: D24.1 (K), Q5.C
unnamed: D25.2 (A), R388.2
unnamed: Q5.B, R391.1
unnamed: R399.2, R401.2, U43.1 (CS#)
unnamed: R397.2, R403.1, U43.7 (IO3/RESET#)
unnamed: R405.1, U43.5 (SI/IO0)
unnamed: R402.2, U43.2 (SO/IO1)
unnamed: R400.2, R404.2, U43.3 (WP#/IO2)
unnamed: R398.1, U44.15 (nEN)
SAMA7_FLASH_SPI_FPGA_SEL: R395.2, U44.1 (SEL); also elsewhere on the board
SAMA7_FLASH_SPI_MCLK: U44.5 (S2A); also elsewhere on the board
SAMA7_FLASH_SPI_MCSN: R393.2, U44.2 (S1A); also elsewhere on the board
SAMA7_FLASH_SPI_MISO/MD1: U44.14 (S4A); also elsewhere on the board
SAMA7_FLASH_SPI_MOSI/MD0: U44.11 (S3A); also elsewhere on the board

Notes on the sheet:
[Default] FPGA - FLASH
SPI Switch
SAMA7G54 Monitor
Programing indicator
SAMA7G54 Control
SPI Flash
SPI FLASH 50R - DEFAULT SQUAD SPI WITH FPGA - SPI WITH SAM THROUGHT SAM
