taitannguyen17022005-dev/BEE-1012-PAY-IF-V110/01_DESIGN/BEE-1012_PAY-IF_V110/_restore_backup_2026-08-10T14-50-42-868/BEE-1012_PAY-IF_V110.kicad_pcb

## KiCad design 01_DESIGN/BEE-1012_PAY-IF_V110/_restore_backup_2026-08-10T14-50-42-868/BEE-1012_PAY-IF_V110.kicad_pcb (continued)

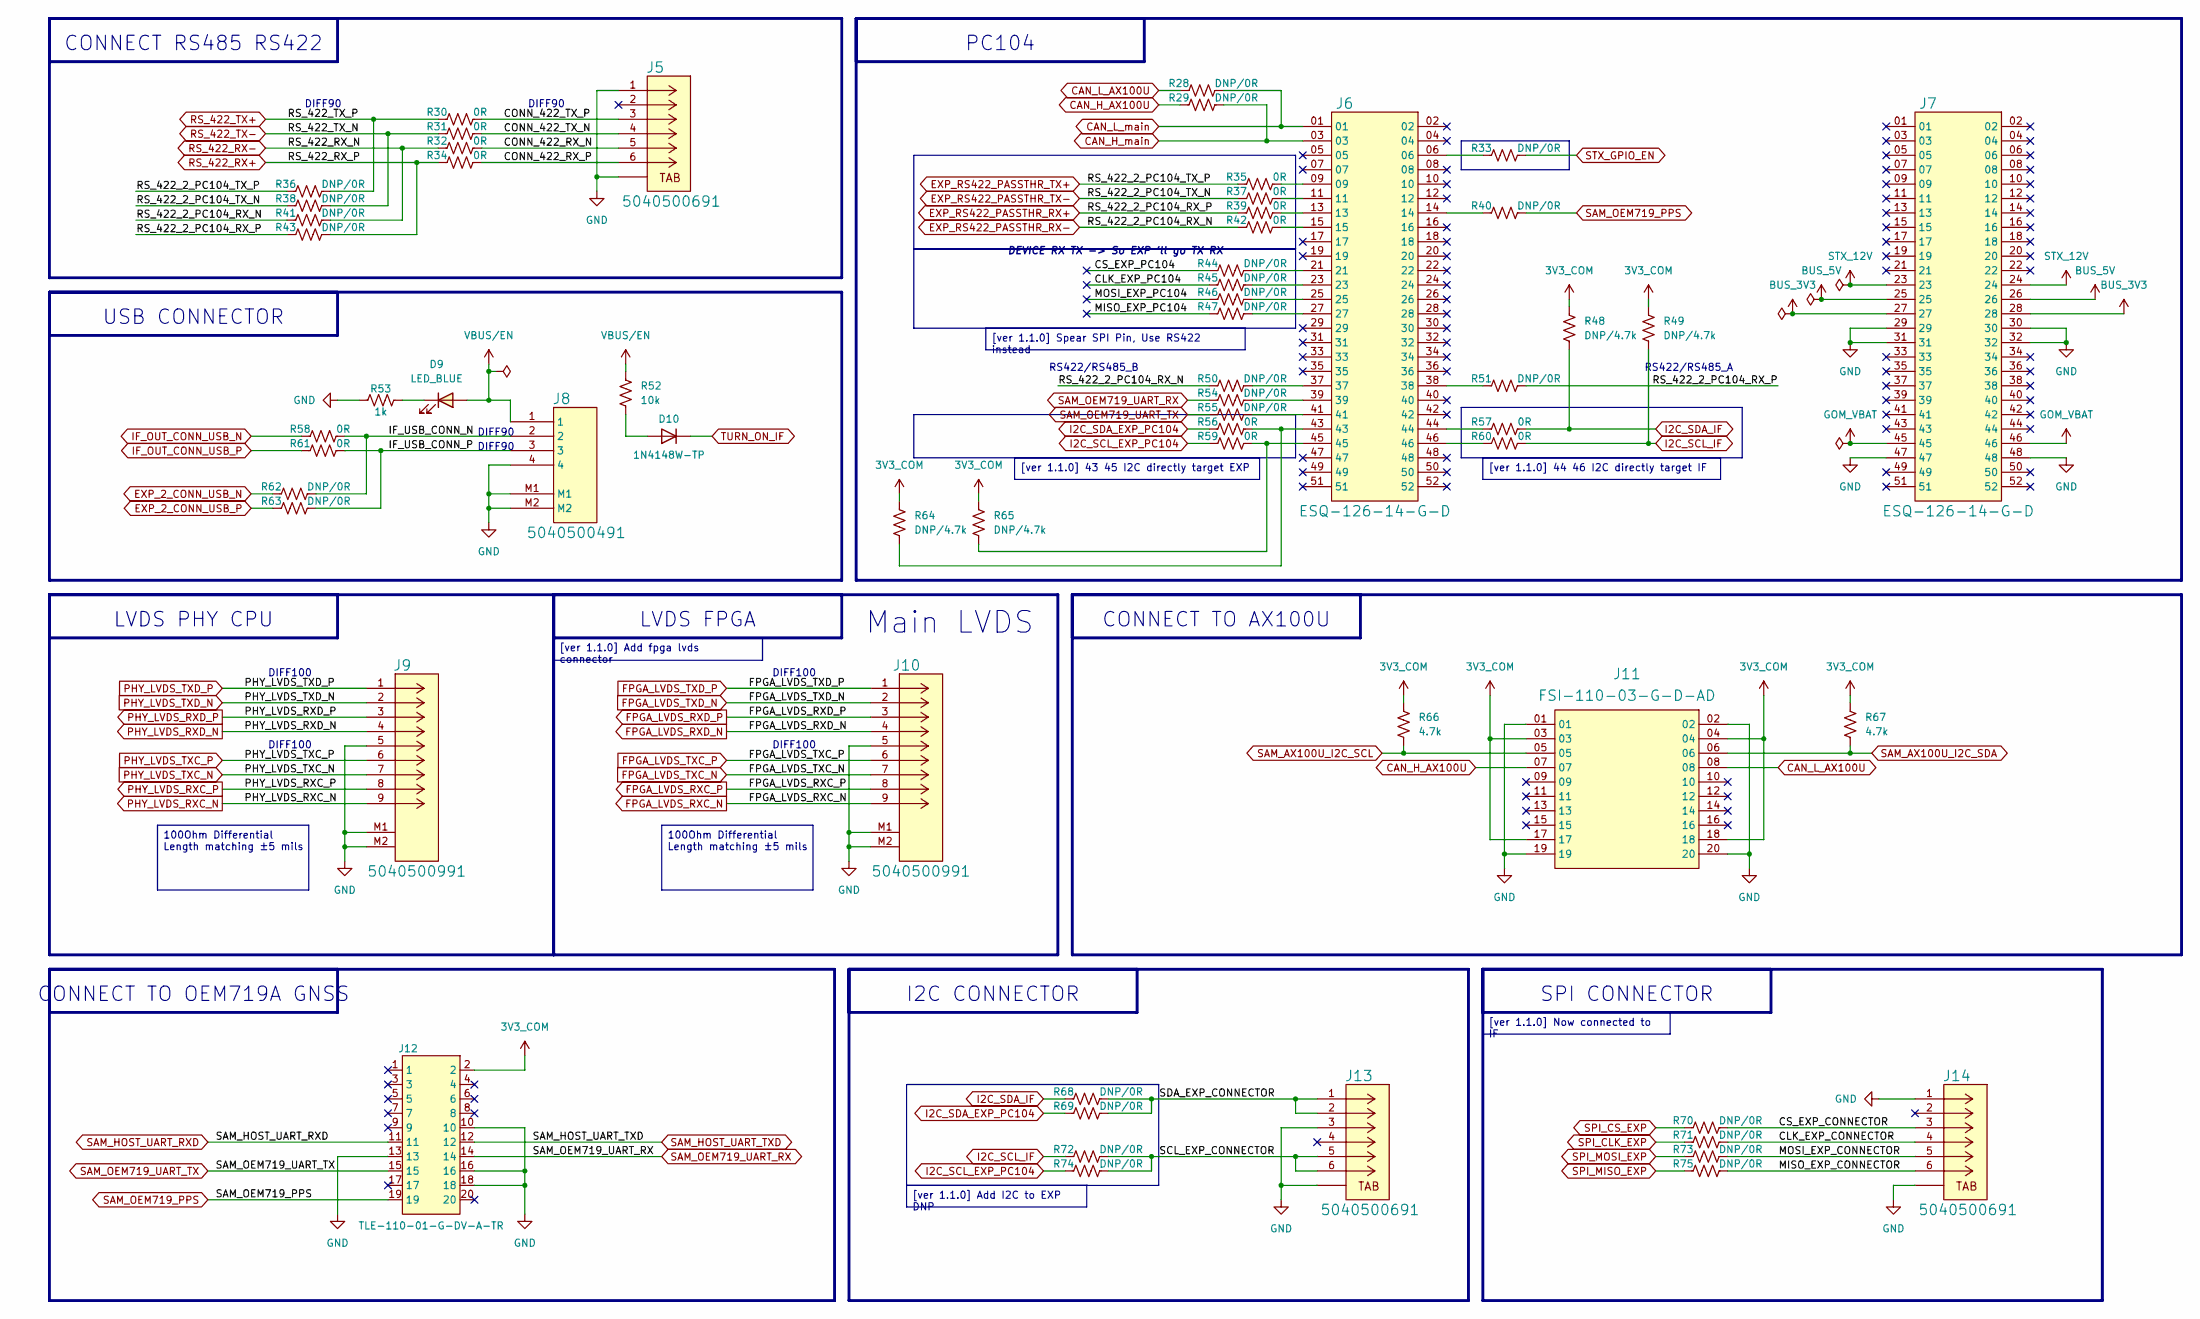
[picture p68: schematic CONNECTOR_INTERFACE.kicad_sch, BEE]

Parts:
D9: LED_BLUE; LED_0603_1608Metric
D10: 1N4148W-TP; D_SOD-123
J5, J13, J14: 5040500691; MOLEX_5040500691; Manufacturer_Part_Number 5040500691
J6, J7: ESQ-126-14-G-D
J8: 5040500491; MOLEX_5040500491
J9, J10: 5040500991; MOLEX_5040500991
J11: FSI-110-03-G-D-AD; SAMTEC_FSI-110-03-X-D-AD-TR
J12: TLE-110-01-G-DV-A-TR; SAMTEC-TLE-110-01-X-DV-A
R28, R29, R33, R36, R38, R40, R41, R43, R44, R45, R46, R47, R50, R51, R54, R55, R62, R63, R68, R69, R70, R71, R72, R73, R74, R75: DNP/0R; RES_C_1005x30_L
R30, R31, R32, R34, R35, R37, R39, R42, R56, R57, R58, R59, R60, R61: 0R; RES_C_1005x30_L
R48, R49, R64, R65: DNP/4.7k; RES_C_1005x30_L
R52: 10k; RES_C_1005x30_L
R53: 1k; RES_C_1005x30_L
R66, R67: 4.7k; RES_C_1005x30_L

Connections:
3V3_COM: J11.03, J11.04, J11.17, J11.18, J12.2, R48.2, R49.2, R64.2, R65.2, R66.2, R67.2; also elsewhere on the board
/CONNECTOR_INTERFACE/CLK_EXP_CONNECTOR: J14.4, R71.2
/CONNECTOR_INTERFACE/CLK_EXP_PC104: R45.1
/CONNECTOR_INTERFACE/CONN_422_RX_N: J5.5, R32.2
/CONNECTOR_INTERFACE/CONN_422_RX_P: J5.6, R34.2
/CONNECTOR_INTERFACE/CONN_422_TX_N: J5.4, R31.2
/CONNECTOR_INTERFACE/CONN_422_TX_P: J5.3, R30.2
/CONNECTOR_INTERFACE/CS_EXP_CONNECTOR: J14.3, R70.2
/CONNECTOR_INTERFACE/CS_EXP_PC104: R44.1
/CONNECTOR_INTERFACE/IF_USB_CONN_N: J8.2, R58.2, R62.2
/CONNECTOR_INTERFACE/IF_USB_CONN_P: J8.3, R61.2, R63.2
/CONNECTOR_INTERFACE/MISO_EXP_CONNECTOR: J14.6, R75.2
/CONNECTOR_INTERFACE/MISO_EXP_PC104: R47.1
/CONNECTOR_INTERFACE/MOSI_EXP_CONNECTOR: J14.5, R73.2
/CONNECTOR_INTERFACE/MOSI_EXP_PC104: R46.1
/CONNECTOR_INTERFACE/SCL_EXP_CONNECTOR: J13.5, J13.6, R72.2, R74.2
/CONNECTOR_INTERFACE/SDA_EXP_CONNECTOR: J13.1, J13.2, R68.2, R69.2
BUS_3V3: J7.27, J7.28
BUS_5V: J7.25, J7.26
CAN_H_AX100U: J11.07, R29.1; also elsewhere on the board
CAN_H_main: J6.03, R29.2; also elsewhere on the board
CAN_L_AX100U: J11.08, R28.1; also elsewhere on the board
CAN_L_main: J6.01, R28.2; also elsewhere on the board
EXP_2_CONN_USB_N: R62.1; also elsewhere on the board
EXP_2_CONN_USB_P: R63.1; also elsewhere on the board
EXP_RS422_PASSTHR_RX+: R39.1, R43.1, R51.2; also elsewhere on the board
EXP_RS422_PASSTHR_RX-: R41.1, R42.1, R50.1; also elsewhere on the board
EXP_RS422_PASSTHR_TX+: R35.1, R36.1; also elsewhere on the board
EXP_RS422_PASSTHR_TX-: R37.1, R38.1; also elsewhere on the board
FPGA_LVDS_RXC_N: J10.9; also elsewhere on the board
FPGA_LVDS_RXC_P: J10.8; also elsewhere on the board
FPGA_LVDS_RXD_N: J10.4; also elsewhere on the board
FPGA_LVDS_RXD_P: J10.3; also elsewhere on the board
FPGA_LVDS_TXC_N: J10.7; also elsewhere on the board
FPGA_LVDS_TXC_P: J10.6; also elsewhere on the board
FPGA_LVDS_TXD_N: J10.2; also elsewhere on the board
FPGA_LVDS_TXD_P: J10.1; also elsewhere on the board
GND: J5.1, J5.7, J7.29, J7.30, J7.31, J7.32, J7.47, J7.48, J8.4, J8.M1, J8.M2, J9.5, J9.M1, J9.M2, J10.5, J10.M1, J10.M2, J11.01, J11.02, J11.19, J11.20, J12.10, J12.13, J12.16, J12.18, J13.3, J13.7, J14.1, J14.7, R53.1; also elsewhere on the board
GOM_VBAT: J7.45, J7.46
I2C_SCL_EXP_PC104: R59.1, R74.1; also elsewhere on the board
I2C_SCL_IF: R49.1, R60.2, R72.1; also elsewhere on the board
I2C_SDA_EXP_PC104: R56.1, R69.1; also elsewhere on the board
I2C_SDA_IF: R48.1, R57.2, R68.1; also elsewhere on the board
IF_OUT_CONN_USB_N: R58.1; also elsewhere on the board
IF_OUT_CONN_USB_P: R61.1; also elsewhere on the board
unnamed: D9.1 (K), R53.2
unnamed: D10.2 (A), R52.2
unnamed: J6.06, R33.1
unnamed: J6.09, R35.2
unnamed: J6.11, R37.2
unnamed: J6.13, R39.2
unnamed: J6.14, R40.1
unnamed: J6.15, R42.2
unnamed: J6.21, R44.2
unnamed: J6.23, R45.2
unnamed: J6.25, R46.2
unnamed: J6.27, R47.2
unnamed: J6.37, R50.2
unnamed: J6.38, R51.1
unnamed: J6.39, R54.2
unnamed: J6.41, R55.2
unnamed: J6.43, R56.2, R64.1
unnamed: J6.44, R57.1
unnamed: J6.45, R59.2, R65.1
unnamed: J6.46, R60.1
PHY_LVDS_RXC_N: J9.9; also elsewhere on the board
PHY_LVDS_RXC_P: J9.8; also elsewhere on the board
PHY_LVDS_RXD_N: J9.4; also elsewhere on the board
PHY_LVDS_RXD_P: J9.3; also elsewhere on the board
PHY_LVDS_TXC_N: J9.7; also elsewhere on the board
PHY_LVDS_TXC_P: J9.6; also elsewhere on the board
PHY_LVDS_TXD_N: J9.2; also elsewhere on the board
PHY_LVDS_TXD_P: J9.1; also elsewhere on the board
RS_422_RX+: R34.1, R43.2; also elsewhere on the board
RS_422_RX-: R32.1, R41.2; also elsewhere on the board
RS_422_TX+: R30.1, R36.2; also elsewhere on the board
RS_422_TX-: R31.1, R38.2; also elsewhere on the board
SAM_AX100U_I2C_SCL: J11.05, R66.1; also elsewhere on the board
SAM_AX100U_I2C_SDA: J11.06, R67.1; also elsewhere on the board
SAM_HOST_UART_RXD: J12.11; also elsewhere on the board
SAM_HOST_UART_TXD: J12.12; also elsewhere on the board
SAM_OEM719_PPS: J12.19, R40.2; also elsewhere on the board
SAM_OEM719_UART_RX: J12.14, R54.1; also elsewhere on the board
SAM_OEM719_UART_TX: J12.15, R55.1; also elsewhere on the board
SPI_CLK_EXP: R71.1; also elsewhere on the board
SPI_CS_EXP: R70.1; also elsewhere on the board
SPI_MISO_EXP: R75.1; also elsewhere on the board
SPI_MOSI_EXP: R73.1; also elsewhere on the board
STX_12V: J7.23, J7.24
STX_GPIO_EN: R33.2; also elsewhere on the board
TURN_ON_IF: D10.1 (K); also elsewhere on the board
VBUS/EN: D9.2 (A), J8.1, R52.1

Notes on the sheet:
DIFF100
Main LVDS
DIFF90
USB CONNECTOR
CONNECT RS485 RS422
LVDS FPGA
CONNECT TO AX100U
I2C CONNECTOR
SPI CONNECTOR
RS422/RS485_B
PC104
CONNECT TO OEM719A GNSS
LVDS PHY CPU
RS422/RS485_A
DEVICE RX TX -> So EXP 'll go TX RX
100Ohm Differential Length matching ±5 mils
[ver 1.1.0] 44 46 I2C directly target IF
[ver 1.1.0] Spear SPI Pin, Use RS422 instead
[ver 1.1.0] Add fpga lvds connector
[ver 1.1.0] Add I2C to EXP DNP
[ver 1.1.0] 43 45 I2C directly target EXP
[ver 1.1.0] Now connected to IF

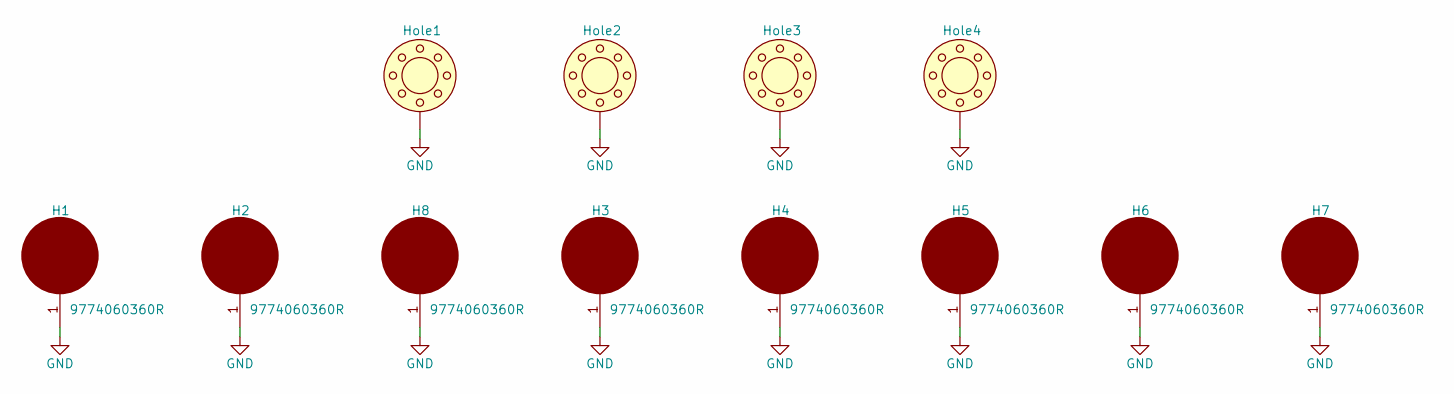
[picture p69: schematic MOUNTING_HOLE.kicad_sch, BEE]

Parts:
H1, H2, H3, H4, H5, H6, H7, H8: 9774060360R; M4.4
Hole1, Hole2, Hole3, Hole4: hole_space; HEX-M3_NoVia

Connections:
GND: H1.1 (1_1), H2.1 (1_1), H3.1 (1_1), H4.1 (1_1), H5.1 (1_1), H6.1 (1_1), H7.1 (1_1), H8.1 (1_1), Hole1.1 (1_1), Hole2.1 (1_1), Hole3.1 (1_1), Hole4.1 (1_1); also elsewhere on the board

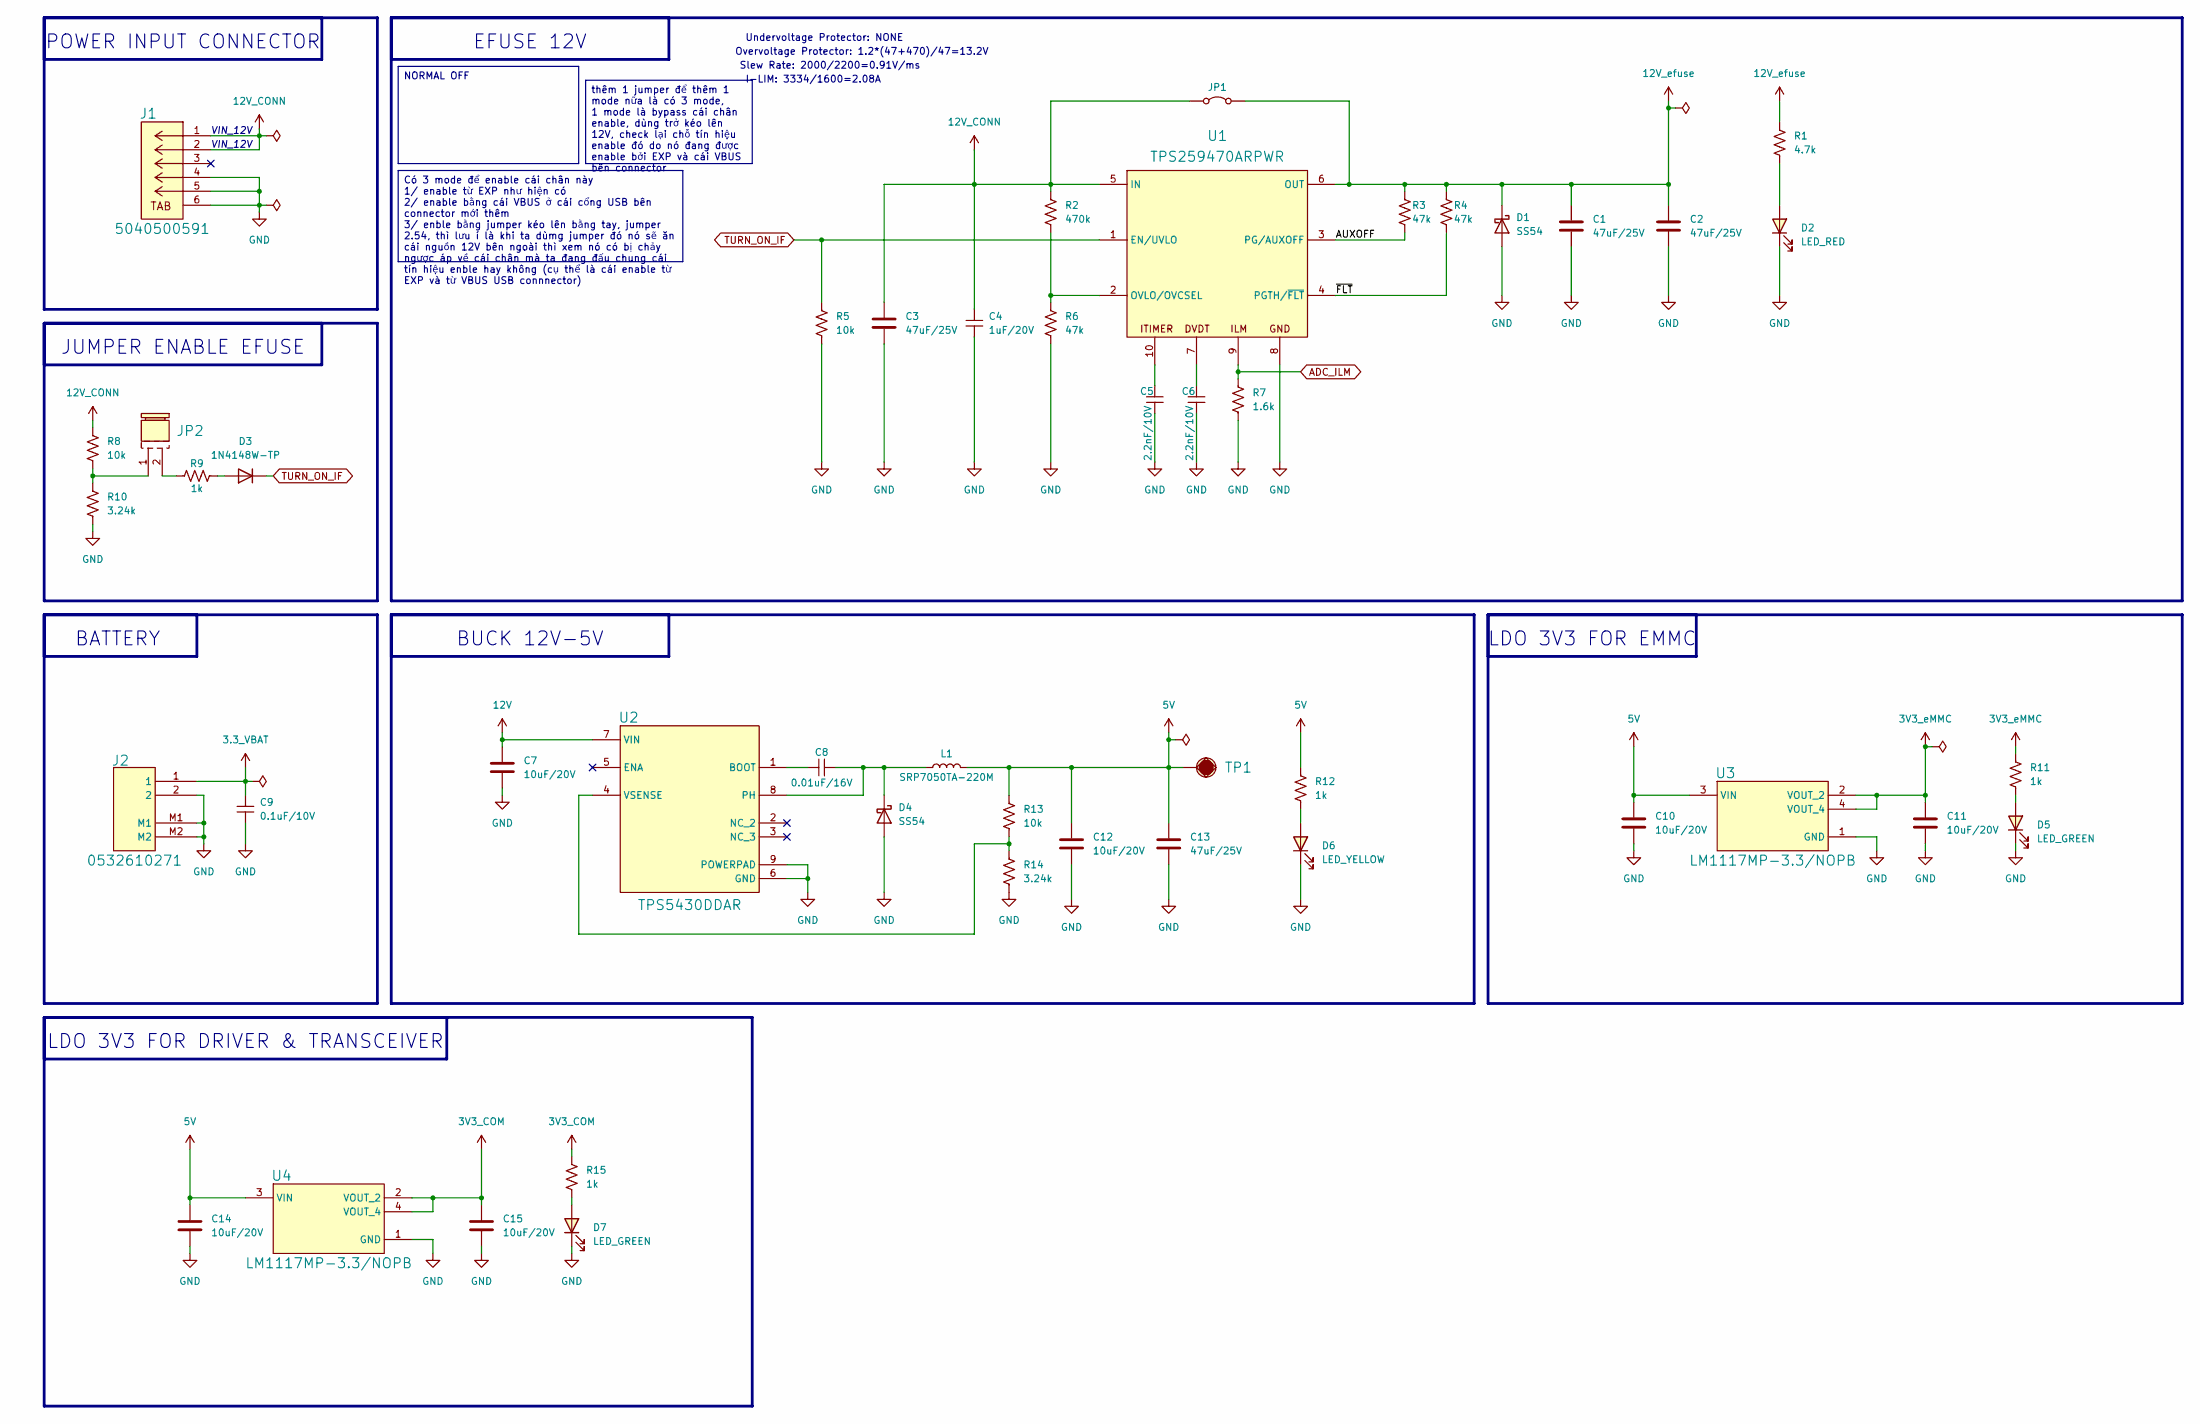
[picture p70: schematic POWER.kicad_sch, BEE]

Parts:
C1, C2, C3, C13: 47uF/25V; CAP_C_3225X80
C4: 1uF/20V; CAP_C_1005X50_L
C5, C6: 2.2nF/10V; CAP_C_1005X50_L
C7, C10, C11, C12, C14, C15: 10uF/20V; CAP_C_2012X110
C8: 0.01uF/16V; CAP_C_1608X80_L
C9: 0.1uF/10V; CAP_C_1005X50_L
D1, D4: SS54; D_SMA
D2: LED_RED; LED_0603_1608Metric
D3: 1N4148W-TP; D_SOD-123
D5, D7: LED_GREEN; LED_0603_1608Metric
D6: LED_YELLOW; LED_0603_1608Metric
J1: 5040500591; Manufacturer_Part_Number 5040500591
J2: 0532610271; MOLEX_0532610271
JP1: Jumper_2_Bridged; JUMPER_1608
JP2: JUMPER_254P_NOPLACE; PinHeader_1x02_P2.54mm_Horizontal
L1: SRP7050TA-220M
R1: 4.7k; RES_C_1005x30_L
R2: 470k; RES_C_1005x30_L
R3, R4, R6: 47k; RES_C_1005x30_L
R5, R8, R13: 10k; RES_C_1005x30_L
R7: 1.6k; RES_C_1005x30_L
R9, R11, R12, R15: 1k; RES_C_1005x30_L
R10, R14: 3.24k; RES_C_1005x30_L
TP1: ${VALUE}; Test point
U1: TPS259470ARPWR; VQFN-HR-10
U2: TPS5430DDAR; CONV_TPS5430DDAR
U3, U4: LM1117MP-3.3/NOPB; SOT-223

Connections:
3.3_VBAT: C9.2, J2.1; also elsewhere on the board
3V3_COM: C15.1, R15.1, U4.2 (VOUT_2), U4.4 (VOUT_4); also elsewhere on the board
3V3_eMMC: C11.1, R11.1, U3.2 (VOUT_2), U3.4 (VOUT_4); also elsewhere on the board
5V: C10.1, C12.1, C13.1, C14.1, L1.2, R12.1, R13.1, TP1.1 (1_1), U3.3 (VIN), U4.3 (VIN); also elsewhere on the board
12V: C7.1, U2.7 (VIN); also elsewhere on the board
12V_CONN: C3.1, C4.2, J1.1, J1.2, JP1.1 (A), R2.1, R8.1, U1.5 (IN); also elsewhere on the board
12V_efuse: C1.1, C2.1, D1.1 (K), JP1.2 (B), R1.1, R3.1, R4.1, U1.6 (OUT); also elsewhere on the board
/POWER/AUXOFF: R3.2, U1.3 (PG/AUXOFF)
/POWER/~FLT: R4.2, U1.4 (PGTH/~FLT)
ADC_ILM: R7.1, U1.9 (ILM); also elsewhere on the board
GND: C1.2, C2.2, C3.2, C4.1, C5.1, C6.1, C7.2, C9.1, C10.2, C11.2, C12.2, C13.2, C14.2, C15.2, D1.2 (A), D2.1 (K), D4.2 (A), D5.1 (K), D6.1 (K), D7.1 (K), J1.4, J1.5, J1.6, J2.2, J2.M1, J2.M2, R5.2, R6.2, R7.2, R10.2, R14.2, U1.8 (GND), U2.6 (GND), U2.9 (POWERPAD), U3.1 (GND), U4.1 (GND); also elsewhere on the board
unnamed: D2.2 (A), R1.2
unnamed: D3.2 (A), R9.2
unnamed: C8.2, D4.1 (K), L1.1, U2.8 (PH)
unnamed: D5.2 (A), R11.2
unnamed: D6.2 (A), R12.2
unnamed: D7.2 (A), R15.2
unnamed: JP2.1, R8.2, R10.1
unnamed: JP2.2, R9.1
unnamed: C6.2, U1.7 (DVDT)
unnamed: C5.2, U1.10 (ITIMER)
unnamed: R2.2, R6.1, U1.2 (OVLO/OVCSEL)
unnamed: C8.1, U2.1 (BOOT)
unnamed: R13.2, R14.1, U2.4 (VSENSE)
TURN_ON_IF: D3.1 (K), R5.1, U1.1 (EN/UVLO); also elsewhere on the board

Notes on the sheet:
I-LIM: 3334/1600=2.08A
BATTERY
Overvoltage Protector: 1.2*(47+470)/47=13.2V
POWER INPUT CONNECTOR
Slew Rate: 2000/2200=0.91V/ms
LDO 3V3 FOR DRIVER & TRANSCEIVER
Undervoltage Protector: NONE
VIN_12V
JUMPER ENABLE EFUSE
BUCK 12V-5V
EFUSE 12V
LDO 3V3 FOR EMMC
NORMAL OFF
Có 3 mode để enable cái chân này 1/ enable từ EXP như hiện có 2/ enable bằng cái VBUS ở cái cổng USB bên connector mới thêm 3/ enble bằng jumper kéo lên bằng tay, jumper 2.54, thì lưu í là khi ta dùmg jumper đó nó sẽ ăn cái nguồn 12V bên ngoài thì xem nó có bị chảy ngược áp về cái chân mà ta đang đ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
thêm 1 jumper để thêm 1 mode nữa là có 3 mode, 1 mode là bypass cái chân enable, dùng trở kéo lên 12V, check lại chỗ tín hiệu enable đó do nó đang được enable bởi EXP và cái VBUS bên connector

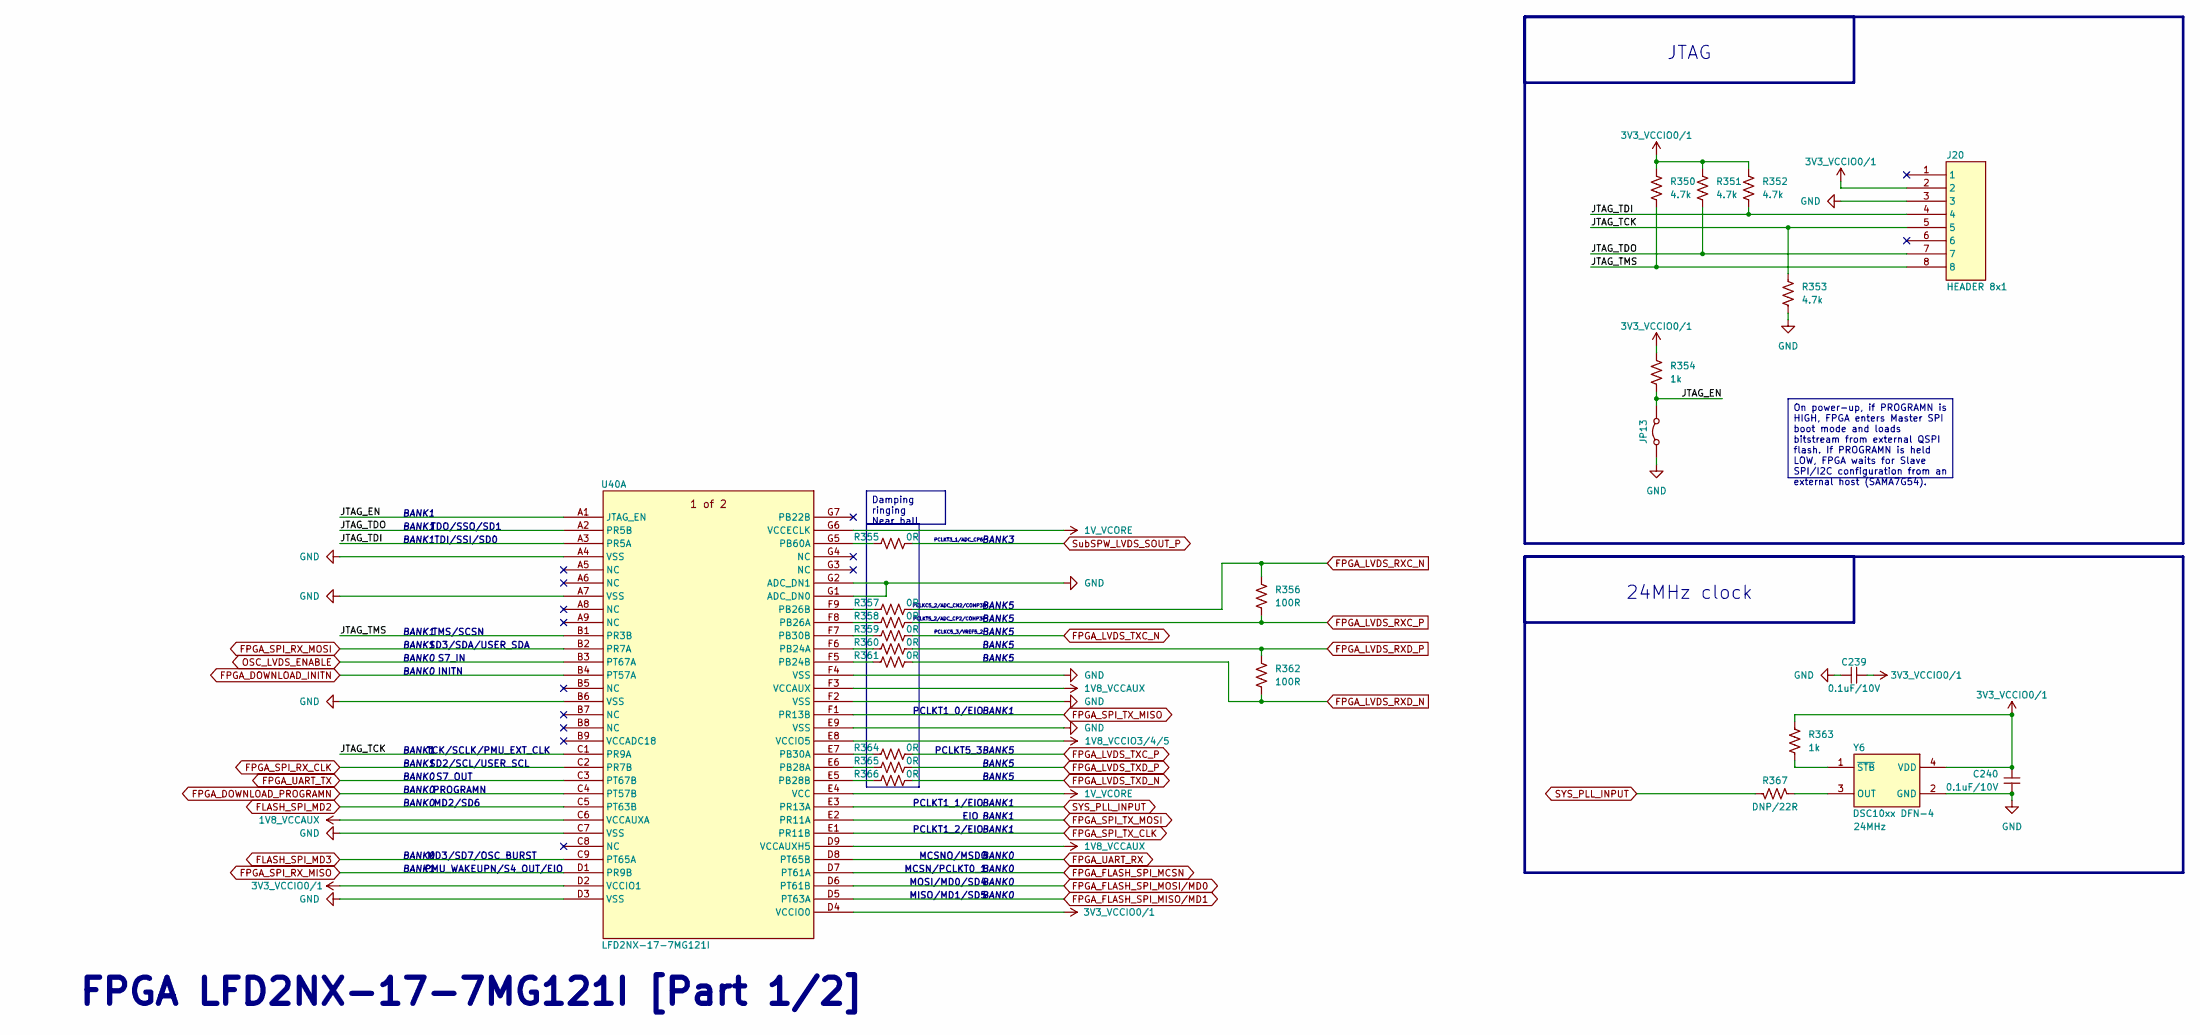
[picture p71: schematic FPGA_PART1.kicad_sch, BEE]

Parts:
C239, C240: 0.1uF/10V; CAP_C_1005X50_L
J20: HEADER 8x1; SAMTEC_TSM-108-01-L-SV-P-TR
JP13: Jumper_2_Bridged; JUMPER_1608
R350, R351, R352, R353: 4.7k; RES_C_1005x30_L
R354, R363: 1k; RES_C_1005x30_L
R355, R357, R358, R359, R360, R361, R364, R365, R366: 0R; RES_C_1005x30_L
R356, R362: 100R; RES_C_1005x30_L
R367: DNP/22R; RES_C_1005x30_L
U40: LFD2NX-17-7MG121I; csfBGA121_LAT; Manufacturer_Part_Number LFD2NX-17-7MG121I
Y6: DSC10xx DFN-4; DFN-4_2.5x2; Manufacturer Part Numbe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 DSC1001DI5-024.0000T

Connections:
1V8_VCCAUX: U40.C6 (VCCAUXA), U40.D9 (VCCAUXH5), U40.F3 (VCCAUX); also elsewhere on the board
1V8_VCCIO3/4/5: U40.E8 (VCCIO5); also elsewhere on the board
1V_VCORE: U40.E4 (VCC), U40.G6 (VCCECLK); also elsewhere on the board
3V3_VCCIO0/1: C239.1, C240.2, J20.2, R350.1, R351.1, R352.1, R354.1, R363.1, U40.D2 (VCCIO1), U40.D4 (VCCIO0), Y6.4 (VDD); also elsewhere on the board
/FPGA_PART1/JTAG_EN: JP13.2 (B), R354.2, U40.A1 (JTAG_EN)
/FPGA_PART1/JTAG_TCK: J20.5, R353.1, U40.C1 (PR9A)
/FPGA_PART1/JTAG_TDI: J20.4, R352.2, U40.A3 (PR5A)
/FPGA_PART1/JTAG_TDO: J20.7, R351.2, U40.A2 (PR5B)
/FPGA_PART1/JTAG_TMS: J20.8, R350.2, U40.B1 (PR3B)
FLASH_SPI_MD2: U40.C5 (PT63B); also elsewhere on the board
FLASH_SPI_MD3: U40.C9 (PT65A); also elsewhere on the board
FPGA_DOWNLOAD_INITN: U40.B4 (PT57A); also elsewhere on the board
FPGA_DOWNLOAD_PROGRAMN: U40.C4 (PT57B); also elsewhere on the board
FPGA_FLASH_SPI_MCSN: U40.D7 (PT61A); also elsewhere on the board
FPGA_FLASH_SPI_MISO/MD1: U40.D5 (PT63A); also elsewhere on the board
FPGA_FLASH_SPI_MOSI/MD0: U40.D6 (PT61B); also elsewhere on the board
FPGA_LVDS_RXC_N: R356.1, R357.2; also elsewhere on the board
FPGA_LVDS_RXC_P: R356.2, R358.2; also elsewhere on the board
FPGA_LVDS_RXD_N: R361.2, R362.2; also elsewhere on the board
FPGA_LVDS_RXD_P: R360.2, R362.1; also elsewhere on the board
FPGA_LVDS_TXC_N: R359.2; also elsewhere on the board
FPGA_LVDS_TXC_P: R364.2; also elsewhere on the board
FPGA_LVDS_TXD_N: R366.2; also elsewhere on the board
FPGA_LVDS_TXD_P: R365.2; also elsewhere on the board
FPGA_SPI_RX_CLK: U40.C2 (PR7B); also elsewhere on the board
FPGA_SPI_RX_MISO: U40.D1 (PR9B); also elsewhere on the board
FPGA_SPI_RX_MOSI: U40.B2 (PR7A); also elsewhere on the board
FPGA_SPI_TX_CLK: U40.E1 (PR11B); also elsewhere on the board
FPGA_SPI_TX_MISO: U40.F1 (PR13B); also elsewhere on the board
FPGA_SPI_TX_MOSI: U40.E2 (PR11A); also elsewhere on the board
FPGA_UART_RX: U40.D8 (PT65B); also elsewhere on the board
FPGA_UART_TX: U40.C3 (PT67B); also elsewhere on the board
GND: C239.2, C240.1, J20.3, JP13.1 (A), R353.2, U40.A4 (VSS), U40.A7 (VSS), U40.B6 (VSS), U40.C7 (VSS), U40.D3 (VSS), U40.E9 (VSS), U40.F2 (VSS), U40.F4 (VSS), U40.G1 (ADC_DN0), U40.G2 (ADC_DN1), Y6.2 (GND); also elsewhere on the board
unnamed: R360.1, U40.F6 (PB24A)
unnamed: R361.1, U40.F5 (PB24B)
unnamed: R358.1, U40.F8 (PB26A)
unnamed: R357.1, U40.F9 (PB26B)
unnamed: R365.1, U40.E6 (PB28A)
unnamed: R366.1, U40.E5 (PB28B)
unnamed: R364.1, U40.E7 (PB30A)
unnamed: R359.1, U40.F7 (PB30B)
unnamed: R355.1, U40.G5 (PB60A)
unnamed: R367.1, Y6.3 (OUT)
unnamed: R363.2, Y6.1 (~STB)
OSC_LVDS_ENABLE: U40.B3 (PT67A); also elsewhere on the board
SYS_PLL_INPUT: R367.2, U40.E3 (PR13A)
SubSPW_LVDS_SOUT_P: R355.2; also elsewhere on the board

Notes on the sheet:
BANK5
PCLKT1_2/EIO
SD2/SCL/USER_SCL
MISO/MD1/SD5
BANK0
BANK1
EIO
S7_IN
PCLKC5_2/ADC_CN2/COMP3N
JTAG
MD3/SD7/OSC_BURST
BANK3
PCLKT1_0/EIO
TDO/SSO/SD1
PMU_WAKEUPN/S4_OUT/EIO
24MHz clock
MD2/SD6
INITN
SD3/SDA/USER_SDA
S7_OUT
PCLKC5_3/VREF5_2
TCK/SCLK/PMU_EXT_CLK
PCLKT1_1/EIO
FPGA LFD2NX-17-7MG121I [Part 1/2]
TDI/SSI/SD0
MCSNO/MSDO
TMS/SCSN
PCLKT5_3
PCLKT5_2/ADC_CP2/COMP3P
PCLKT3_1/ADC_CP6
MOSI/MD0/SD4
MCSN/PCLKT0_1
PROGRAMN
Damping ringing Near ball
On power-up, if PROGRAMN is HIGH, FPGA enters Master SPI boot mode and loads bitstream from external QSPI flash. If PROGRAMN is held LOW, FPGA waits for Slave SPI/I2C configuration from an external host (SAMA7G54).

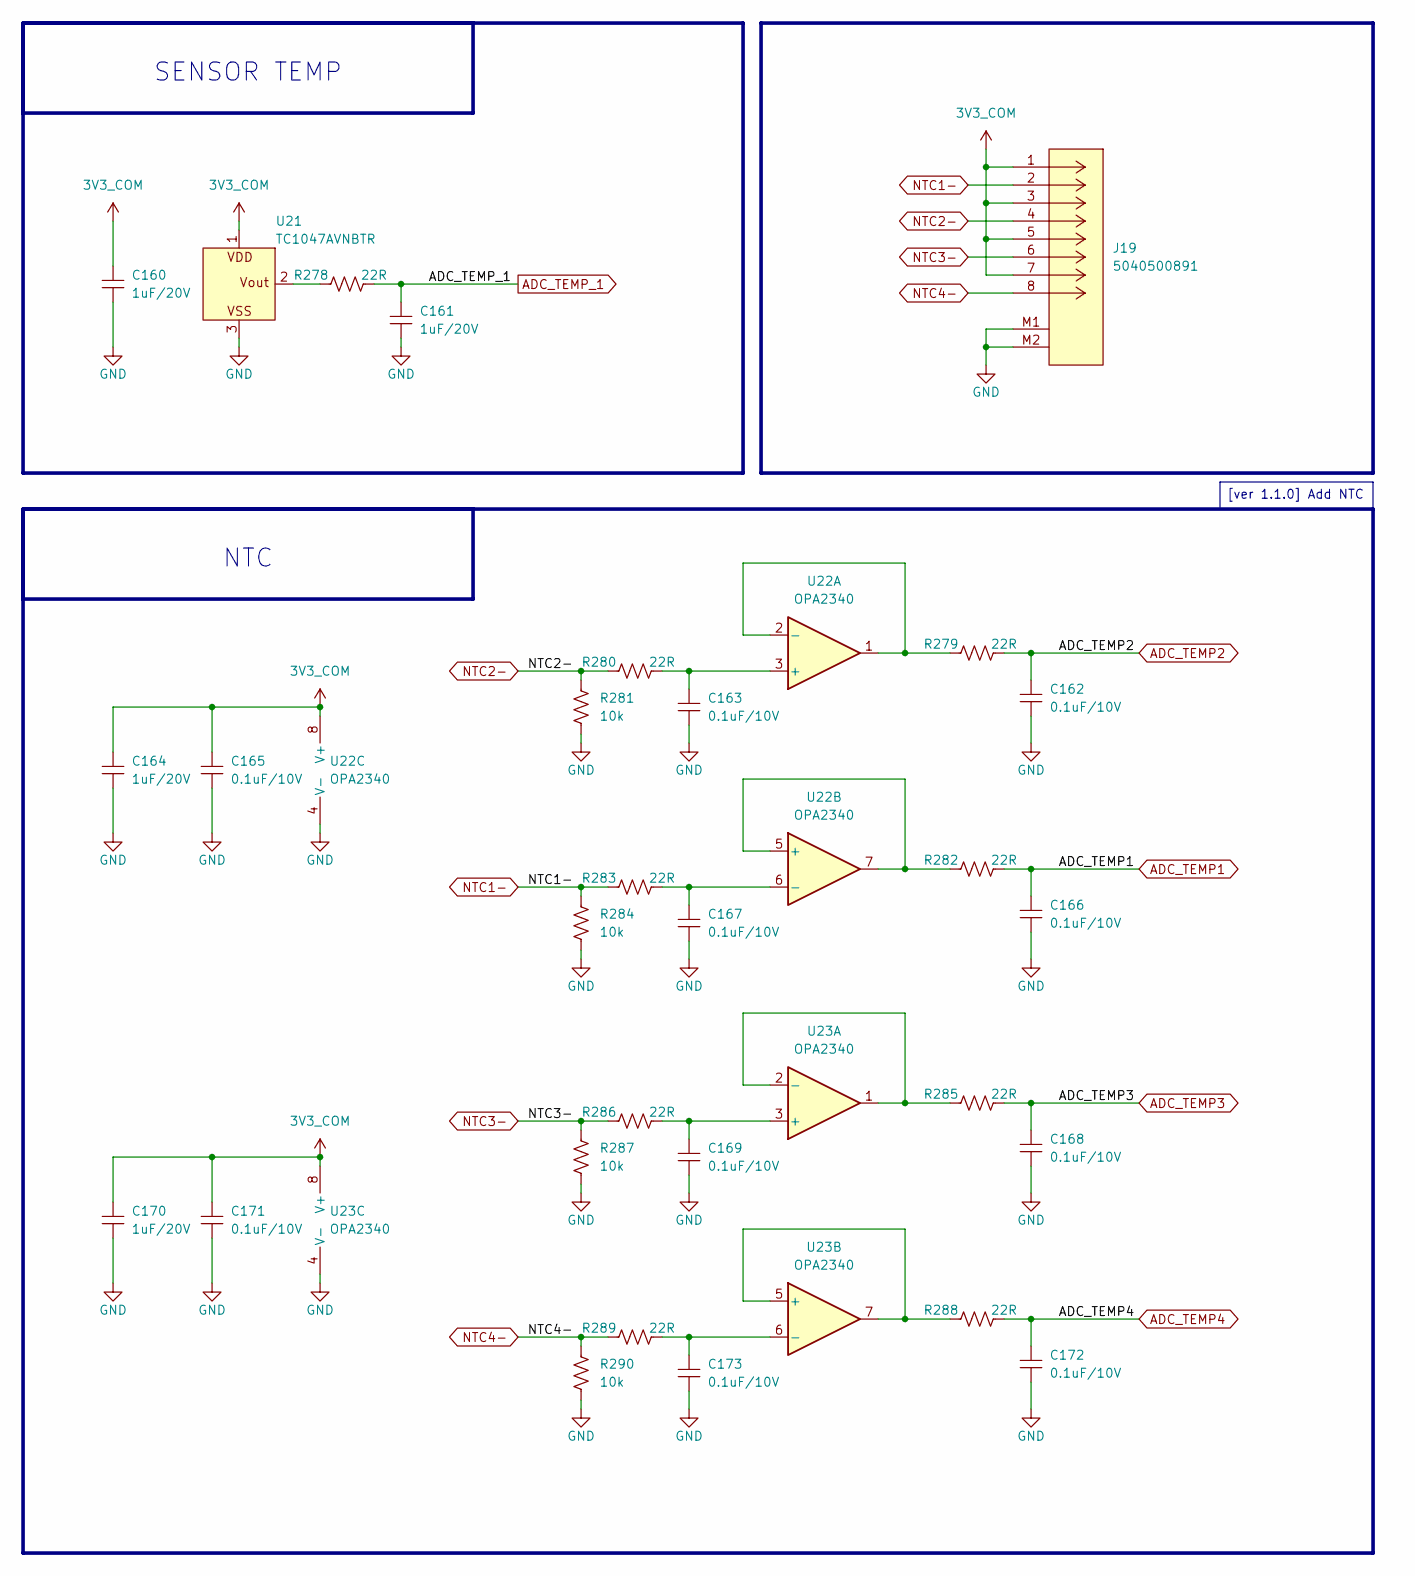
[picture p72: schematic TEMP.kicad_sch, BEE]

Parts:
C160, C161, C164, C170: 1uF/20V; CAP_C_1005X50_L
C162, C163, C165, C166, C167, C168, C169, C171, C172, C173: 0.1uF/10V; CAP_C_1005X50_L
J19: 5040500891; MOLEX_5040500891
R278, R279, R280, R282, R283, R285, R286, R288, R289: 22R; RES_C_1005x30_L
R281, R284, R287, R290: 10k; RES_C_1005x30_L
U21: TC1047AVNBTR; SOT-23_MC_MCH; Manufacturer_Part_Number TC1047AVNBTR
U22, U23: OPA2340; SOIC127P602X173-8N

Connections:
3V3_COM: C160.2, C164.2, C165.2, C170.2, C171.2, J19.1, J19.3, J19.5, J19.7, U21.1 (VDD), U22.8 (V+), U23.8 (V+); also elsewhere on the board
ADC_TEMP1: C166.2, R282.2; also elsewhere on the board
ADC_TEMP2: C162.2, R279.2; also elsewhere on the board
ADC_TEMP3: C168.2, R285.2; also elsewhere on the board
ADC_TEMP4: C172.2, R288.2; also elsewhere on the board
ADC_TEMP_1: C161.2, R278.2; also elsewhere on the board
GND: C160.1, C161.1, C162.1, C163.1, C164.1, C165.1, C166.1, C167.1, C168.1, C169.1, C170.1, C171.1, C172.1, C173.1, J19.M1, J19.M2, R281.2, R284.2, R287.2, R290.2, U21.3 (VSS), U22.4 (V-), U23.4 (V-); also elsewhere on the board
NTC1-: J19.2, R283.1, R284.1
NTC2-: J19.4, R280.1, R281.1
NTC3-: J19.6, R286.1, R287.1
NTC4-: J19.8, R289.1, R290.1
unnamed: R278.1, U21.2 (VOUT)
unnamed: C163.2, R280.2, U22.3 (+)
unnamed: R279.1, U22.1, U22.2 (-)
unnamed: R282.1, U22.5 (+), U22.7
unnamed: C167.2, R283.2, U22.6 (-)
unnamed: C169.2, R286.2, U23.3 (+)
unnamed: R285.1, U23.1, U23.2 (-)
unnamed: R288.1, U23.5 (+), U23.7
unnamed: C173.2, R289.2, U23.6 (-)

Notes on the sheet:
SENSOR TEMP
NTC
[ver 1.1.0] Add NTC
