taitannguyen17022005-dev/BEE-1012-PAY-IF-V110/01_DESIGN/BEE-1012_PAY-IF_V110/_restore_backup_2026-08-10T14-50-42-868/BEE-1012_PAY-IF_V110.kicad_pcb

## KiCad design 01_DESIGN/BEE-1012_PAY-IF_V110/_restore_backup_2026-08-10T14-50-42-868/BEE-1012_PAY-IF_V110.kicad_pcb (continued)

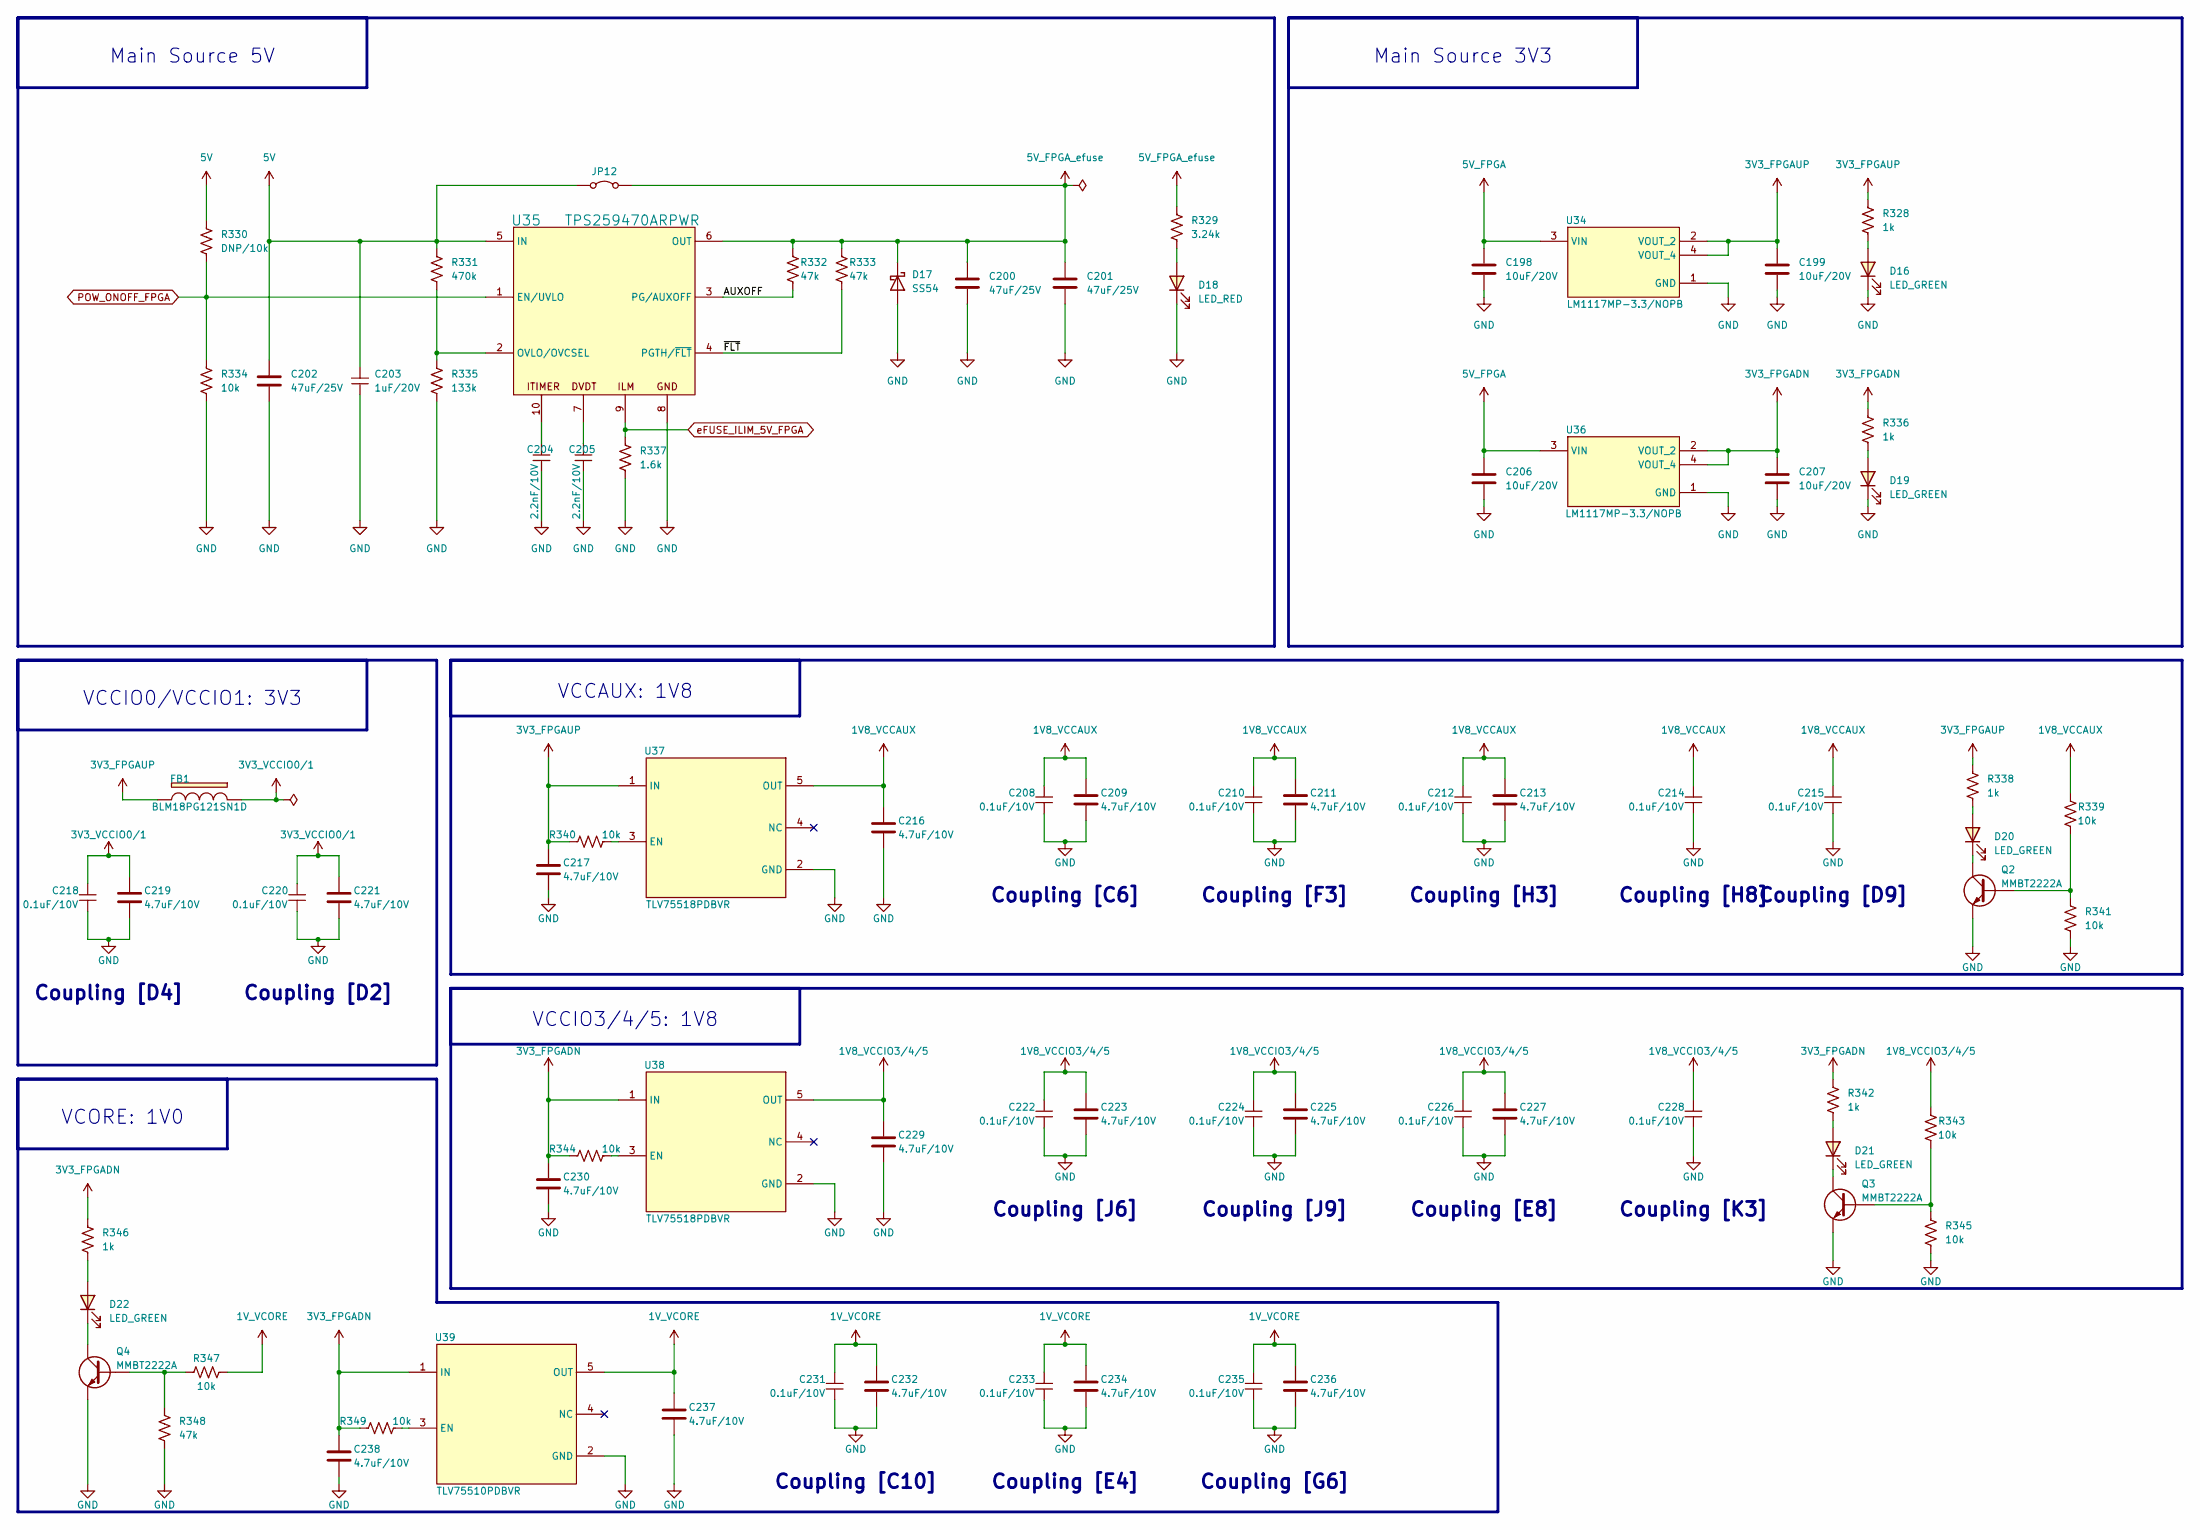
[picture p73: schematic FPGA_POWER.kicad_sch, BEE]

Parts:
C198, C199, C206, C207: 10uF/20V; CAP_C_1608X80_L
C200, C201, C202: 47uF/25V; CAP_C_3225X80
C203: 1uF/20V; CAP_C_1005X50_L
C204, C205: 2.2nF/10V; CAP_C_1005X50_L
C208, C210, C212, C214, C215, C218, C220, C222, C224, C226, C228, C231, C233, C235: 0.1uF/10V; CAP_C_0603x30
C209, C211, C213, C219, C221, C223, C225, C227, C232, C234, C236: 4.7uF/10V; CAP_C_1005X50_L
C216, C217, C229, C230, C237, C238: 4.7uF/10V; CAP_C_2012X110
D16, D19, D20, D21, D22: LED_GREEN; LED_0603_1608Metric
D17: SS54; D_SMA
D18: LED_RED; LED_0603_1608Metric
FB1: BLM18PG121SN1D; L_0603_1608Metric; Manufacturer_Part_Number BLM18PG121SN1D
JP12: Jumper_2_Bridged; JUMPER_1608
Q2, Q3, Q4: MMBT2222A; SOT95P240X120-3N
R328, R336, R338, R342, R346: 1k; RES_C_1005x30_L
R329: 3.24k; RES_C_1005x30_L
R330: DNP/10k; RES_C_1005x30_L
R331: 470k; RES_C_1005x30_L
R332, R333, R348: 47k; RES_C_1005x30_L
R334, R339, R340, R341, R343, R344, R345, R347, R349: 10k; RES_C_1005x30_L
R335: 133k; RES_C_1005x30_L
R337: 1.6k; RES_C_1005x30_L
U34, U36: LM1117MP-3.3/NOPB; SOT-223
U35: TPS259470ARPWR; VQFN-HR-10
U37, U38: TLV75518PDBVR; SOT-23-5; Manufacturer_Part_Number TLV75510PDBVR
U39: TLV75510PDBVR; SOT-23-5; Manufacturer_Part_Number TLV75510PDBVR

Connections:
1V8_VCCAUX: C208.2, C209.1, C210.2, C211.1, C212.2, C213.1, C214.2, C215.2, C216.1, R339.2, U37.5 (OUT); also elsewhere on the board
1V8_VCCIO3/4/5: C222.2, C223.1, C224.2, C225.1, C226.2, C227.1, C228.2, C229.1, R343.2, U38.5 (OUT); also elsewhere on the board
1V_VCORE: C231.2, C232.1, C233.2, C234.1, C235.2, C236.1, C237.1, R347.2, U39.5 (OUT); also elsewhere on the board
3V3_FPGADN: C207.1, C230.1, C238.1, R336.1, R342.1, R344.1, R346.1, R349.1, U36.2 (VOUT_2), U36.4 (VOUT_4), U38.1 (IN), U39.1 (IN)
3V3_FPGAUP: C199.1, C217.1, FB1.2, R328.1, R338.1, R340.1, U34.2 (VOUT_2), U34.4 (VOUT_4), U37.1 (IN)
3V3_VCCIO0/1: C218.2, C219.1, C220.2, C221.1, FB1.1; also elsewhere on the board
5V: C202.1, C203.2, JP12.1 (A), R330.1, R331.1, U35.5 (IN); also elsewhere on the board
5V_FPGA: C198.1, C206.1, U34.3 (VIN), U36.3 (VIN); also elsewhere on the board
5V_FPGA_efuse: C200.1, C201.1, D17.1 (K), JP12.2 (B), R329.1, R332.1, R333.1, U35.6 (OUT); also elsewhere on the board
/FPGA_POWER/AUXOFF: R332.2, U35.3 (PG/AUXOFF)
/FPGA_POWER/~FLT: R333.2, U35.4 (PGTH/~FLT)
GND: C198.2, C199.2, C200.2, C201.2, C202.2, C203.1, C204.1, C205.1, C206.2, C207.2, C208.1, C209.2, C210.1, C211.2, C212.1, C213.2, C214.1, C215.1, C216.2, C217.2, C218.1, C219.2, C220.1, C221.2, C222.1, C223.2, C224.1, C225.2, C226.1, C227.2, C228.1, C229.2, C230.2, C231.1, C232.2, C233.1, C234.2, C235.1, C236.2, C237.2, C238.2, D16.1 (K), D17.2 (A), D18.1 (K), D19.1 (K), Q2.E, Q3.E, Q4.E, R334.2, R335.2, R337.2, R341.2, R345.2, R348.2, U34.1 (GND), U35.8 (GND), U36.1 (GND), U37.2 (GND), U38.2 (GND), U39.2 (GND); also elsewhere on the board
unnamed: D16.2 (A), R328.2
unnamed: D18.2 (A), R329.2
unnamed: D19.2 (A), R336.2
unnamed: D20.2 (A), R338.2
unnamed: D20.1 (K), Q2.C
unnamed: D21.2 (A), R342.2
unnamed: D21.1 (K), Q3.C
unnamed: D22.2 (A), R346.2
unnamed: D22.1 (K), Q4.C
unnamed: Q2.B, R339.1, R341.1
unnamed: Q3.B, R343.1, R345.1
unnamed: Q4.B, R347.1, R348.1
unnamed: C205.2, U35.7 (DVDT)
unnamed: C204.2, U35.10 (ITIMER)
unnamed: R331.2, R335.1, U35.2 (OVLO/OVCSEL)
unnamed: R340.2, U37.3 (EN)
unnamed: R344.2, U38.3 (EN)
unnamed: R349.2, U39.3 (EN)
POW_ONOFF_FPGA: R330.2, R334.1, U35.1 (EN/UVLO); also elsewhere on the board
eFUSE_ILIM_5V_FPGA: R337.1, U35.9 (ILM); also elsewhere on the board

Notes on the sheet:
VCCAUX: 1V8
Main Source 5V
Coupling [F3]
Coupling [C10]
Coupling [D9]
Coupling [H8]
Coupling [E4]
VCCIO3/4/5: 1V8
VCORE: 1V0
Coupling [D2]
Coupling [K3]
Coupling [D4]
Coupling [J6]
Coupling [J9]
Main Source 3V3
Coupling [C6]
VCCIO0/VCCIO1: 3V3
Coupling [H3]
Coupling [E8]
Coupling [G6]

Board: 2 copper layers, 803 parts (0 on the bottom side), 606 nets, no tracks yet.
