taitannguyen17022005-dev/BEE-1012-PAY-IF-V110/(commit log)

2026-07-25 Chore: Khoi tao cau truc thu muc va file.gitignore
    [BEE-1012_PAY-IF_V110.kicad_pcb, BEE-1012_PAY-IF_V110.kicad_sch, BLOCK DIAGRAM.kicad_sch, COVER PAGE.kicad_sch, INDEX.kicad_sch, POWER TREE.kicad_sch]
2026-08-20 Placement Done
    [BEE-1012_PAY-IF_V110.kicad_pcb, BEE-1012_PAY-IF_V110.kicad_sch, BLOCK DIAGRAM.kicad_sch, BNO085.stp, BUTTON_LED.kicad_sch, CAN_PHY.kicad_sch, COMM.kicad_sch, CONNECTOR_EXP.kicad_sch]
2026-09-21 Done Layout
    [CAN_PHY.kicad_sch, CONNECTOR_EXP.kicad_sch, CONNECTOR_INTERFACE.kicad_sch, SAMA7G54_PIO.kicad_sch, TEMP.kicad_sch, WATCHDOG.kicad_sch]
