taitannguyen17022005-dev/BEE-1012-PAY-IF-V110/(notices)

Notices in the files:
parts and their libraries:
Copyright: Copyright (C) 2025 Ultra Librarian. All rights reserved.
Copyright: Copyright (C) 2026 Ultra Librarian. All rights reserved.
